Axram/CubeProject/README.md

# CubeProject
Bachelor project at KTH [1] during spring 2015, about balancing a cube using a reaction wheel

1: Royal Institute of Technology, Stockholm Sweden
