Axram/CubeProject/80%/80seminar.pptx

## 80% Seminar

Balancing cube

## Research question

- How does sensor placement effect the quality of the sensor data

## Current status

- Main construction finished
- Motor control
- IMU (until yesterday…)
- Encoder

## To Do’s

- Encoder!
- Control theory adjustments
- Wrap it up
