Axram/CubeProject/50%/PPT50.pptx

## Cube project

50% Seminar

## Research question

- ”If balance is maintained how does the maximum applied force correlate to the rise time and overshoot separately, can any conclusions be drawn from the results?”
- Could need an interation as it’s a bit focused on the control theory

## Current status

- Software Simulink model
- Hardware Main construction Motor IMU

## Future problems

- Software IMU filtering Implementing control theory
- Hardware Lathing the flywheel Mounting subsystems
