Axram/CubeProject/Thesis/kth-cover.pdf

DEGREE PROJECT, IN MECHATRONICS , FIRST LEVEL STOCKHOLM, SWEDEN 2015

# Reaction wheel balanced robot

## DESIGN AND SENSOR ANALYSIS OF INVERTED PENDULUM ROBOT

## ALEXANDER RAMM & MIKAEL SJÖSTEDT

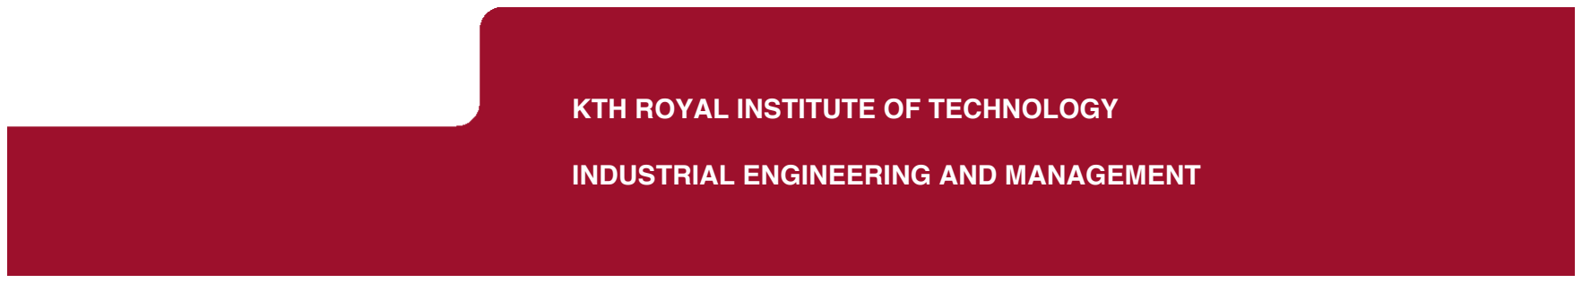
[picture p21: figure]
KTH ROYAL INSTITUTE OF TECHNOLOGY; INDUSTRIAL ENGINEERING AND MANAGEMENT

TRITA MMK 2015:18 MDAB071

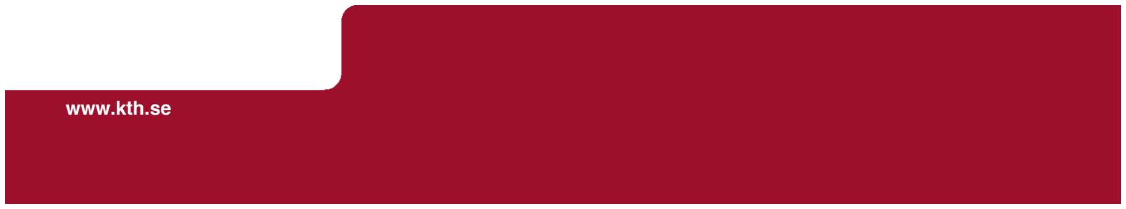
[picture p22: figure]
www.kth.se
