Axram/CubeProject/Thesis/Kalmanturnzoom-eps-converted-to.pdf

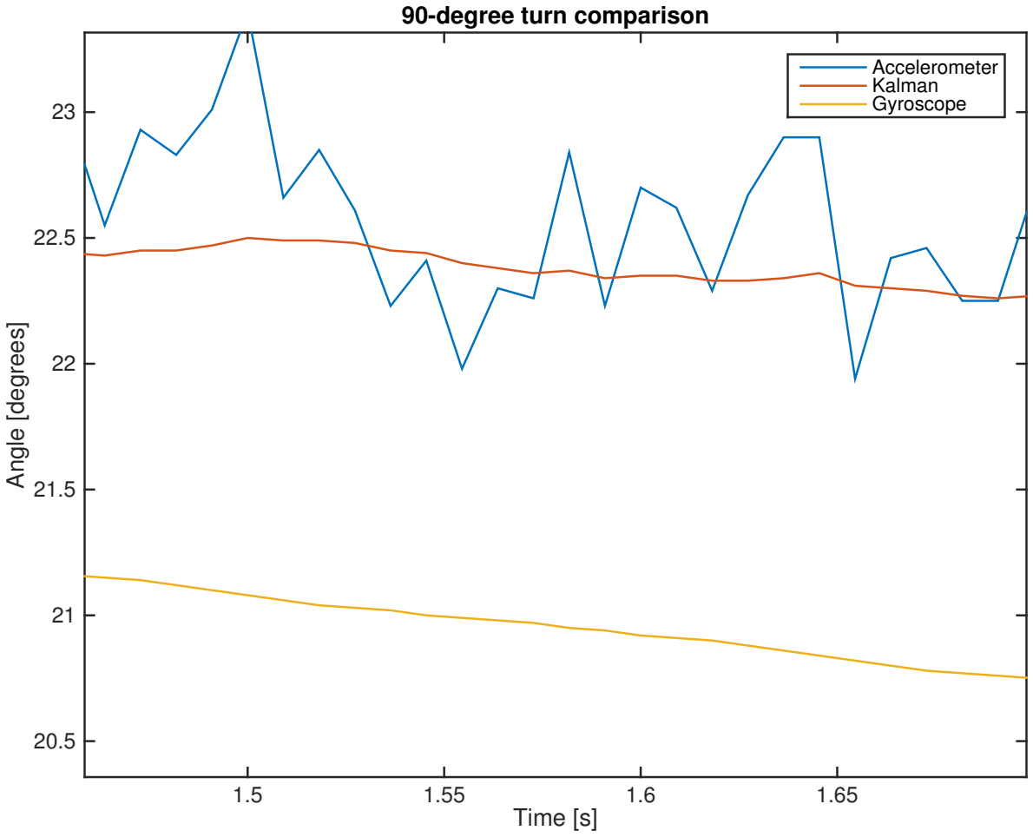
[picture p27: figure]
Time [s]; Angle [degrees]; 90-degree turn comparison; Accelerometer Kalman Gyroscope
