Axram/CubeProject/Mixed/reff kub.pdf

# Controlling the Reaction Wheel Pendulum

### Geoffrey Chauveau, Damien Chazal, Daisuke Nakayama Erik Olsen, Staffan Palm

### May 25, 2005

# Abstract

The goal of this project is to control a complicated mechanical plant. The plant is an inverted pendulum freely swinging around its axis. A DC-motor is attached at its outer end, running a heavy wheel which is freely spinning in the air. The only way to apply torque to the pendulum is to accelerate this wheel.
The motor and the wheel are too weak to swing the pendulum straight to its upright position, that is why energy must be accumulated over several swings to get it upright.
A model of the plant is derived from laws of physics and by doing tests and measurements. The model is verified by simulating step responses and comparing those to step responses of the real plant.
A hybrid automaton switches between two states depending on the position of the pendulum, the swinging state which swings the pendulum to the upright position and the balancing state which keeps the pendulum upright.
The swinging state uses a bang-bang energy controller to ensure the pendulum reaches the upright position with the right amount of speed.
The plant is time-continuous and the controller needs to be implemented in a time-discrete form. Two different approaches were used for the design of the balancing controller, depending on where the discretization was realized. Linear Quadratic (LQ) design of controllers has been used for both of these approaches.
The controller designed for a continuous plant works fine as long as the sampling frequency is higher than about 15 times the highest natural frequency of the plant. For lower sampling frequencies the discrete designed controllers gave better results. They worked well up to a sampling frequency of about 10 times the highest natural frequency, which fits well with classical rules of thumb.

# Contents

Introduction | 1
1 The Plant | 2
2 Control System | 10
3 Implementation and Development Environment | 24
Conclusion | 27
Bibliography | 29
Appendix | 30

CONTENTS | 3
A Tests | 30
B Filtering of Data | 35

# Introduction

This project is part of the project course in automatic control of the S3 department of the Royal Institute of Technology (KTH) in Stockholm. The goal of this school project is to control a complicated mechanical plant.
The plant is an inverted pendulum freely spinning around its axis moving thanks to a reaction wheel at its outer end.
Our aim is to swing the pendulum to the upright position and keep it stable. Sensors give information about the angles of the pendulum and the wheel, and the controller is implemented on a Texas Instruments digital signal processor. The final result will be a completely embedded system, which only needs power supply to run.
One industrial application of reaction wheels is to adjust the angles of satellites in space. This phenomenon is also observed in motorcycling: pilots use the acceleration of their rear wheels to tilt the angle of the motorcycle when they jump.

# Chapter 1

# The Plant

This chapter describes the pendulum and derives a mathematical model for it.

## 1.1 Description

The plant is an inverted pendulum freely spinning around its axis. A DC-motor is attached at its outer end. This motor runs a heavy wheel which is freely spinning in the air. The only way to apply a torque to the pendulum is to accelerate this wheel.
The motor and the wheel are too weak to swing the pendulum to its upright position in one swing. They need to add energy to the system with many swings to get it upright.
The system is based on a TI Digital Signal Processor that calculates the ouput, and an I/O daughter card that makes measurements using the two encoders and controls the DC motor using a PWM motor driver. The control system is built in C language, compiled and downloaded to a DSP memory.
Figure 1.1 shows the plant and some of the parameters.
Following is a complete list of the parameters (see Table 1.1).

## 1.2 Input and Output Signals

The output from the DSP, u, is a Pulse Width Modulated (PWM) signal. It means that the proportion of time when the signal is high is manipulated. This signal is sent to a motor driver chip (A3952) which transforms it to an analog signal. If this signal is a specific voltage or a specific current has been a subject of confusion. The chip is primarily designed to be a current control chip, though, after studying the circuitry and doing measurements of the output (see A.5 and A.6), it has clearly been shown that the controllable quantity is the voltage. The relation between the voltage and the PWM signal is unfortunately nonlinear. A nonlinear transfer function has been derived to calculate an PWM signal

1.2 Input and Output Signals | 3
θ | The angle of the pendulum with respect to ground, counted from upright position
˜θ | The angle of the pendulum with respect to ground, counted from downward position
ϕ | The angle of the wheel with respect to ground
ϕr | The angle of the wheel with respect to the pendulum
ω | The angular velocity of the wheel with respect to ground
ωr | The angular velocity of the wheel with respect to the pendulum
e | The back emf voltage from the motor
f | The torque between the wheel and the pendulum due to wet friction, ∼ 0 Ns/rad
g | The gravity constant, 9.81 m/s²
i | The current through the motor
Jp | The moment of inertia of the pendulum, 0.0045 kg.m²
Jw | The moment of inertia of the wheel and rotor, 2.13 · 10⁻⁵ kg.m²
kE | The back emf constant of the motor, 27.4 · 10⁻³ V.s/rad
kT | The torque constant of the motor, 27.4 · 10⁻³ N.m/A
l | The radius of the center of mass on the pendulum, including wheel, (mgl = 0.344 N.m)
L | The inductance of the motor, 6.27 mH
m | The mass of the pendulum, including wheel, (mgl = 0.344 N.m)
RT | The resistance of through the motor 12.1Ω
t | Time
Tg | The torque on the pendulum due to gravity
Tm | The torque applied by the reaction wheel to the pendulum
u | The output from the DSP, -10 to 10 (corresponds to the duty cycle of the PWM signal)
v | The voltage applied to the motor

Table 1.1: Variables and parameters of the project

1.2 Input and Output Signals | 4

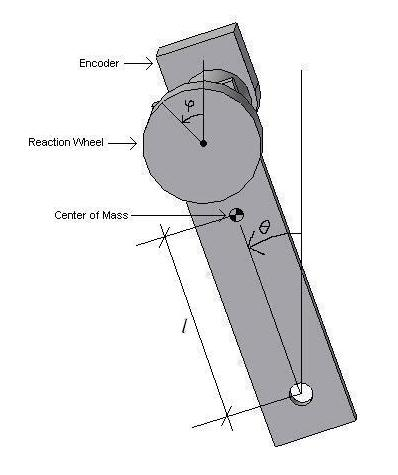
[picture p28: figure]

Figure 1.1: The different parameters of the plant.

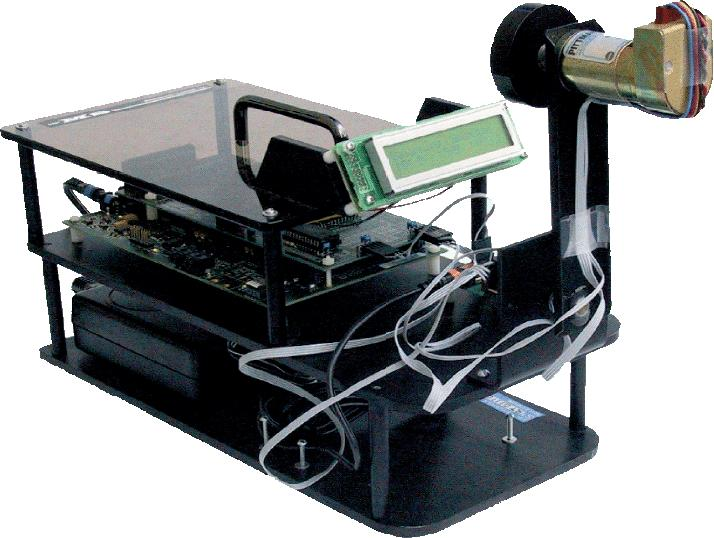
[picture p29: figure]

Figure 1.2: A picture of the whole plant.

from a demanded voltage (see A.8). The output from the controller should then be a voltage.
There are two output signals from the plant. The angle of the pendulum (θ) and the angle of the wheel (ϕ). The signals we are interested in for our controller are the angle of the pendulum (θ), the angular velocity of the pendulum (˙θ) and the angular velocity of the wheel (ω = ˙ϕ).

1.3 An Analytical Model | 5

The angular velocities are derived by differentiating the angles. The Euler backwards method is used for this. The angular velocities need to be filtered to reduce noise. The filter design is presented in Appendix B.
The angles of the wheel ϕr and the pendulum θ can be measured from two embedded encoders: the encoder on the motor can measure the angle of the wheel ϕr, and the optical shaft encoder of the pendulum measures its angle θ.
- DC Servo Motor

– Reference Voltage: 24 V

– Encoder Resolution: 1000 CPR

- Optical Shaft Encoder

– Encoder Resolution: 1000 CPR

## 1.3 An Analytical Model

The motor is a DC-motor whose equations are:

v = RT i + L

di
dt
+ e | (1.1)
e = kE(ω − ˙θ) | (1.2)
−Tm = kT i | (1.3)

The time constant for this inductance-resistor system equals to

τL =

L
R
= 0.518 ms | (1.4)

which is very much faster than the other dynamics in the plant. The fastest pole of the remaining system lies, according to 1.5.1, in -8.7473, which corresponds to a time constant of 114 ms. Hence this inductance is neglected.
The motion of the wheel and the pendulum is given by the torque equation:
Jwϕ¨ = Jwω˙ = −Tm − f(ω − ˙θ) | for the wheel | (1.5)

Jp

¨θ = Tm + Tg + f(ω − ˙θ) | for the pendulum with | (1.6)
Tg = mglsin θ | (1.7)

and the friction between the pendulum and ground is neglected according to A.3.
With the state variables isolated the equations become

1.4 Change of the State-Space Variables | 6

ω˙ = −

f
Jw

+

kEkT
JwRT
ω +
f
Jw

+

kEkT
JwRT
˙θ +

kT
JwRT
v | (1.8)

¨θ =

f
Jp

+

kEkT
JpRT
ω +

lmg
Jp

sin θ −

f
Jp

+

kEkT
JpRT
˙θ −

kT
JpRT

v (1.9)

The system can be linearized and described in state-space form with state xa = (ω, θ, ˙θ)
T and input voltage v.
x˙ a = Aaxa + Bav | (1.10)

where

Ba =

kT
JwRT
0
−

kT
JpRT
- (1.11)

and Aa depends on the linearization point. Linearizations around the two equilibrium points give:

θ around 0
(sin θ ∼ θ)

: Aa =

−

f
Jw

−

kEkT
JwRT

0

f
Jw

+

kEkT
JwRT
0 | 0 | 1

f
Jp

+

kEkT JpRT | lmg
| Jp

−

f
Jp
| | −

kEkT
JpRT
- (1.12)

θ around π
(sin θ ∼ −(θ − π))
θ substituted to ˜θ according to ˜θ = θ − π

: Aa =

−

f
Jw

−

kEkT
JwRT

0

f
Jw

+

kEkT
JwRT
0 | 0 | 1

f
Jp

+

kEkT JpRT | −lmg
| Jp

−

f
Jp
| | −

kEkT
JpRT

(1.13)
Different tests are performed to find out the values of the parameters, see A

## 1.4 Change of the State-Space Variables

The linearized model has been derived with absolute angles. However, to simplify the design of the controller with respect to the measured signals from the sensors, the use of the relative speed of the wheel is more relevant. Thus a change of the state variable ω must be done: ωr = ω − ˙θ.
If the state equation is denoted in this way:

ω˙
˙θ
¨θ
- = Aa

ω
θ
˙θ
- + Ba v

1.5 Analysis of the System | 7

then the modified state space equation with ωr is:

ω˙r
˙θ
¨θ
- = P Aa

ωr
θ
˙θ
- + P Ba v with P =

1 0 −1
0 1 | 0
0 0 | 1

New variables are defined according to x = (ωr, θ, ˙θ)
T
, A = P Aa and B =
P Ba.
The system is now described by
x˙ = Ax + Bv | (1.14)

## 1.5 Analysis of the System

### 1.5.1 Investigation of Poles and Zeroes

Our system has three poles and one zero. Figure 1.3 shows the location of the poles and zeroes for the linearization around the unstable equilibrium point. The pole in the right half plane shows that the system is unstable. The poles are located in (8.7164, -8.7473, -2.9093) and the zero is in the origin.
The two poles that are symmetrical around the origin are due to the inverted pendulum and the third pole (-2.9093) is due to the reaction wheel.
The zero can be explained by the fact that the wheel needs to be accelerated to get a torque on the pendulum, which requires changes in the voltage.

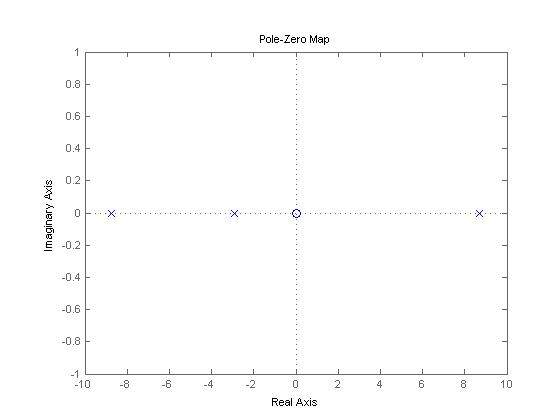
[picture p30: figure]

Figure 1.3: Poles and Zeros of the linearized model in the upright position.

1.6 Validating the Analytical Model | 8

### 1.5.2 Controllability and Observability

To be able to fully control the system it needs to be controllable. Therefore, the controlability matrix QC is calculated.

QC =

B AB A²B
=

106.8041 −314.0222 961.4548
0 | −0.5013 | 1.4739
−0.5013 | 1.4739 | −42.5101

Since det QC 6= 0, the process is fully controllable. All the states can then be controlled with the input signal v.
θ is measured directly with an encoder. The two other states, ˙θ and ωr are derived by differentiation (and filtering) of the sensor signals. Obviously our plant is observable as well.

## 1.6 Validating the Analytical Model

The analytical model derived in 1.3 will be verified by comparing its step response to a step response from the plant. Figure 1.4 shows the output signals θ and ωr for both the model and the process for a 10 volt step. Figure 1.5 shows the same data for a 5 volt step.

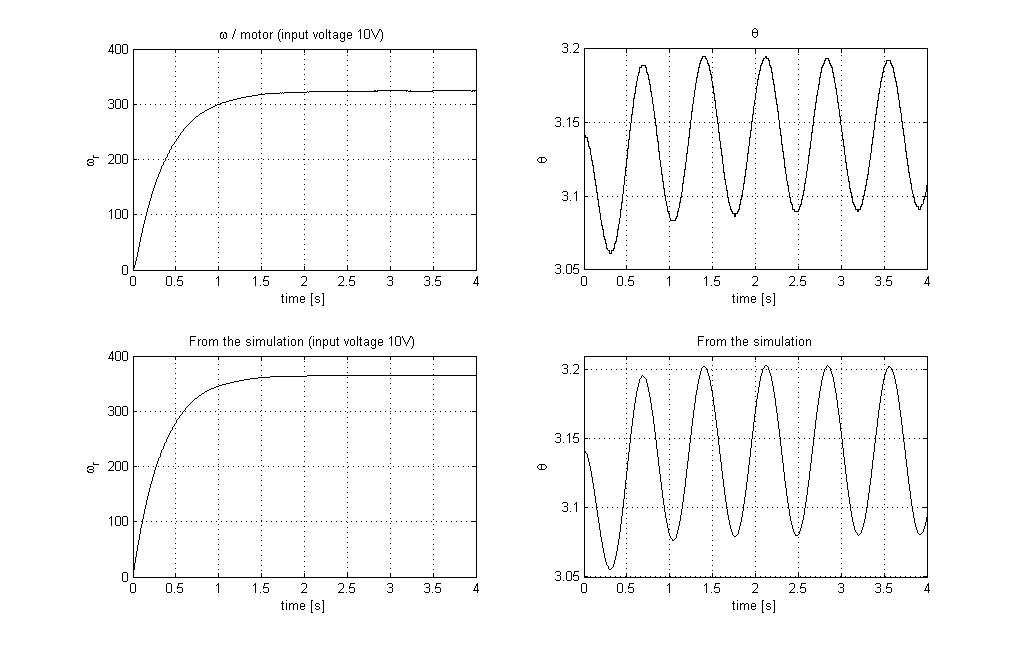
[picture p31: figure]

Figure 1.4: Output signals from model and process for a step of 10 volts.

The behaviours of the systems are very similar. The steady state angular velocity of the wheel ωr is always about 40 rad/s lower in the process than in

1.6 Validating the Analytical Model | 9

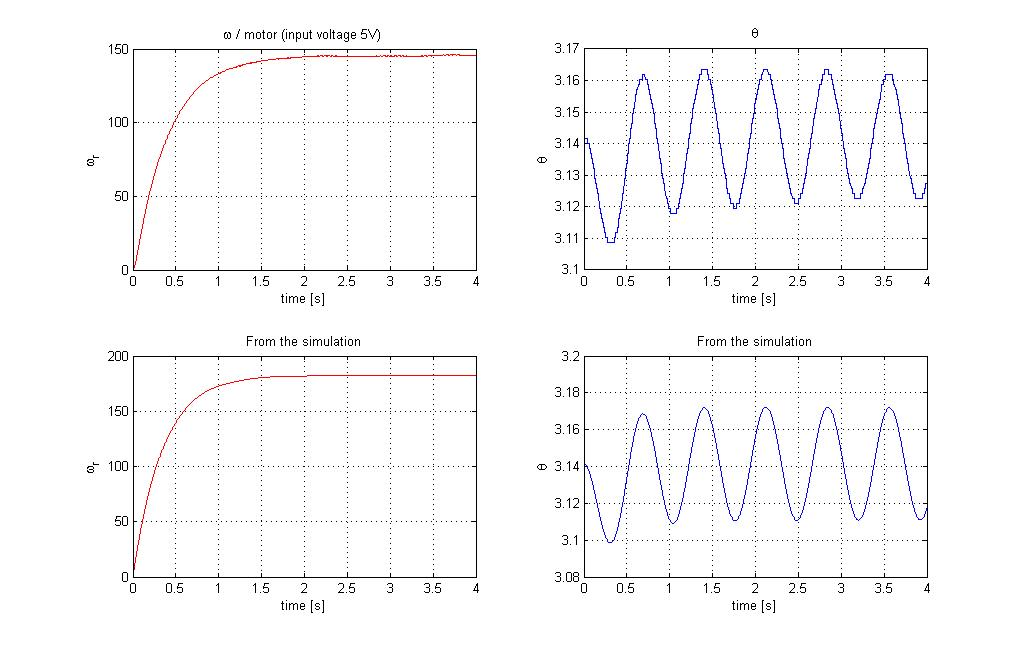
[picture p32: figure]

Figure 1.5: Output signals from model and process for a step of 5 volts.

the model, independent of the level of the input voltage, probably because of the neglected dry friction.

# Chapter 2

# Control System

The control system switches between different states. The hybrid automaton and the different controllers will be described in this chapter.

## 2.1 The Hybrid Automaton

The controller is implemented as an hybrid automaton that switches between two states during normal operation; the swinging state to swing the pendulum up and the balancing state to keep the pendulum in the upright position.
As Figure 2.1 shows, the active state depends on the position of the pendulum. The swinging state is active from the initial downward position until the pendulum enters the catch area around the upper position, where the balance controller is activated instead. The possible size of the catch area depends on the strength of the balance controller and the precision of the swing up function. Tests showed that a catch area starting 8 degrees from the top position worked fine.
Extra features can also be seen as states, for example the brake to return the pendulum to the downward position or to prevent the pendulum from damaging the cables.

## 2.2 The Swinging State

This chapter describes two ways of swinging up the pendulum.

### 2.2.1 Simple Swing Up

The aim of this controller is to make the pendulum go up as fast as possible. A solution is to give maximum torque to the pendulum to increase its speed in the direction it is going. The following controller was built:
u = −9 when ˙θ ≥ 0

2.2 The Swinging State | 11

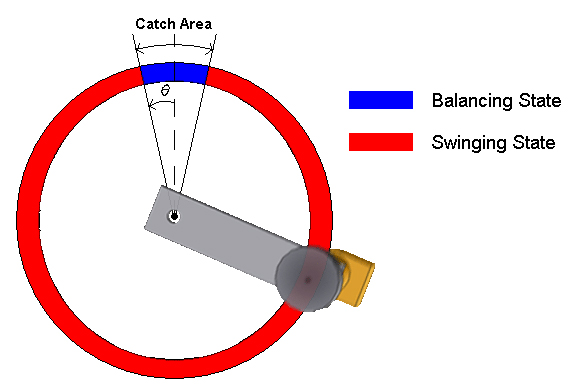
[picture p33: figure]

Figure 2.1: The two states depending on pendulum angle.

u = 9 when ˙θ < 0

It works pretty good but the angular velocity of the pendulum is often too high when it enters the catch area.

### 2.2.2 Energy Controlled Swing Up

To be able to make the pendulum arrive at its upright position with the right amount of speed, the total energy of the pendulum is monitored. For every sample, the energy of the pendulum is calculated as E =
1/2 Jp

˙θ
2 + mgl cos θ.
To validate the energy calculations, the total energy of a freely swinging pendulum was observed. Figure 2.2 shows the result. As expected, it was almost constant, decreasing slowly due to friction.
The target value for the total energy is the potential energy of the pendulum at the top position
| E0 = mgl

The controller is a simple bang-bang controller, accelerating when the energy is below the target value and braking when the energy is too high.
The final swing controller is:
| E < E0 | E ≥ E0
˙θ ≥ 0 | u=-9 | u=9
˙θ < 0 | u=9 | u=-9

The high braking values are useful when the pendulum is put to higher energy levels because of external disturbances.

2.3 The Balancing State | 12

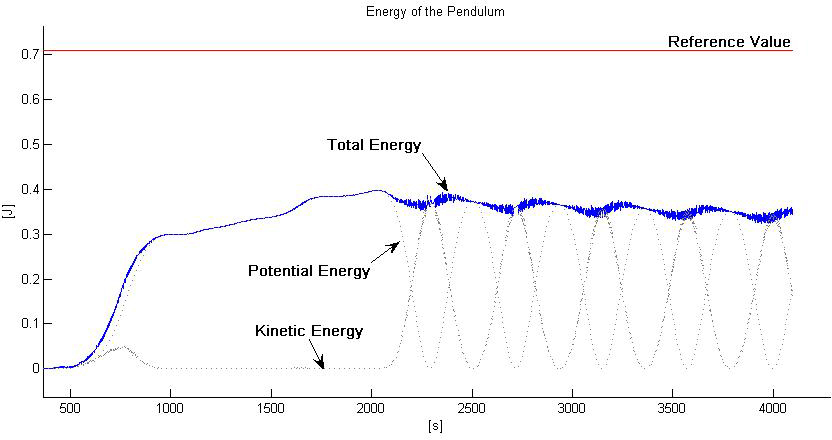
[picture p34: figure]

Figure 2.2: Energies of the pendulum when lifted and then released to swing freely.

## 2.3 The Balancing State

After being moved by the swinging process to its upright position, the pendulum is supposed to be in the linearized region around θ ∼ 0. Thus in the following section, the plant refers to the linear model that was derived previously for the upright position.

### 2.3.1 Preliminary Analysis of the Control System

Analysis of the Closed-Loop System

In our case, the plant is time-continuous and the implemented controller must be time-discrete since it is based on the sampled measurements of the system outputs. The control system of the plant can be represented by the block diagram on Figure 2.3.
The input signal is the voltage v and the output of the plant is y = (φr, θ)

T
The measurement of y consists of a uniform sampling at the sampling frequency

1
h

. In the feedback loop the controller computes a discrete command signal v[k] from the discrete outputs up to y[k]. Finally, a continuous input signal v(t) is generated after a zero-order hold circuit.

2.3 The Balancing State | 13

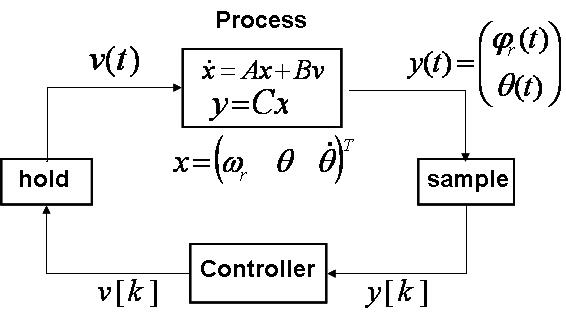
[picture p35: figure]

Figure 2.3: General block diagram of the controlled plant

Two Approaches of Controller Design

Two different methods are then available for the design of the discrete controller (see figure 2.4): a continuous-time design and a discrete-time design. The first one consists in building a continuous controller from the continuous model of the plant, and then discretizing it. The second one requires a preliminary discretization of the plant in order to build a completely discrete controller. These two approaches will be studied and compared in the next parts.

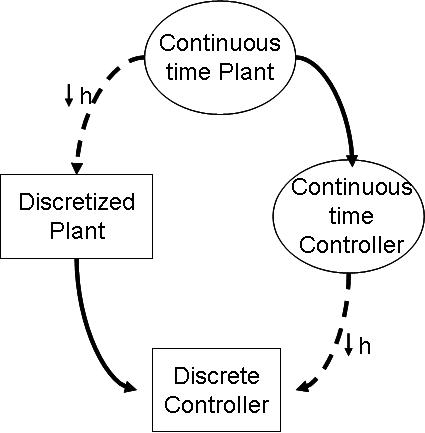
[picture p36: figure]

Figure 2.4: Design in continuous time and in discrete time.

2.3 The Balancing State | 14

### 2.3.2 Design in Continuous Time

In this part a controller based on the continuous plant is studied. This controller calculates the command signal v from the two outputs of the system φr and θ. However, an efficient controller should also depend on ωr and ˙θ. Therefore, state feedback controllers have been studied in this project.

The State Feedback Controller

In order to estimate the state variables x = (ωr, θ, ˙θ)
T
| , the angles φr and θ have
to be differenciated in the feedback loop. This operation is represented by the transfer function F(s) called a state observer, even though it is not really an observer. The feedback controller is called C(s) and is a linear combination of the state variables:
v = kωωr + kθθ + k ˙θ

˙θ

Figure 2.5 shows a block diagram of the continuous-time control system. The part that will be implemented on the real system corresponds to the dashedline rectangle. The discretization is realized by approximating the derivatives in F(s) with an Euler backward approximation: s =

z−1
| zh . The discrete controller is
represented in the block diagram in Figure 2.6.

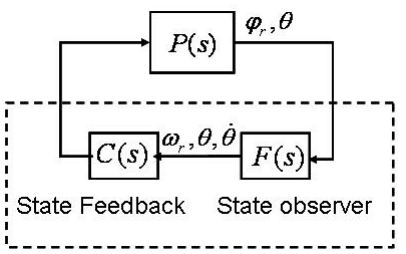
[picture p37: figure]

Figure 2.5: Block diagram of the continuous-time state feedback control system.

PD Controller

Since the variable of interest is θ, it is natural to investigate a controller in this form: v = kθθ + k ˙θ

˙θ, which is similar to a PD controller of the angle θ. In order to determine the coefficients (kθ, k ˙θ

), a pole placement analysis is performed. First, let us consider the transfer function Θ(s)
V (s)

, from the input voltage
to the pendulum angle:

Θ(s)
V (s)

=

−0.5013s
s

3 + 2.94s

2 − 76.15s − 221.8

2.3 The Balancing State | 15

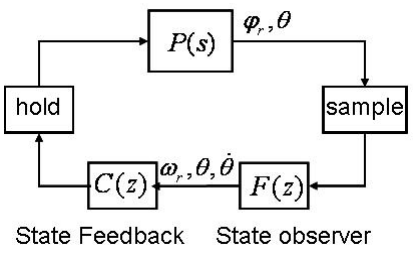
[picture p38: figure]

Figure 2.6: Block diagram of the real state feedback control system.

Generally speaking, since it is a single-input system, the linearized system around the upright position can lead to three separated transfer functions from the input voltage v to each state variable ωr, θ and ˙θ.
The plant can now be considered as a single-input single-output (SISO) system. The derivative part of the controller (k ˙θ

) introduces a zero on the real axis. If k ˙θ

is fixed, it is possible to plot the root locus of the closed-loop system, that is to say the closed-loop pole trajectories as a function of kθ. Figure 2.7 shows the root locus when k ˙θ = 6.6. The controller’s zero is represented by a triangle whereas the poles and zeroes of the plant are respectively crosses and circles. The three squares are the three closed-loop poles showing the location of the three different pole trajectories. The root locus shows that wherever the PD zero is placed, the closed-loop system will remain unstable due to the closed-loop pole on the positive real axis.

Complete State Feedback Controller

A more complete feedback controller must be used, using a feedback on the speed of the wheel ωr. Such a controller can be written as follows: v = kωωr +kθθ +k ˙θ

˙θ
In order to keep on analyzing the SISO system represented by the transfer function Θ(s)
V (s)

, the feedback on ωr is included in the state space representation:

x˙ = (A − BL)x + Bv , with L = (kω 0 0)

It is then possible to plot the root locus when kω = 0.1 and k ˙θ = 6.6 (see Figure 2.8). The closed loop system is now stable because all the closed-loop poles can be moved to the left part of the real axis. It is important to notice that the plant now has two unstable poles, which is due to the feedback loop on ωr. The following state feedback controller will be evaluated regarding stability and speed:
v = 0.1ωr + 400θ + 60 ˙θ

2.3 The Balancing State | 16

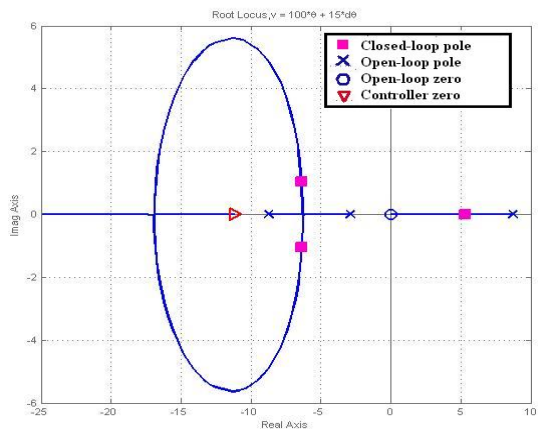
[picture p39: figure]

Figure 2.7: Root locus of the closed-loop system using a PD controller, k ˙θ = 6.6.

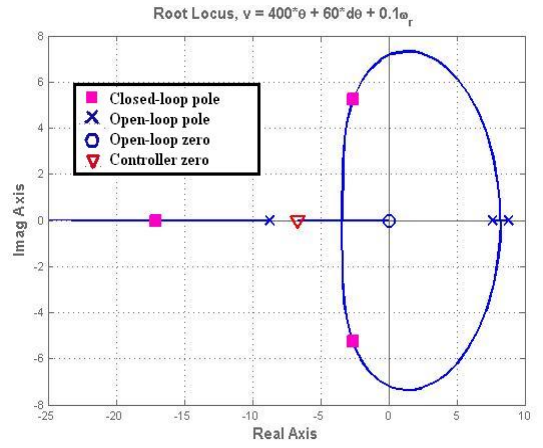
[picture p40: figure]

Figure 2.8: Root locus of the closed-loop system using a feedback controller, k ˙θ = 6.6 and kω = 0.1.

First of all, the Nyquist diagram of the open-loop is illustrated in Figure 2.9. According to the Nyquist criterion, the closed loop system is stable since there are two turns around -1, which is the exact number of positive real-part poles. Furthermore, the gain and the phase margins are respectively Gm = 3.93dB and

2.3 The Balancing State | 17

φm = 41.2

◦

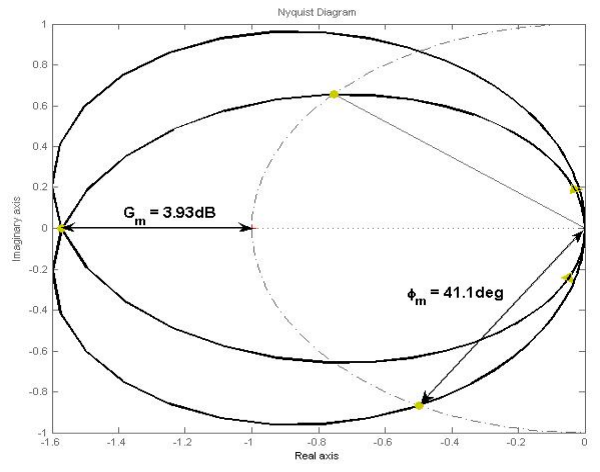
[picture p41: figure]

Figure 2.9: Nyquist diagram of the state feedback controller: v = 0.1ωr + 400θ + 60 ˙θ.

In the following acquisitions, the sampling period h is 1 ms. In Figure 2.10, the response to a step disturbance of 15V is illustrated. This experiment is done when the pendulum is stabilized around θ = 0. A disturbance signal of 15V is then added to the control signal, making the pendulum move away from its equilibrium point. The simulated and measured responses have the same behaviour exept for the final overshoot which is much higher for the real system. This is probably due to unmodelled nonlinearities. The conclusion is that in order to increase stability, it is necessary to avoid overshoots, since they become higher in reality.

LQ Controller

A method to design the coefficients (kω, kθ, k ˙θ

) for optimal performance is to use a Linear Quadratic (LQ) controller. Such a control law v is derived by minimizing a cost function depending on the weights Q, R and N:
J(v) = Z ∞

0

(x

TQx + v

TRv + 2x

TNv)dt

where x and v are linked to the state space equation : ˙x(t) = Ax(t) + Bv(t). Q and R are chosen in this way:

Q =

1 0 0
0 1 0
0 0 0
- R = 100 N = 0

2.3 The Balancing State | 18

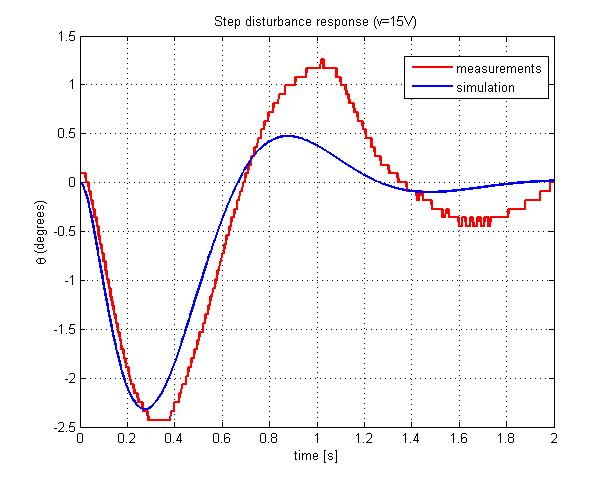
[picture p42: figure]

Figure 2.10: Step disturbance response (15V) for v = 0.1ωr + 400θ + 60 ˙θ

The choice of Q lies on the fact that more emphasis should be given to θ and ω. R is just a scaling factor and is set to 100 in order to avoid having a too high command voltage v that could saturate. Finally, N is equal to 0 because the cost due to the correlation between x and v has been neglected. For linear systems, there is a unique solution v = −Kx to this minimization which is expressed as the solution to the Riccati equation:

K = R

−1B
T S with SA + A

T S + Q − SQR⁻¹B
T S = 0

The numerical solution is then:

v = 0.1311ω + 688.1082θ + 78.9278 ˙θ

The Nyquist diagram is shown in Figure 2.11. The gain margin Gm = 6dB is much larger in this case and the phase margin φm = 60◦
is a characteristic value
for LQ controllers. The simulated and measured responses to a step disturbance of 15V illustrate this improved stability of the system (see Figure 2.12). The sampling period is still h = 1ms.
The LQ-controller that has been designed from the continuous plant leads to stable results as long as the sampling period is very small (≈ up to 50 ms as shown in Figure 2.13). This is due to the fact that the coefficients (kω, kθ, k ˙θ

)
do not depend on the sampling period, making the control system unadapted to every h. A way to tackle this problem is to take into account the transfer function of the zero-order-hold circuit ( ¹⁻e⁻sh
sh ) (see Figure 2.3) for the design of the continuous-time controller. Then C(s) should be based on P(s)
| 1−e⁻sh
| sh

2.3 The Balancing State | 19

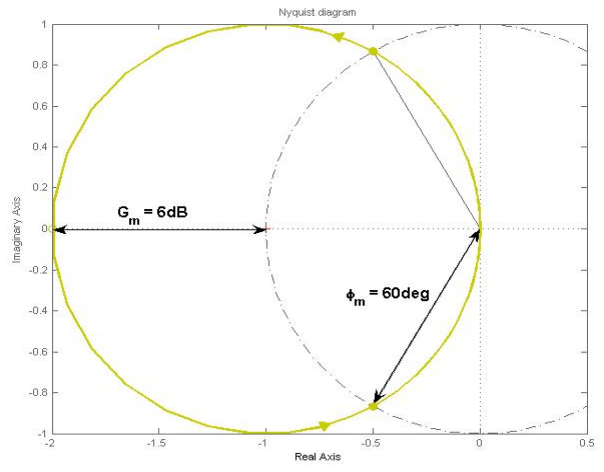
[picture p43: figure]

Figure 2.11: Nyquist diagram for the LQ-controller.

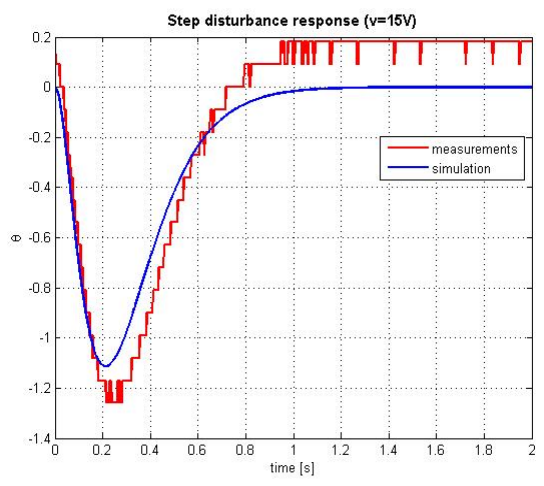
[picture p44: figure]

Figure 2.12: Step disturbance response (15V) for the LQ-controller.

instead of P(s). Unfortunately, this is not possible in our multivariable case because a single transfer function for the whole system P(s) can not be extracted. Consequently, the discrete approach of controller design will be investigated in order to handle different sampling periods.

2.3 The Balancing State | 20

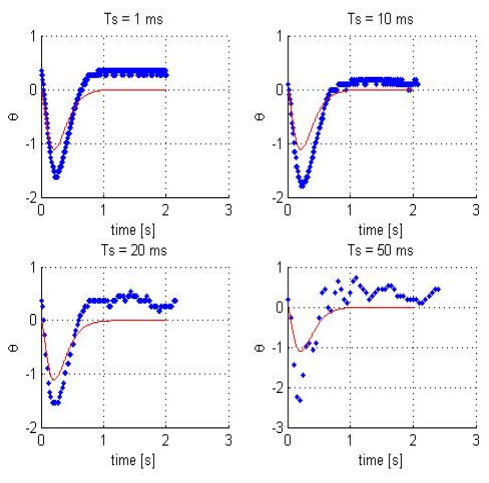
[picture p45: figure]

Figure 2.13: Step disturbance responses (15V) for the LQ-controller for different sampling periods.

### 2.3.3 Design in Discrete Time

Instead of estimating a discrete controller from a continuous one, another approach to control the pendulum is to build a discrete controller directly from the discrete model of the pendulum.

Discretized Plant

Around the equilibrium point, the system is almost linear, with the state-space equation ˙x = Ax+Bv. The plant can be sampled with a zero-order hold as input (since the computed input sent by Code Composer Studio is constant during the sampling period) and the resulting discrete system is:

x[k + 1] = Ad(h)x[k] + Bd(h)v[k]
with Ad(h) = e

Ah

, Bd(h) = R h
0

e

AsBds and h the sampling period

2.3 The Balancing State | 21
h[ms] | kωr | kθ | k ˙θ
1 | -0,12977 | -682,35 | -78,267
10 | -0,11873 | -633,95 | -72,712
50 | -0,083278 | -476,62 | -54,655
70 | -0,071475 | -423,13 | -48,515
80 | -0,066614 | -400,83 | -45,957
90 | -0,062329 | -381 | -43,681
100 | -0,058544 | -363,34 | -41,654
120 | -0,052235 | -333,47 | -38,228
150 | -0,045205 | -299,38 | -34,315

Table 2.1: Coefficients of the LQ controller for different sampling periods.

Discrete LQ Controller

After discretizing the plant, a discrete LQ controller can be designed. This controller is such that the cost function

Jd(v) = X∞

n=1

x[n]

TQdx[n] + v[n]

TRdv[n] + 2x[n]

TNdv[n]

is minimized. Since we want the same properties as the continuous LQ-controller, the matrix Qd, Rd and Nd are obtained by discretizing the matrix Q, R and N of the previous controller:
Qd Nd
NT
d Rd
=

Z h

0

Ad(τ ) 0
Bd(τ ) I
Q | N
NT | R

Ad(τ ) Bd(τ )
0 | I
dτ

With Matlab, different controllers v = −

kωrωr + kθθ + k ˙θ

˙θ

are easily obtained
for different sampling times (see Table 2.1).
After implementing this controller for different sampling periods, we observed that it works quite good up to 80 ms and begins to be unable to control the pendulum after a sampling period of 120 ms. Then, for higher sampling periods, the limit of the sampling is reached: a rule of thumb says indeed that h should be chosen such that 0.2 < ω0h < 0.6, with ω0 the natural frequency of the system (here ω0 = 8.75 rad/s). Therefore, we should not use sampling periods higher than 69 ms, which can explain the problems we have with high sampling periods. Then, some tests were done to investigate the stability of these controllers: a step of 5V is added to the calculated input of the system. We clearly observed that the system is less stable and oscillates more for high sampling periods (see Figure 2.14). The amplitude of the oscillations seems to be about proportional to the sampling time for such low sampling frequencies.

2.3 The Balancing State | 22

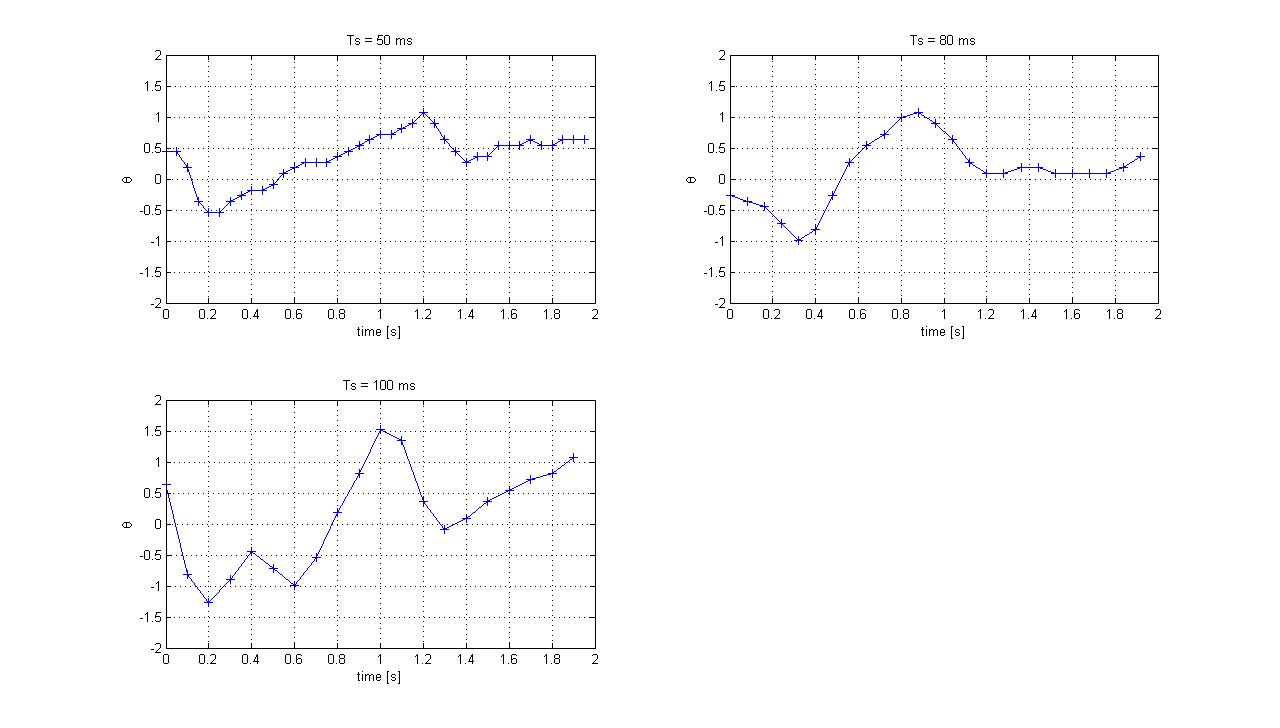
[picture p46: figure]

Figure 2.14: Stability of different discrete LQ controllers with sampling periods of 50ms, 80ms and 100ms.

Deadbeat Controller

Another idea was to build a completely discrete controller that has no equivalent in the continuous time-domain. The Deadbeat controller is a discrete controller that drives the state to the origin in at most n steps, with n the number of states variables (here n = 3). The controller is a state feedback v[k] = −Lx[k]. The state space equation then becomes:

x[k + 1] = (Ad − BdL)x[k] = Ac(L)x[k]

If the characteristic polynomial of Ac(L) is P(X), then we have

P (Ac(L)) = 0M3(R) (Cayley-Hamilton theorem)

The DeadBeat controller is such that all closed-loop poles are put at the origin (ie P(X) = X³

). Therefore, (Ac(L))³ = 0 and

x[n] = (Ac(L))n
x[0] = 0 if n ≥ 3

With Maple and Matlab, different matrices L = (lωr , lθ, l ˙θ

)

T were derived
depending on the sampling period h (see Table 2.2).
A simulation is done for h = 80ms and the controller seems to work perfectly: θ goes to zero in three steps (see Figure 2.15). However the coefficients for low

2.3 The Balancing State | 23
h[ms] | lωr | lθ | l ˙θ
1 | −1, 2371 · 10⁵ | −3, 9951 · 10⁶ | −2, 636 · 10⁷
10 | -125,3 | -40564 | -27060
50 | -1,0733 | -1838,3 | -301,96
70 | -0,4137 | -1028,5 | -141,17
80 | -0,28741 | -829,4 | -108,06
90 | -0,21064 | -692,39 | -86,94
100 | -0,16126 | -594,13 | -72,674
120 | -0,10489 | -465,84 | -55,195
150 | -0,066718 | -360,94 | -41,877

Table 2.2: Coefficients of the Deadbeat controller for different sampling periods.

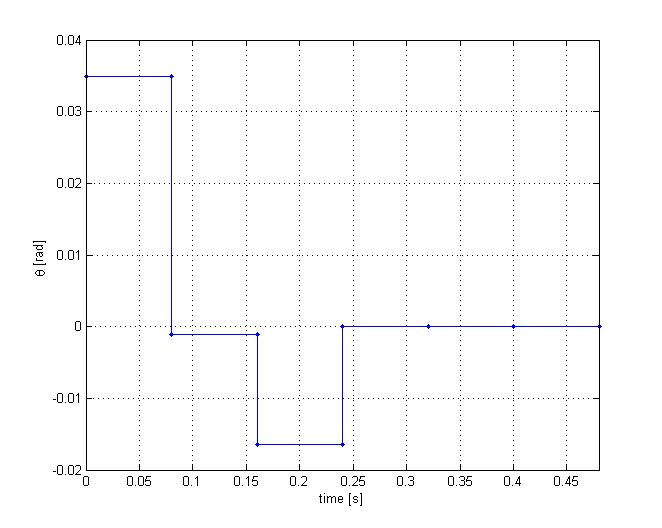
[picture p47: figure]

Figure 2.15: Simulation of the Deadbeat controller with h=80ms.

sampling periods are not realistic: the input voltage must reach several hundreds of volts to stabilize the system rapidly (in a few milliseconds). In practice, a sampling period of 80ms is the minimum for the input signal not to saturate. The problem is that the pendulum is not stable for a long time: after a few seconds, the pendulum falls down. This comes from the fact that this controller is very fast and therefore not very stable. Moreover, the sampling period is certainly too high to have an efficient controller (h > 69 ms).

# Chapter 3

# Implementation and Development Environment

## 3.1 Implementation

The implementation of the controller has been realized in Code Composer Studio. This software is used to compile a C-language program and then load it on a DSP card. We were given a collection of basic functions used for the interface with the daughter card but except these functions, everything has been implemented right from the beginning.
All the control algorithms are performed in a periodic function. This periodic function runs every millisecond and has the following structure:
- Tasks in the Periodic Function
1. Set the previous values of Theta and Phi

– ThetaPrevious = Theta
– PhiPrevious = Phi
2. Get data theta and phi from encoders

– ReadFromEncoders(Theta, Phi)

3. Calculate angular velocities

– DTheta = (Theta - ThetaPrevious) / h – DThetaFiltered = filter(DTheta)
– DPhi = (Phi - PhiPrevious) / h
– DPhiFiltered = filter(DPhi)
4. Calculate the output

– Output = controller(DphiFiltered, Theta, DThetaFiltered)

5. Send the output signal to the motor
6. Write information on the LCD

3.2 User Interface | 25

The sampling period is increased artificially by making the periodic function enter an idle loop for a certain time. The reason is that it is then possible to use different sampling periods only by pressing a switch. Of course the periodic function can be specified to run every sampling period in order to study the real effects of the sampling rate on computation time. However, since the CPU-load was always below 5% , it was useless to consider such limitations.

## 3.2 User Interface

An interaction with the system was made possible thanks to a set of switches and LEDs whose actions were parameterized in the software. Moreover, several buffers and log files have been used for data acquisitions since they were not performed in real time.

### 3.2.1 LCD

The display is the main part of the user interface and has also been used for debugging. The state of the hybrid automaton, the controller name, the angle of the pendulum, the output voltage and the sampling period are shown on the LCD (see Figure 3.1)

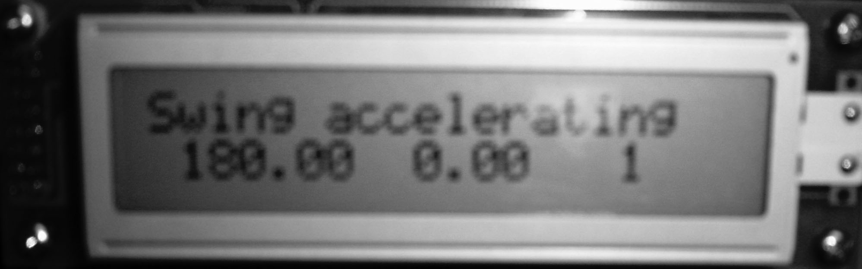
[picture p48: figure]

Figure 3.1: User interface: controller, angle θ, input voltage v, sampling period [ms].

3.2 User Interface | 26

### 3.2.2 Switches

Three switches are used to choose a controller and initialize encoders. As shown below, four types of experiments can be done.

SW1 SW2 SW3 | Controller
OFF OFF OFF ON OFF OFF ON ON OFF OFF ON OFF OFF ON ON ON ON ON | No Control Continuous LQ Controller (Sampling time: 1[ms]) Continuous LQ Controller (Sampling time: 80[ms]) Discrete LQ Controller (Sampling time: 80[ms]) Deadbeat Controller (Sampling time: 80[ms]) Initialize two encoders

# Conclusions

During this project, two different approaches were used to design controllers: estimate a discrete controller from a continuous one or create a discrete controller directly from a discretized model of the plant. The second approch gave better results, since LQ-controllers created this way were especially designed for particular sampling times. The Deadbeat controller seemed to be a good idea, but it was not possible to implement it properly.
The controllers that were obtained worked well and were quite efficient, which shows that our modelling of the system was quite accurate. The energy controller swings the pendulum up rapidly and makes it arrive in the catch area with low speed; both continuous and discrete LQ-controllers stabilize the pendulum quickly. Moreover, the balancing controllers were really robust to disturbances (a step of 20 volts could be added to the continuous LQ-controller at high sampling frequencies without problem). For lower sampling frequencies, when the discre LQ-controllers were used, the effects of the disturbance on control signals seemed to be about proportional to the sampling time.
However, what was not expected in this project was all the problems encountered with hardware and software. The biggest issue was handling Code Composer Studio. Most of the problems occured because of this software and it took several weeks to do all that we wanted with it. That is why this was the most difficult part of the project. The other problems came from the sensor of the wheel that did not work properly, the LCD controller that was difficult to implement and other side tasks. Therefore, most of the time was not spent on automatic control but on solving hardware and software problems.
But the fact that we began from a point where almost nothing was implemented in the software gave us control on everything we did: the use of periodic functions, the acquisition of data from sensors, the implementation of controllers... This allowed us to avoid many unexpected results and deal with problems more easily when they occured.

Of course, this project was limited in time and some points could have been improved. For example, the modelling could have been done by using the System Identification Toolbox of Matlab. This could have given us a more accurate model, especially for all disturbances and frictions that were neglected. However,

3.2 User Interface | 28

we were able to build controllers from our model that were satisfying. More important, an observer can be used to derive the state variables we cannot measure directly (˙θ and ωr), instead of calculating them by Euler approximation. This gives often better results. Finally, other kinds of controllers than state-feedback ones can be used: some built from a non-linear model (like exact feedback linearization) or other independant of the model (like a fuzzy controller).

This project was the opportunity for us to experience the topic of embedded systems. This requires a knowledge of many different fields such as modelling, signal processing, control theory and computer science. Consequently, it was an asset (quite unexpected) to have team members with different technical backgrounds. This course helped us to become familiar with project management and team work for a long period. Finally, we learnt a lot during these two months and had a pleasure doing this project.

# Bibliography

- Reglerteori - Flervariabla och olinj¨ara metoder - Torkel Glad and Lennart Ljung
- Hybrid and Embedded Control Systems - Lecture notes - Karl Henrik Johansson (KTH)
- Automatique 2003 - Compendium - Collectif automatique (Suplec)
- Nonlinear Control - Lecture notes - Karl Henrik Johansson and Bo Wahlberg (KTH)

# Appendix A

# Tests

## A.1 Measurement of mgl

With the pendulum horizontal, a scales was placed under the wheel to measure the weight of the pendulum. The radius where the scales was located was also measured. Using the measured values, the torque mgl can be calculated.

m = 0.27 kg, | l = 0.13 m, | g = 9.81 m.s⁻²
| mgl = 0.344 N.m
A.2 | Measurement of Jp

The moment of inertia Jp can be calculated by using the pendulum equation (1.9) without frictions or running the motor, linearized around the lower equilibrium point.

| ¨θ + mgl Jp
θ = 0 | (A.1)

Solving this differential equation and isolating Jp gives

| Jp = mgl
(
| 2π T
)
| 2

(A.2)

Where T is the period time for small pendulum oscillations, measured to be 0.72s. We will find that
| Jp = 0.0045 kg.m²

A.3 Measurement of Pendulum Friction | 31
A.3 | Measurement of Pendulum Friction

The friction is calculated from the time constant for the decrease in pendulum amplitude. This is done by measuring the time it takes for the pendulum amplitude to decrease from a known initial value to a predetermined end value.

fp = 5 · 10⁻⁵
kg.m²
s

−1

In comparison with the torque from gravity, T = 1.55 N.m, the torque due to friction will be very small for all reasonable angular velocities. Hence fp will be neglected.

## A.4 Measurement of Jw

The wheel has the shape of a cylinder, whose inertia can be derived as

Jcylinder =

mR²
2

(A.3)

The inertia of the rotor in the DC-motor then needs to be added to get the total inertia.

Jw = Jcylinder + Jrotor | (A.4)

and it resulted in

Jw =

mR²
2
+ Jrotor | (A.5)

The measurements and data are

m = 0.065 kg, | R = 0.025 m, | Jrotor = 9.89 · 10⁻⁷
kg.m²

which results in

| Jw = 2.13 · 10⁻⁵ | kg.m²
A.5 | Motor Driver A3952 Test 1

The voltage and the current was measured at different PWM outputs from the DSP, both when the wheel was running at constant speed and when it was held still. Following are the results:
The voltage is almost constant when the speed of the wheel is slowed down by hand. The current on the other hand increases dramatically. It is clearly shown that the controllable quantity is the voltage.
A linear function
v = kOu | (A.6)

A.6 Motor Driver A3952 Test 2 | 32
Input | PWM duty cycle | Running wheel | Stopped Wheel
-10 | 100% | 22 V | 21 V
-5 | 74% | 9 V, 65 mA | 8.4 V, 720 mA
-2.5 | 62% | 3.4 V, 58 mA | 2.8 V, 230 mA
| 54.7 Ω | 104.9 Ω
Command | Current [mA] | Voltage [V] | Current [mA] | Voltage [V]
10 | 400 | 21.64 | 211 | 21.81
5 | 202 | 11.05 | 107 | 11.19
2 | 81 | 4.36 | 45 | 4.46

Table A.1: Motor Driver Test 2

from output u to voltage v is to be derived. A mean value of all the points vill be used. We vill find that

kO = −2.0V | (A.7)

A more accurate nonlinear function is derived in A.8.

## A.6 Motor Driver A3952 Test 2

A variable resistor is coupled to the driver circuit instead of the motor. To find out if the motor driver controls the voltage or the current, the voltage and current are measured for different resistances, and different control signals.
Two different resistances and three different PWM output signals is used. Results are presented in Table A.6.
The voltage is almost constant when the resistance is changed. The current is almost halved. The controllable quantity is apparently the voltage.

## A.7 Wheel Friction Test

The steady state angular velocity of the wheel is notated for different constant outputs from the DSP. The result is shown in Figure A.1.
According to Equation 1.8, the dynamics of the wheel is described by

ω˙ = −

f
Jw

+

kEkT
JwRT
ω +
f
Jw

+

kEkT
JwRT
˙θ +

kT
JwRT
v | (A.8)

In steady-state, ˙ω and ˙θ will be zero and we will have
f
Jw

+

kEkT
JwRT
ω =

kT
JwRT
v | (A.9)

A.7 Wheel Friction Test | 33

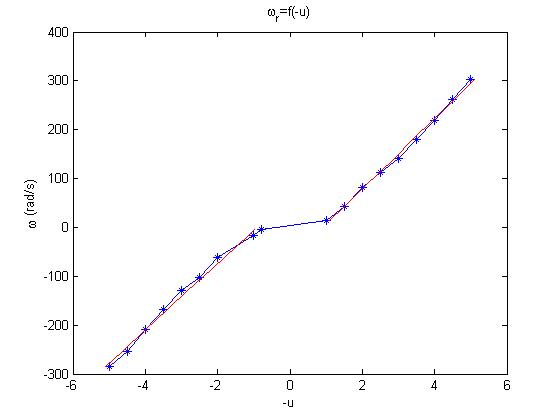
[picture p49: figure]

Figure A.1: The resulting angular velocity of the wheel for different outputs from the DSP (not voltages)

which, with equation (A.6), can be rewritten as

f =

kT
RT
kOu
ω

− kE

(A.10)

First of all we notice that there is a dead zone between -1 and 1, probably because of dry friction. The derivative du
dω for the line in the upper right corner will be used as the u/ω factor. The value is −0.0139, and we get that

f = 9.06 · 10⁻⁷ Nm.s.rad⁻¹ (A.11)

The friction f is always compared to the parameters

kEkT
RT

= 6.2 · 10⁻⁵ Nm.s.rad⁻¹
(A.12)

which is almost hundred times higher. The conclusion is that f is negligible.

A.8 Relation Between Output ”u” and Voltage to the Motor | 34
A.8 | Relation Between Output ”u” and Voltage

## to the Motor

In A.5, a linear relation between the PWM output signal and the voltage to the motor was derived. It has been shown though, that this relation is highly nonlinear. To get rid of this nonlinearity a function u = f(v) needs to be derived. The points in Figure A.2 shows results from measurements of the voltage for different PWM outputs.

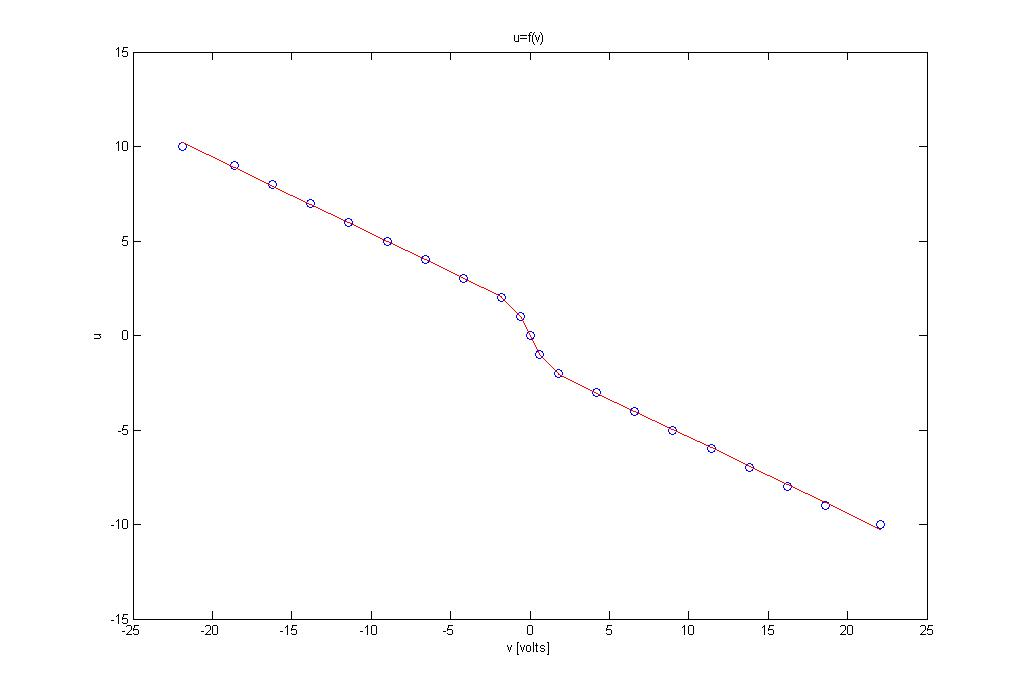
[picture p50: figure]

Figure A.2: The non linear function from voltage to the motor to the PWM output signal u.

A function is derived to fit to these measured points. It is divided into three different domains. The middle domain (around zero) is a third order polynomial fitted with the least square method. The two other parts are linear regressions. The function is defined as

u =

1.3317 − 0.4059v
−1.7361v + 0.1929v

3
−1.3510 − 0.4035v

v ≤ −1.8
−1.8 < v < 1.8
1.8 ≤ v

(A.13)

Figure A.2 shows that this function fits the points well.

# Appendix B

# Filtering of Data

First order low-pass filters will be used to filter the angular velocities. Such a filter can be described in continous time by

Yf (s) = 1
T s + 1
Y (s) | (B.1)

where T is the time constant for the filter.
Using Euler backward estimation for the derivative according to

s =

z − 1
zh | (B.2)

where h is the sampling time. After some simple derivation it will be shown that

zYf (z) = T
h

Yf (z)
1 + T
h

+

zY (z)
1 + T
h

(B.3)

Transformed back to time domain and shifted one step back we get

yf (k) = T
h

yf (k − 1)
1 + T
h

+

y(k)
1 + T
h

(B.4)

The time constants for the filters need to be chosen. Setting them too low will not suppress noise enough, too high will distort and flatten the signal. Experiments show that Tω = 0.020 and T˙θ = 0.004 suppress noise in a good manner. The time constants of the corresponding systems are about 20 times larger, so the ”real signals” should not be affected.

36

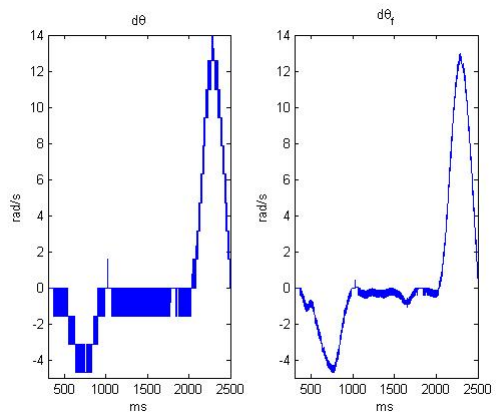
[picture p51: figure]

Figure B.1: The angular velocity of the pendulum before (left) and after (right) filtering.
