Axram/CubeProject/Thesis/pwmpic.pdf

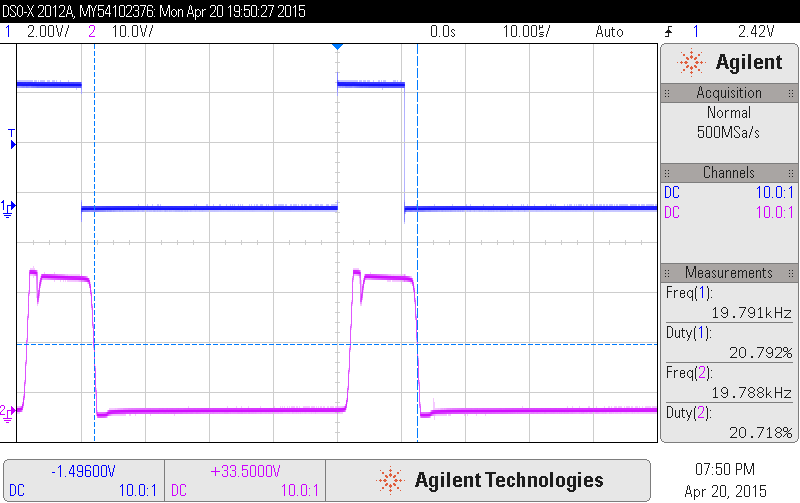
[picture p52: figure]
