Axram/CubeProject/Thesis/RootLocus-eps-converted-to.pdf

-10 | -8 | -6 | -4 | -2 | 0 | 2 | 4 | 6 | 8

-1

-0.8

-0.6

-0.4

-0.2

0

0.2

0.4

0.6

0.8

Root Locus

Real Axis (seconds⁻¹)

## Imaginary Axis (seconds-1

)
