Axram/CubeProject/Thesis/Finaldesign.pdf

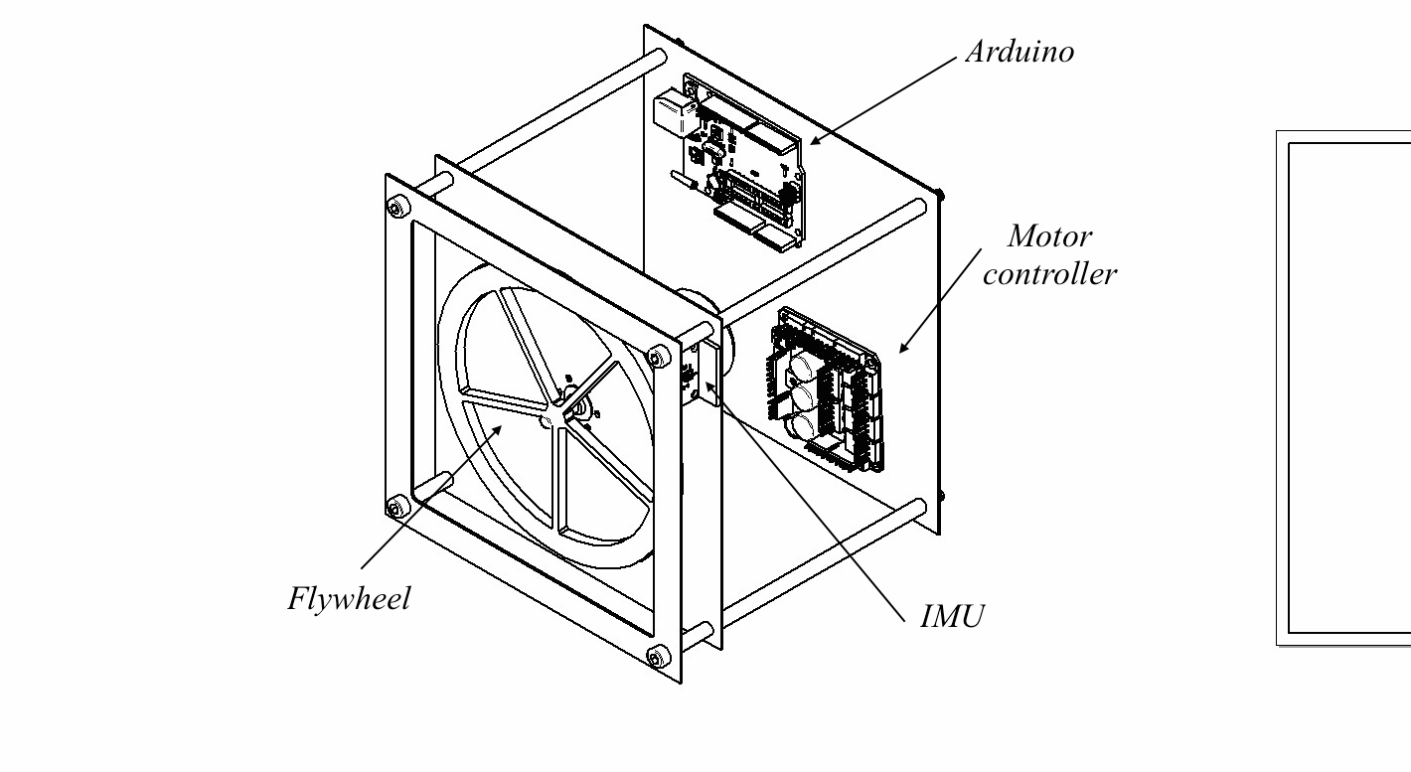
[picture p53: figure]
