Axram/CubeProject/Thesis/PzMap-eps-converted-to.pdf

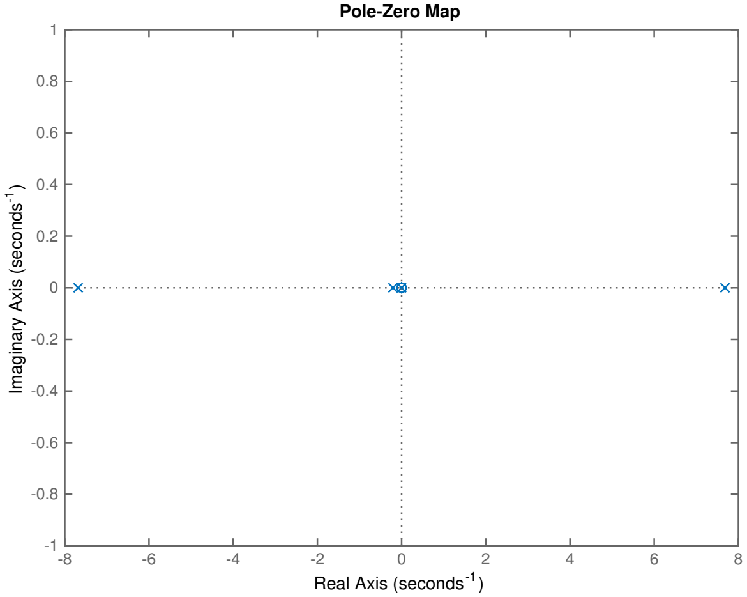
[picture p54: figure]
Pole-Zero Map; Real Axis (seconds⁻¹); Imaginary Axis (seconds-1
