Axram/CubeProject/CAD/concept.bmp

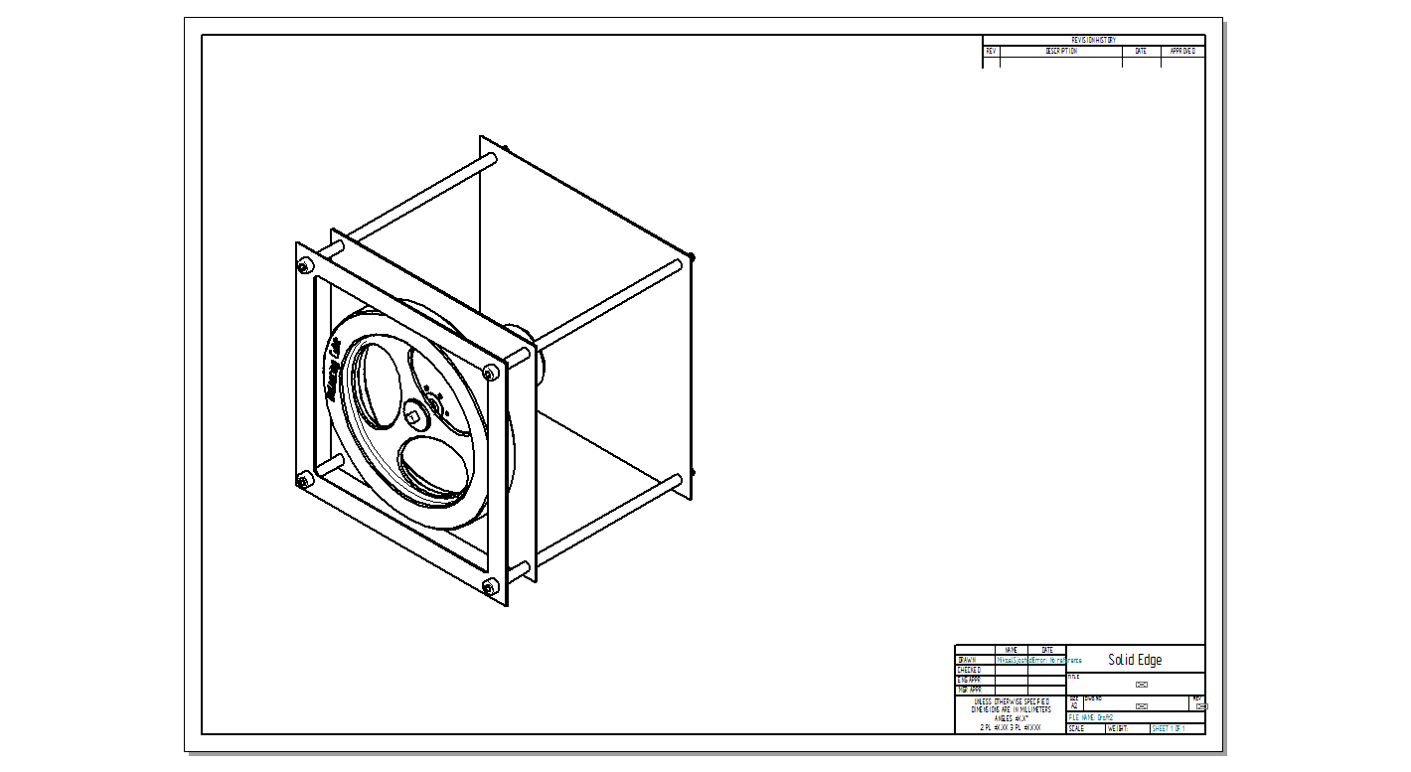
CAD/concept.bmp
