Axram/CubeProject/CAD/Draft1.bmp

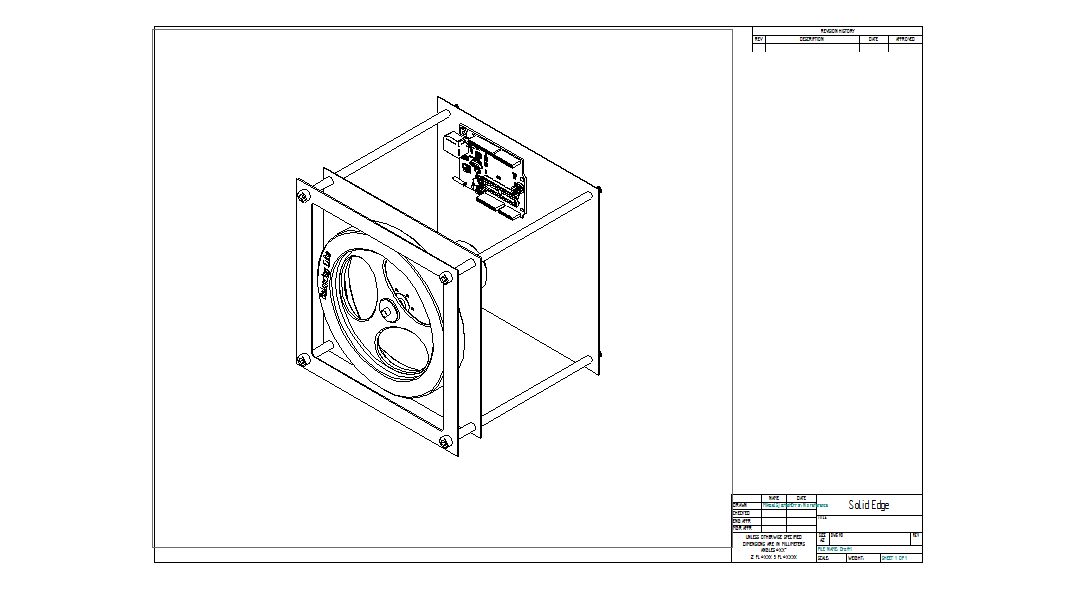
CAD/Draft1.bmp
