Axram/CubeProject/CAD/Draft1.tif

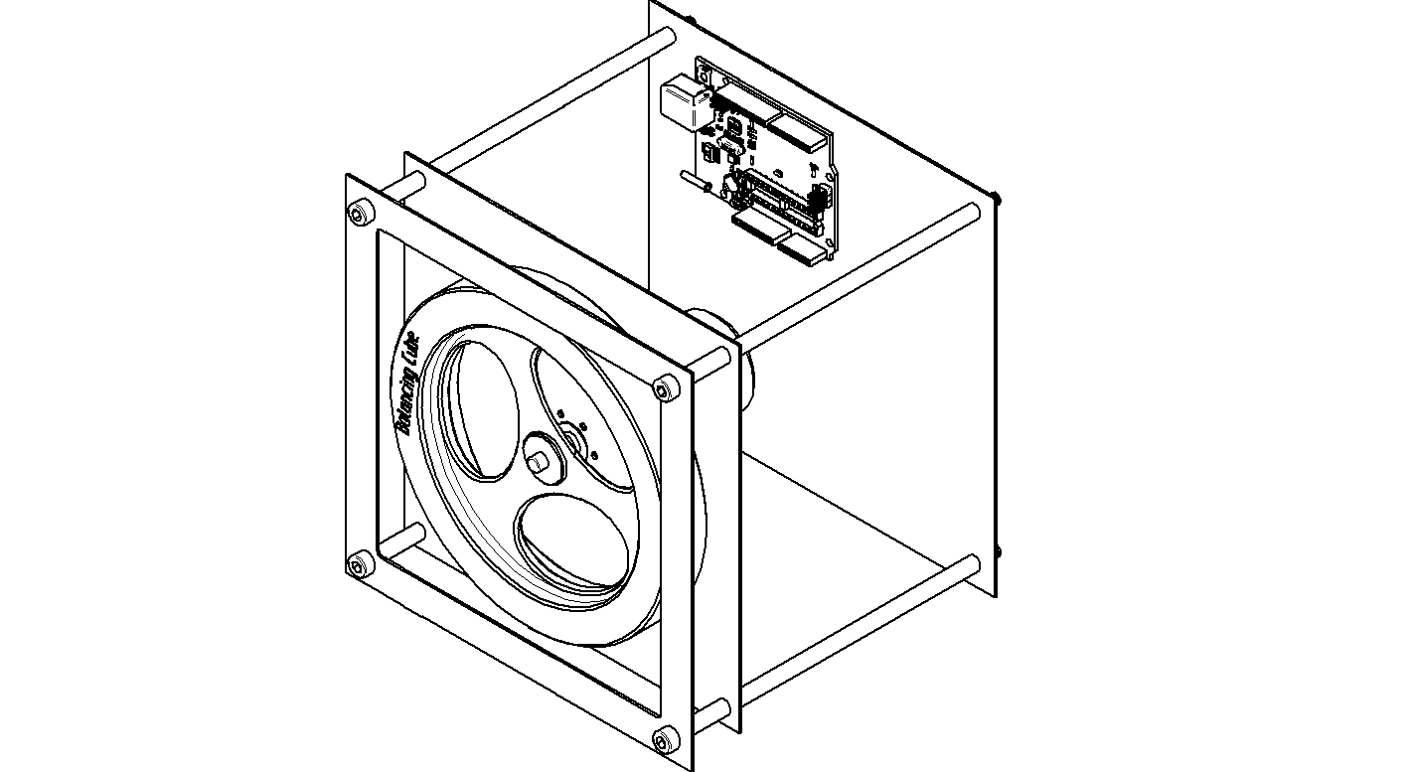
CAD/Draft1.tif
