Axram/CubeProject/CAD/Flywheel/flywheel12.jpg

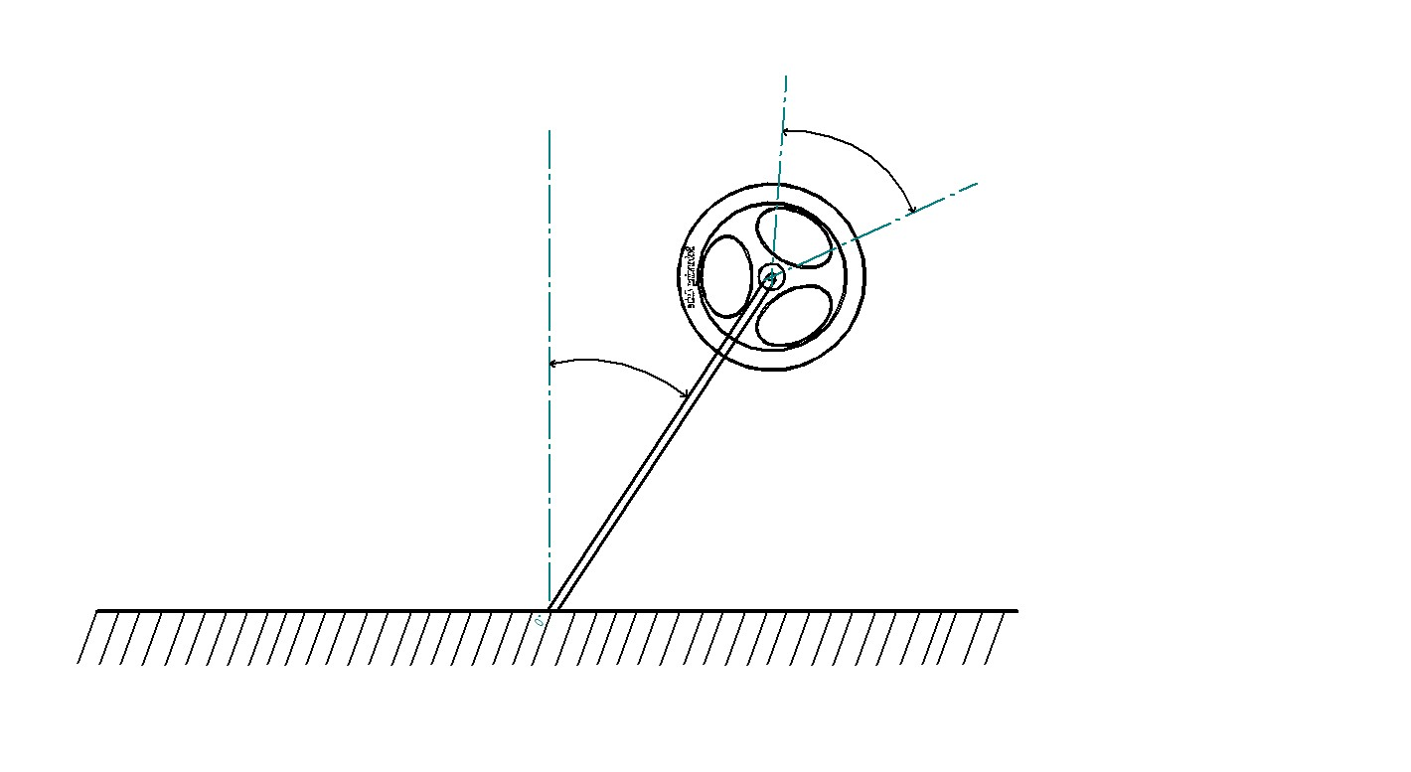
CAD/Flywheel/flywheel12.jpg
