Axram/CubeProject/CAD/Flywheel/motorf1.bmp

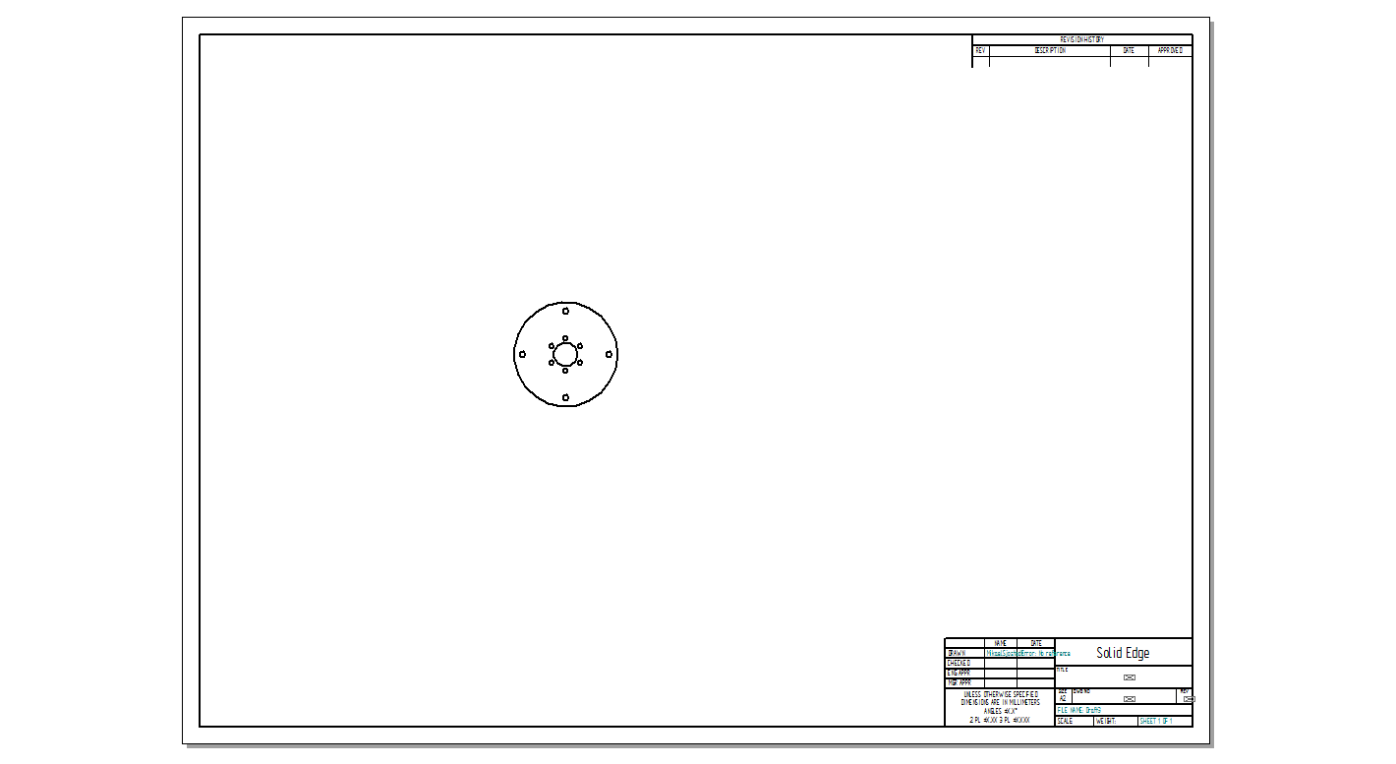
CAD/Flywheel/motorf1.bmp
