Axram/CubeProject/CAD/IMUcad/ci_back.jpg

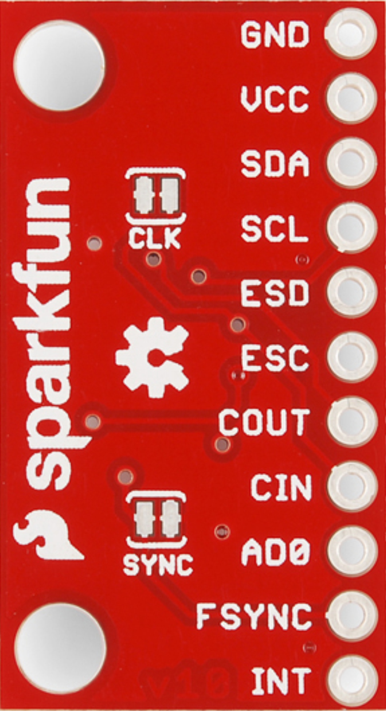
CAD/IMUcad/ci_back.jpg
