Axram/CubeProject/CAD/IMUcad/ci_front.jpg

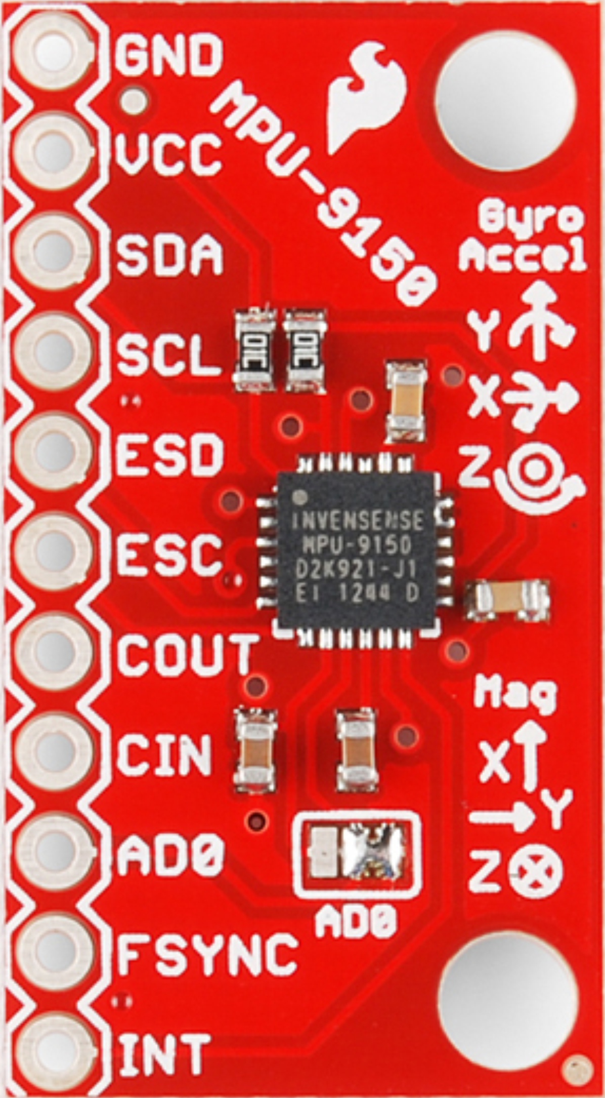
CAD/IMUcad/ci_front.jpg
