Axram/CubeProject/CAD/IMUcad/MPU-9150_(RENDER1).JPG

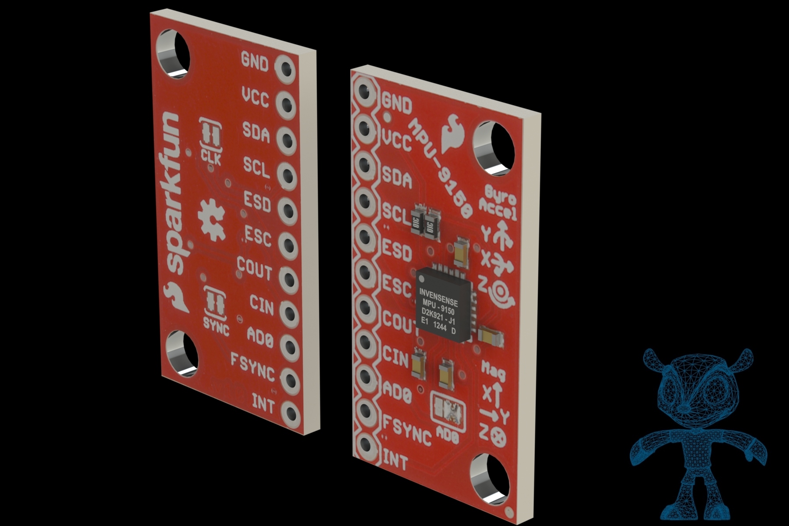
CAD/IMUcad/MPU-9150_(RENDER1).JPG
