Axram/CubeProject/CAD/IMUcad/MPU-9150_(RENDER2).jpg

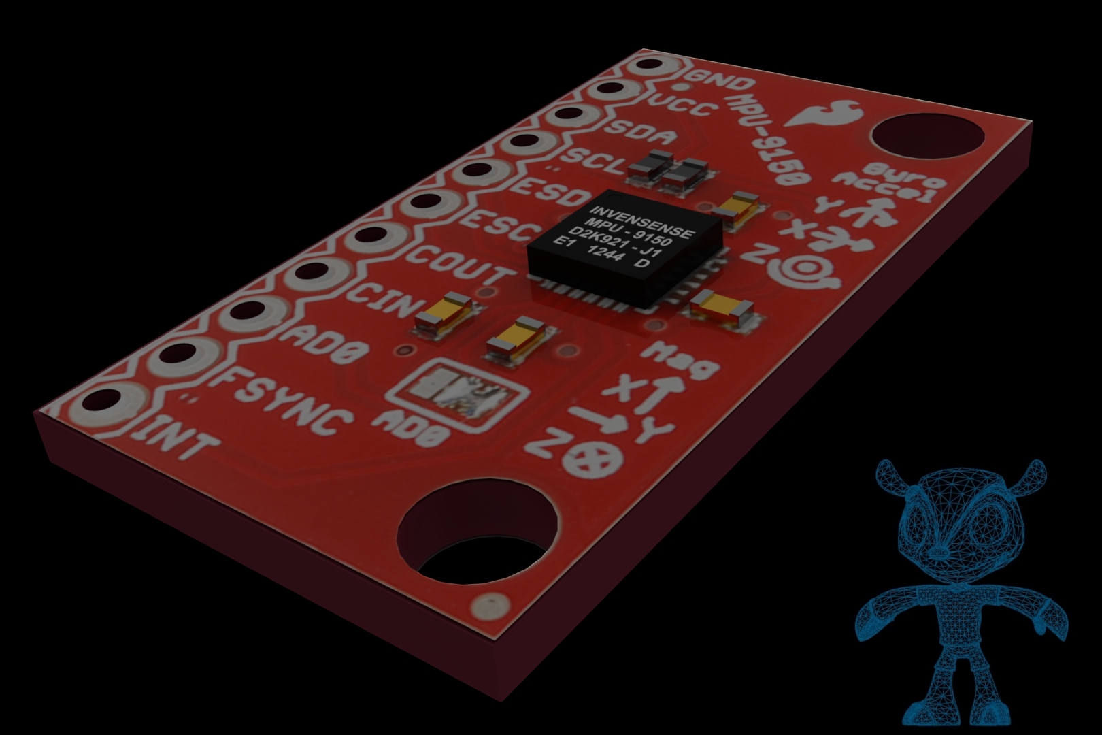
CAD/IMUcad/MPU-9150_(RENDER2).jpg
