Axram/CubeProject/CAD/Motor Controller/Renderings/EZ4AXIS20111230-27896-1cnkgb.jpg

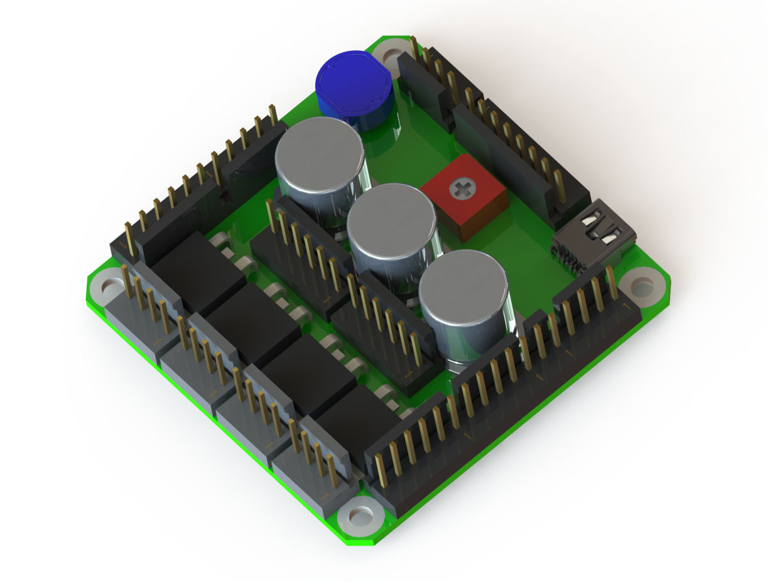
CAD/Motor Controller/Renderings/EZ4AXIS20111230-27896-1cnkgb.jpg
