Axram/CubeProject/Mixed/Presentation1/Bild1.jpg

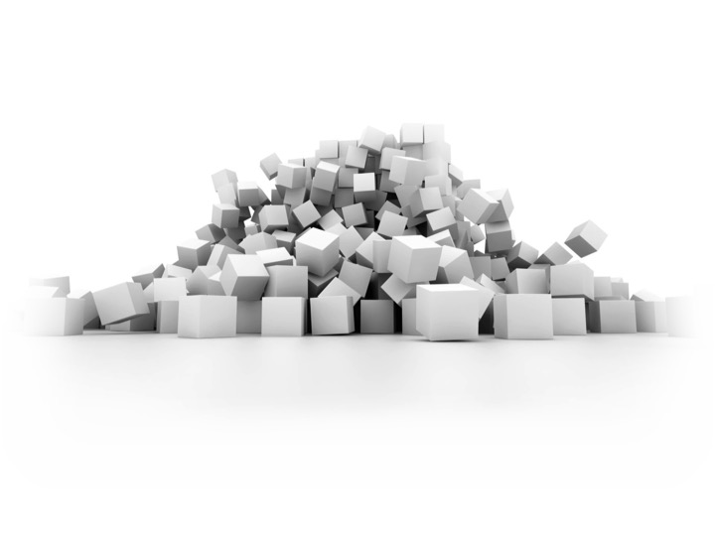
Mixed/Presentation1/Bild1.jpg
