Axram/CubeProject/Mixed/Skärmavbild 2015-04-07 kl. 23.43.22.png

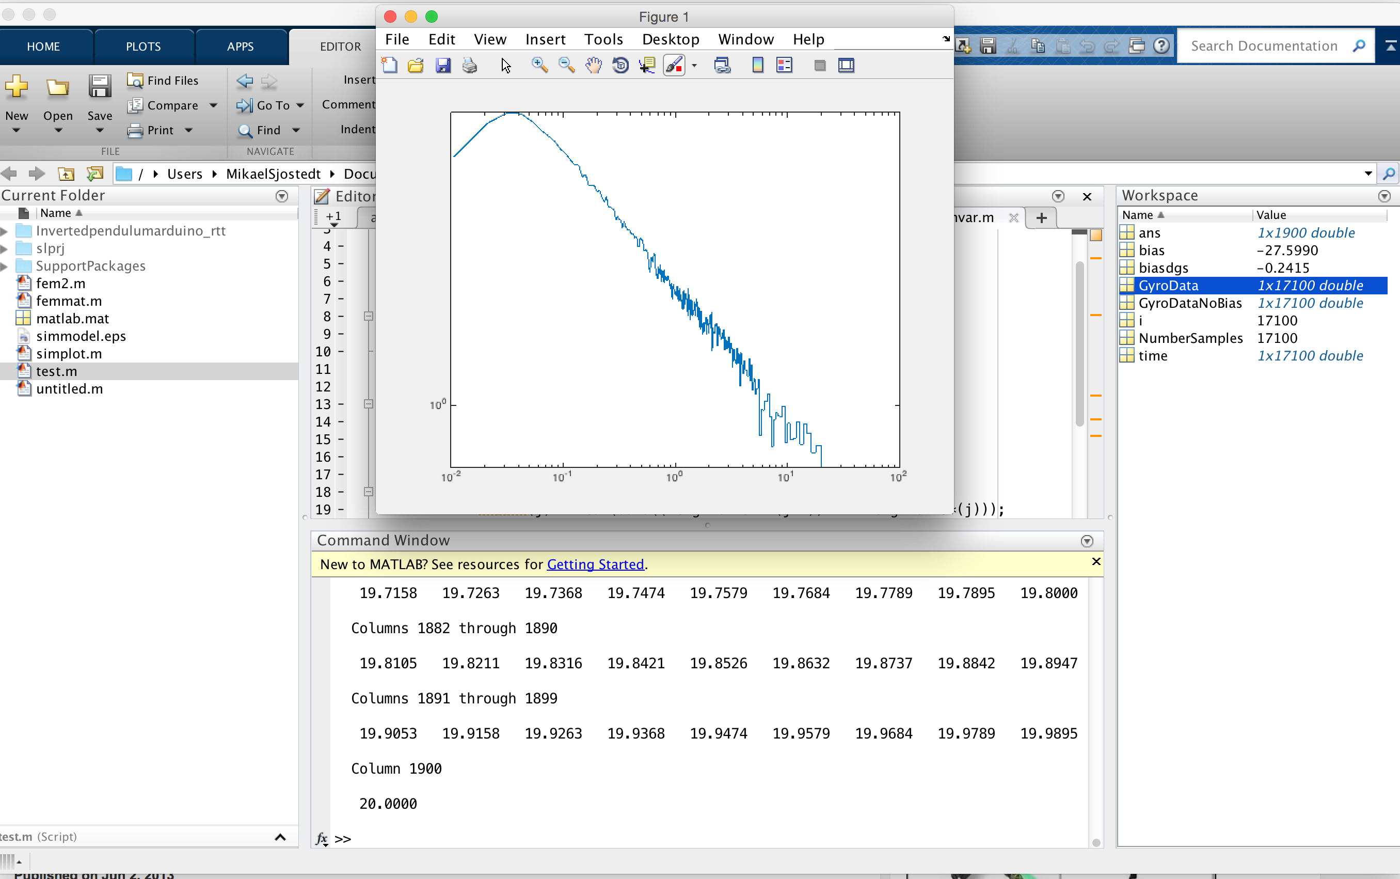
Mixed/Skärmavbild 2015-04-07 kl. 23.43.22.png
