Axram/CubeProject/Mixed/Skärmavbild 2015-04-19 kl. 13.04.17.png

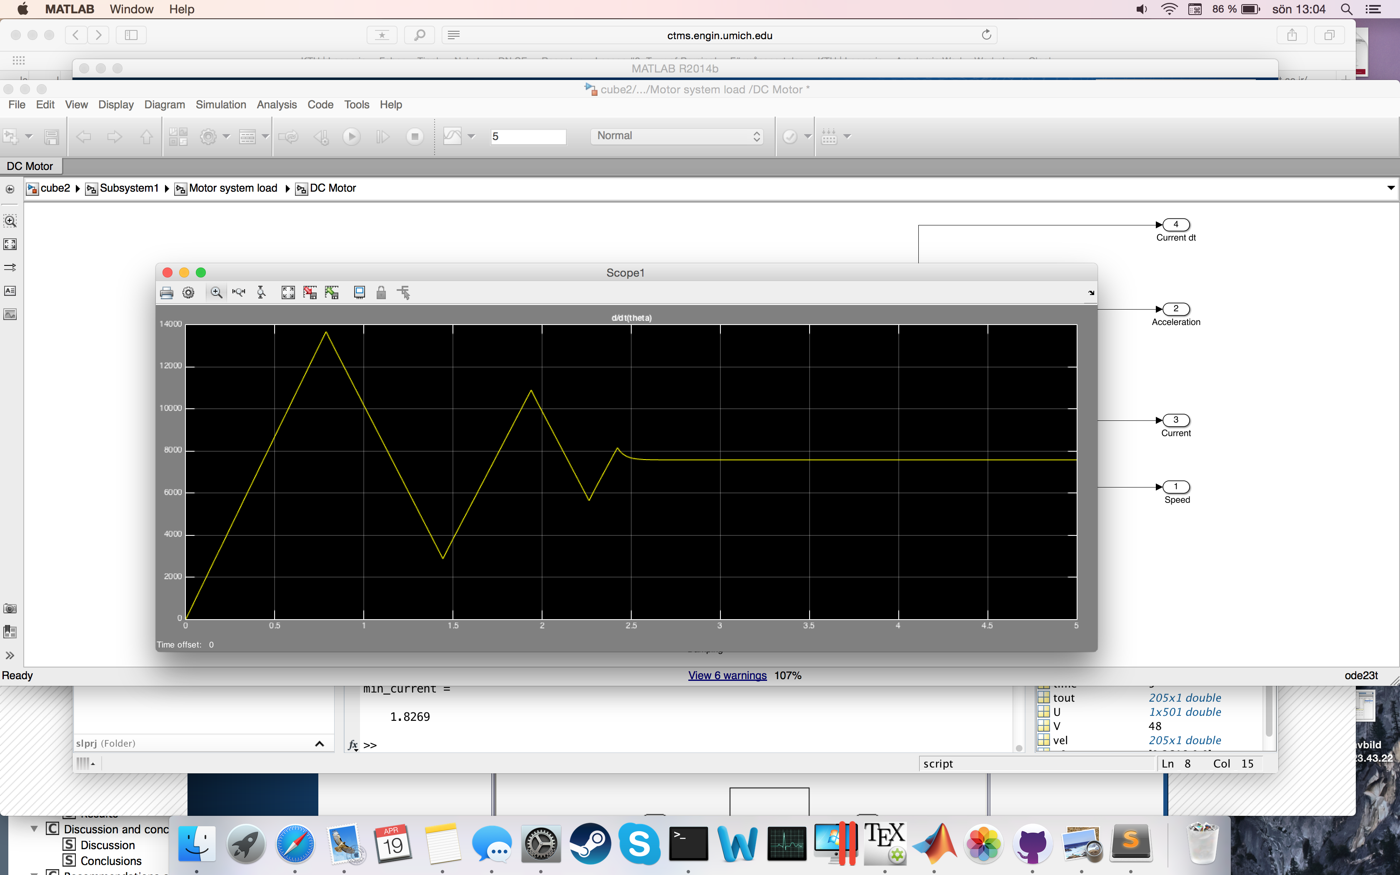
Mixed/Skärmavbild 2015-04-19 kl. 13.04.17.png
