Axram/CubeProject/Mixed/Skärmavbild 2015-04-19 kl. 14.39.36.png

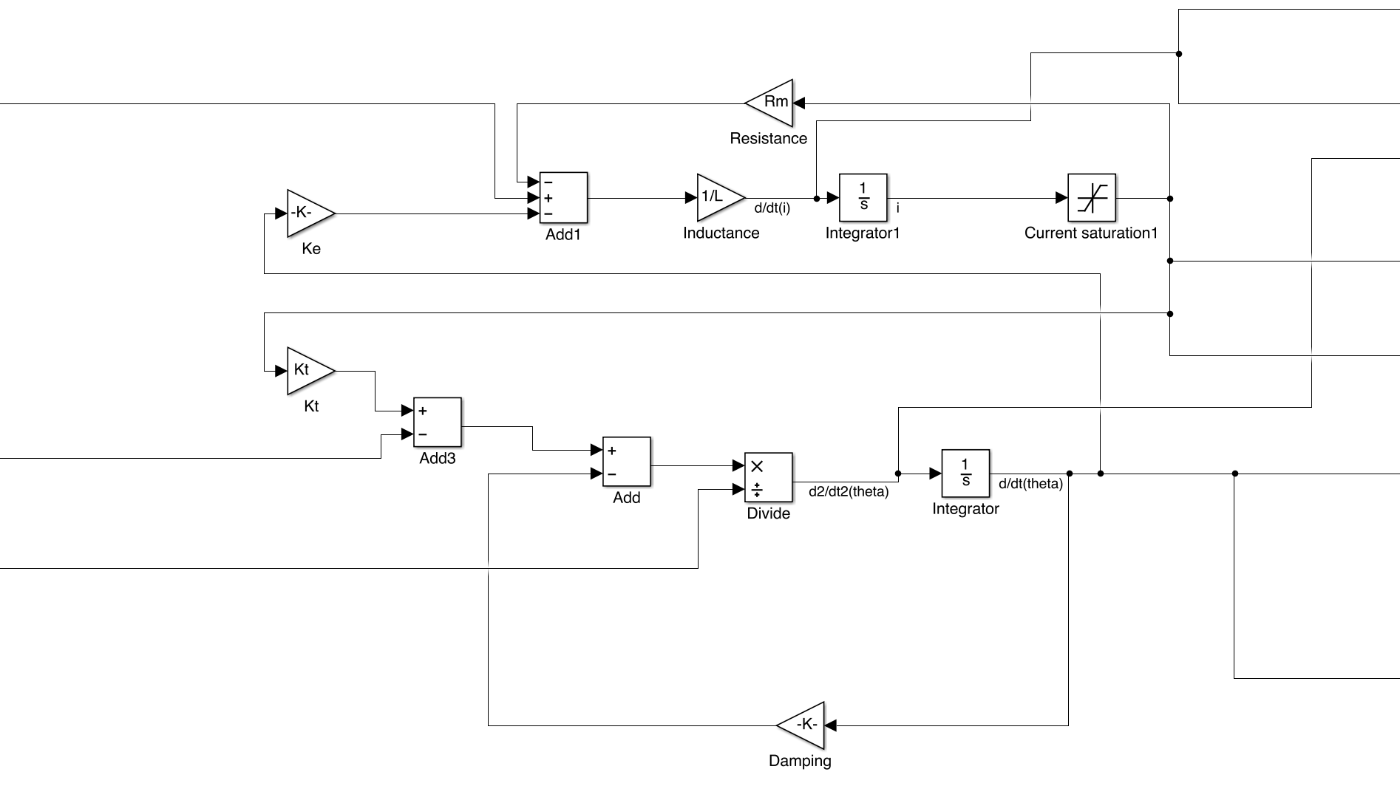
Mixed/Skärmavbild 2015-04-19 kl. 14.39.36.png
