Axram/CubeProject/Mixed/Skärmavbild 2015-04-20 kl. 14.15.09.png

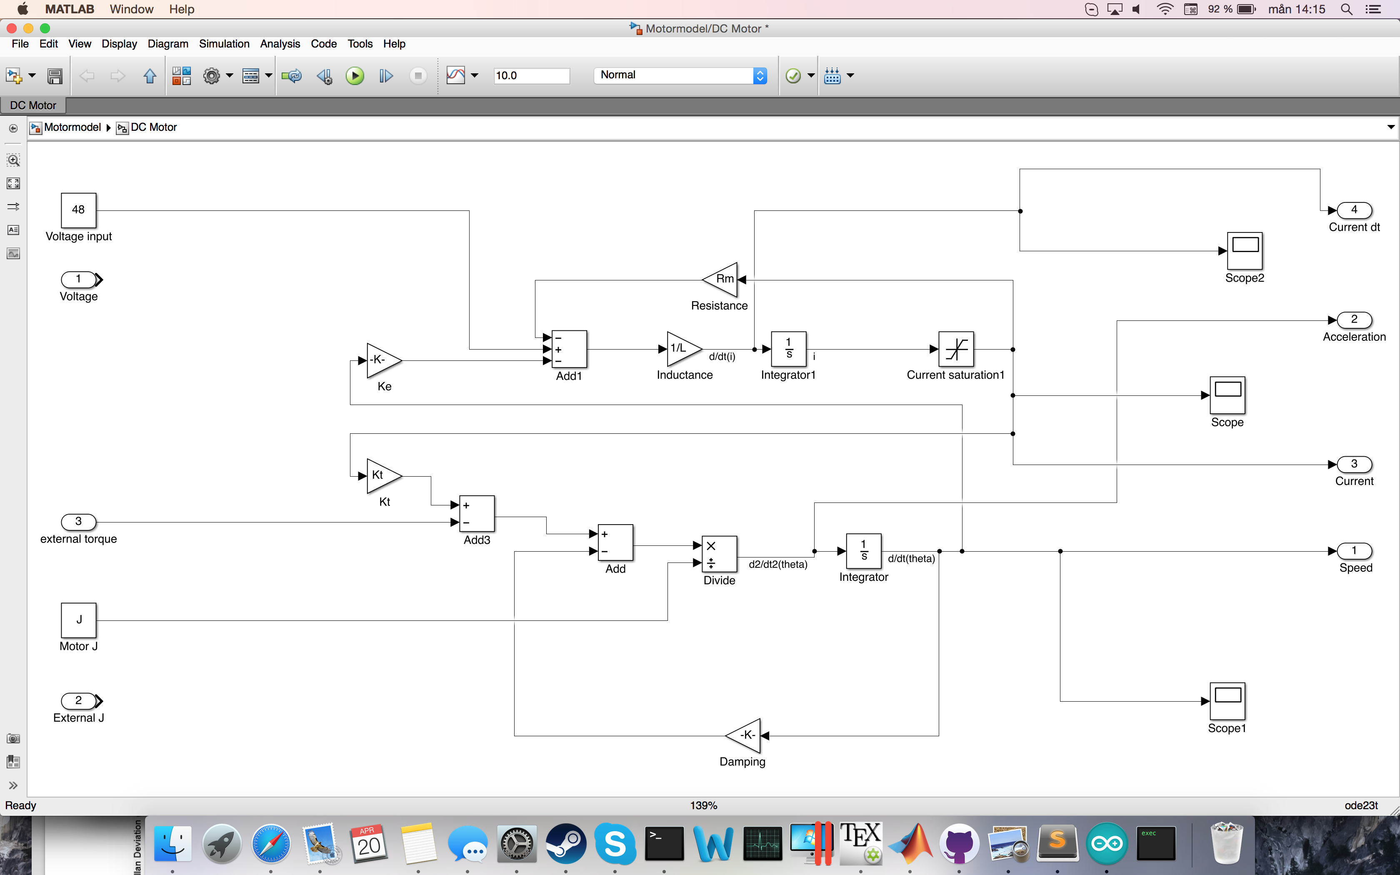
Mixed/Skärmavbild 2015-04-20 kl. 14.15.09.png
