Axram/CubeProject/Mixed/Skärmavbild 2015-04-20 kl. 14.17.16.png

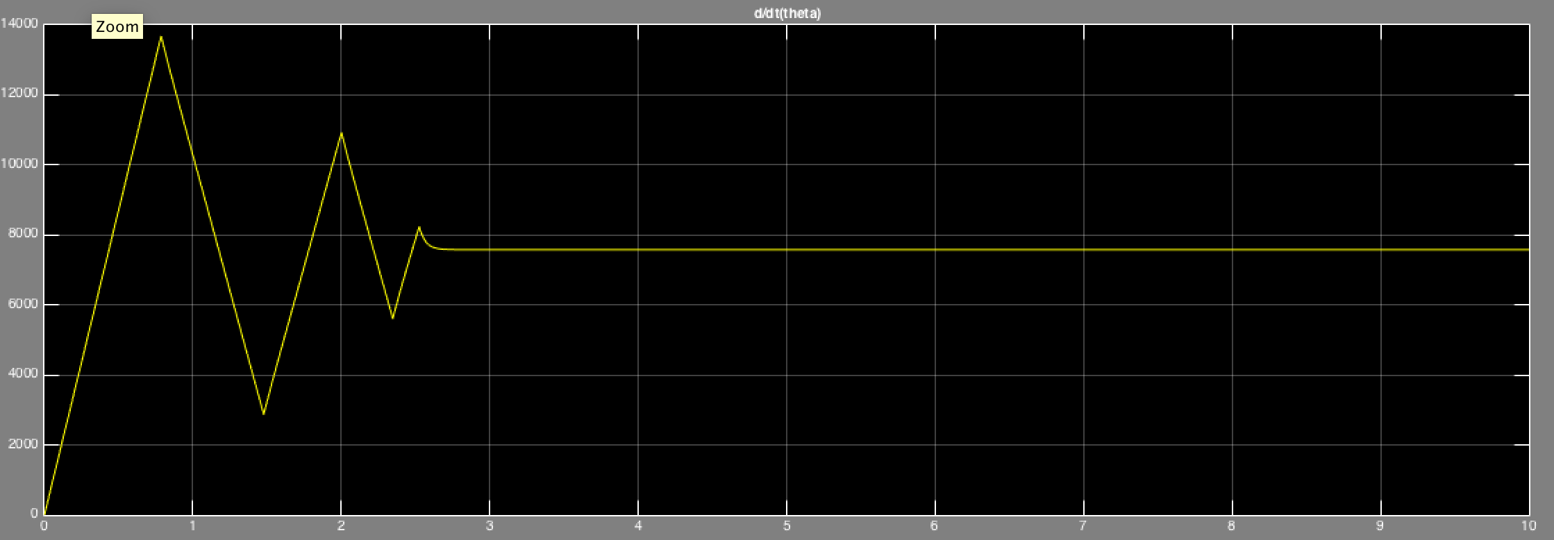
Mixed/Skärmavbild 2015-04-20 kl. 14.17.16.png
