Axram/CubeProject/Mixed/Skärmavbild 2015-04-21 kl. 21.10.58.png

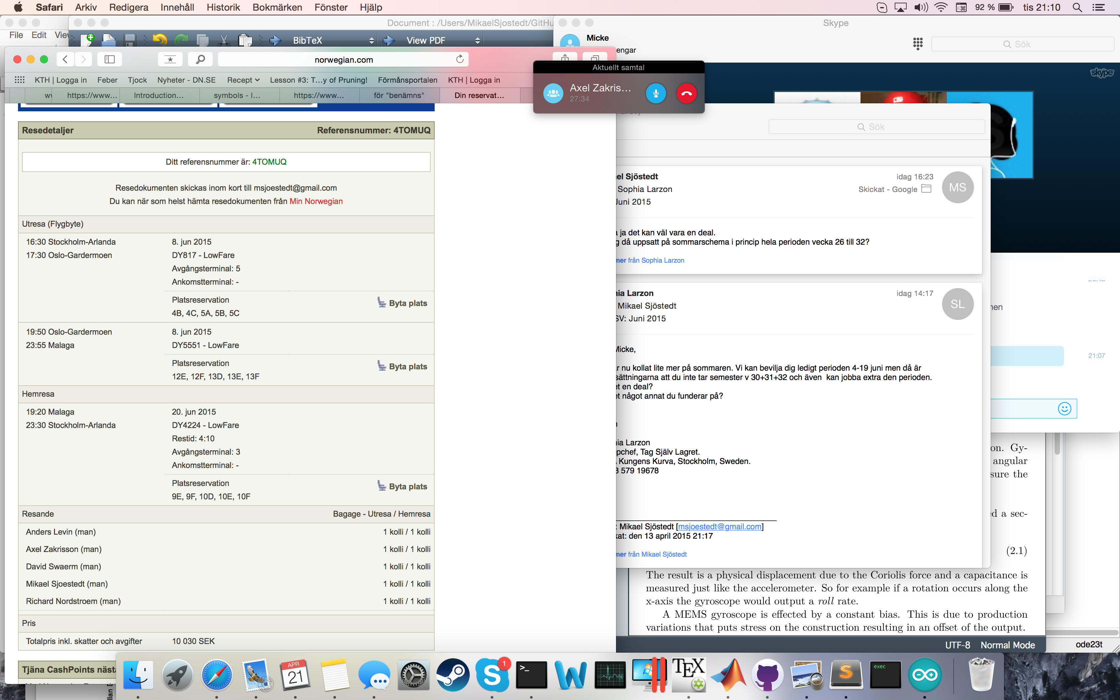
Mixed/Skärmavbild 2015-04-21 kl. 21.10.58.png
