Axram/CubeProject/Mixed/Skärmavbild 2015-04-21 kl. 21.54.47.png

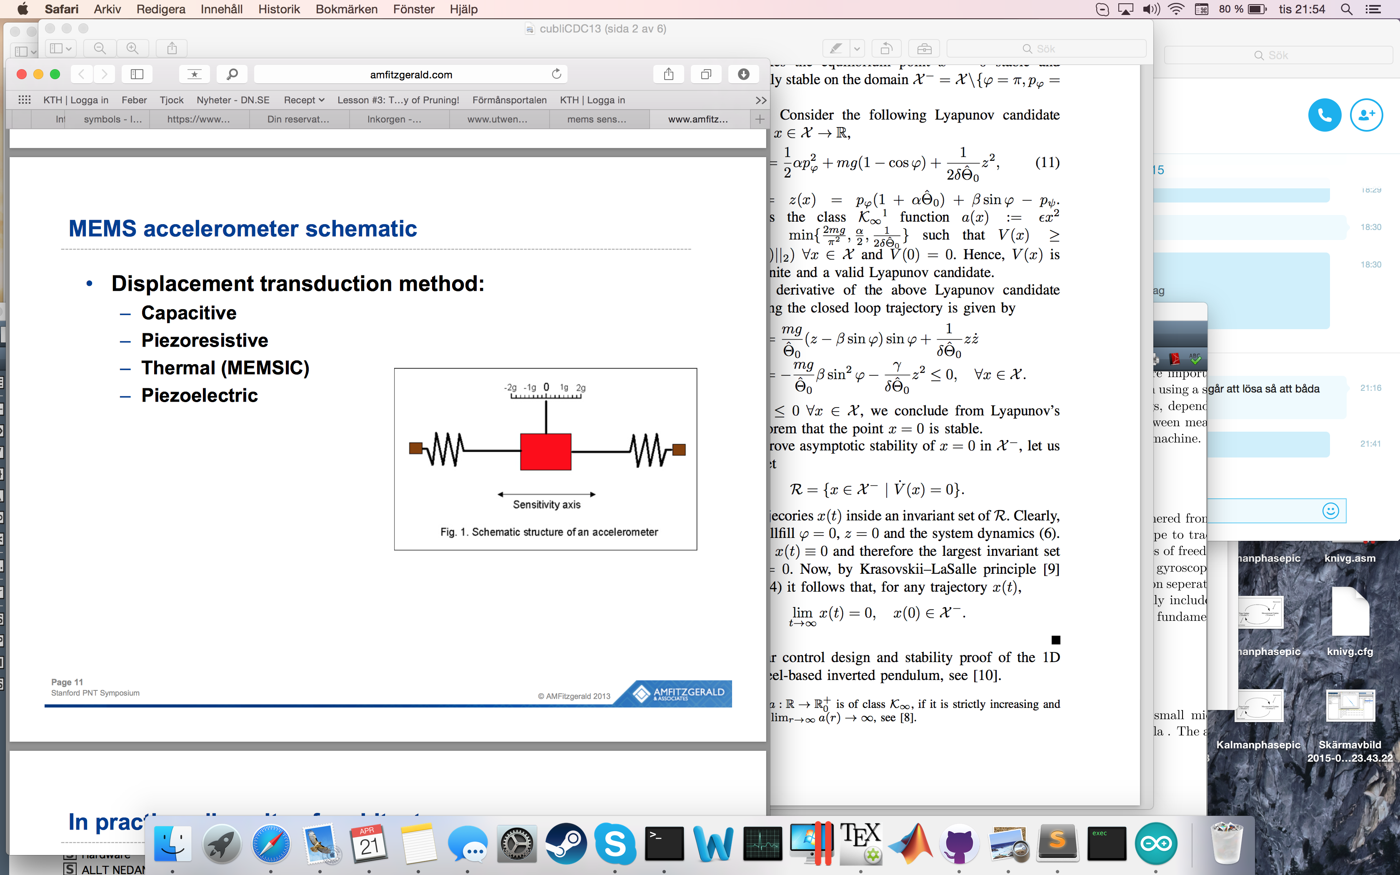
Mixed/Skärmavbild 2015-04-21 kl. 21.54.47.png
