Axram/CubeProject/Mixed/Skärmavbild 2015-05-04 kl. 22.14.59.png

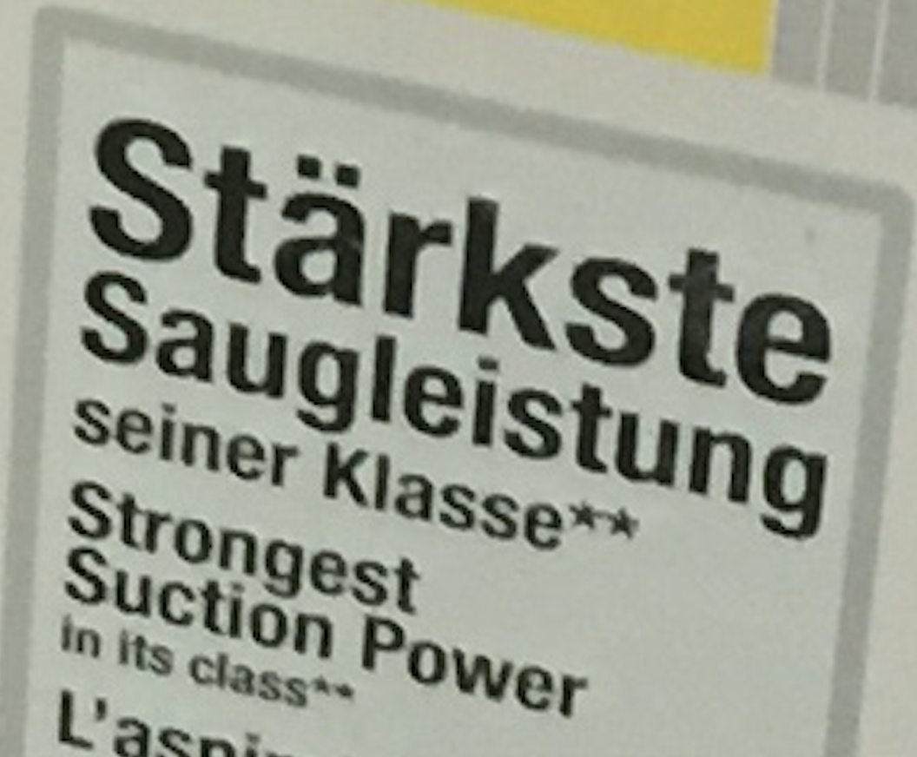
Mixed/Skärmavbild 2015-05-04 kl. 22.14.59.png
