Axram/CubeProject/Mixed/Skärmavbild 2015-05-07 kl. 23.36.47.png

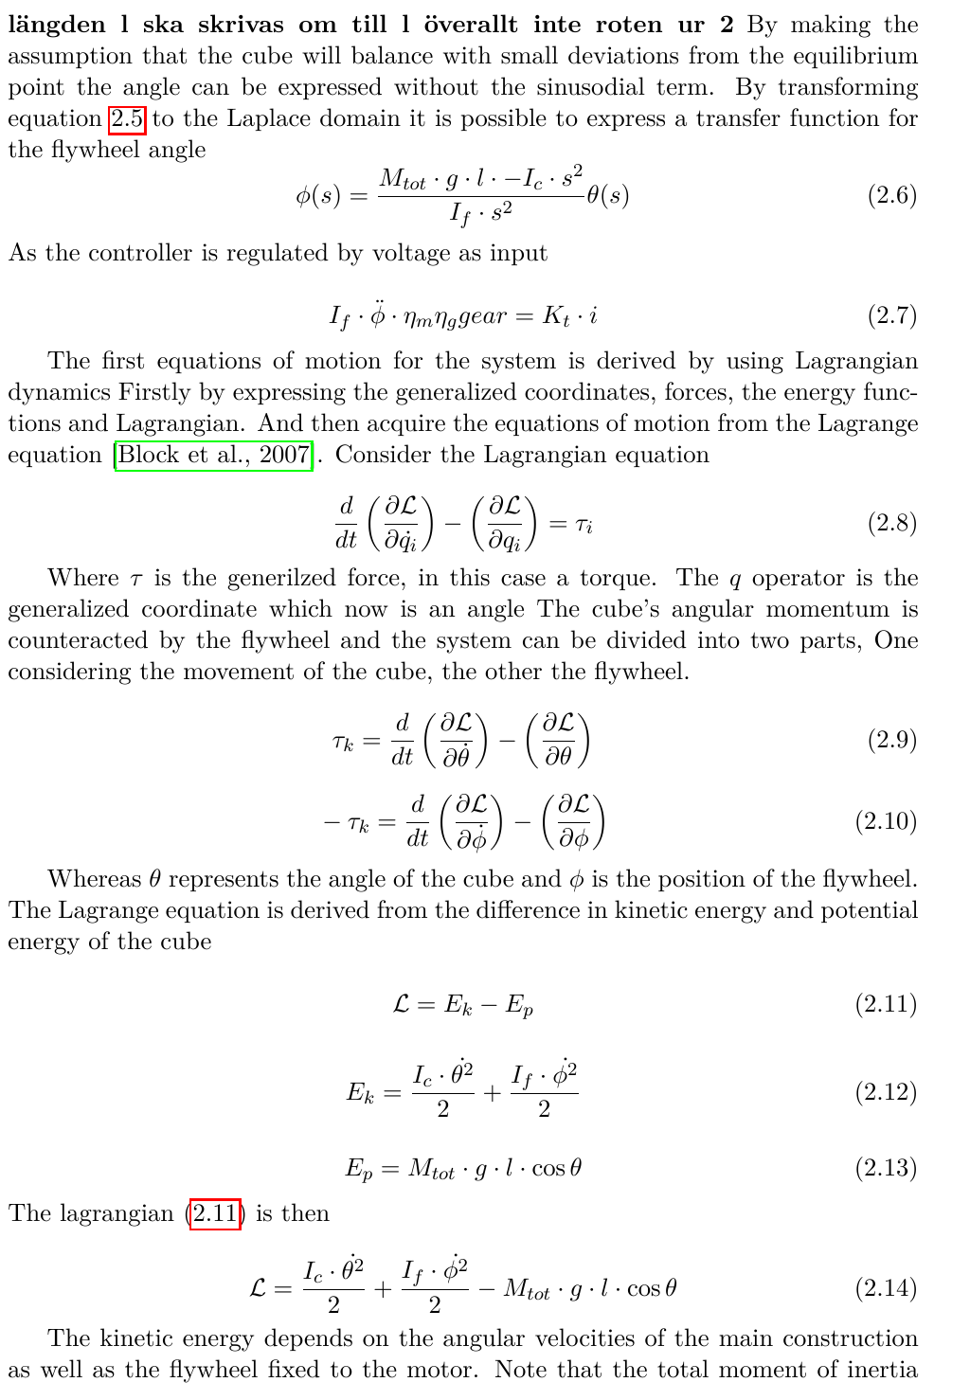
Mixed/Skärmavbild 2015-05-07 kl. 23.36.47.png
