Axram/CubeProject/Mixed/Skärmavbild 2015-05-07 kl. 23.40.01.png

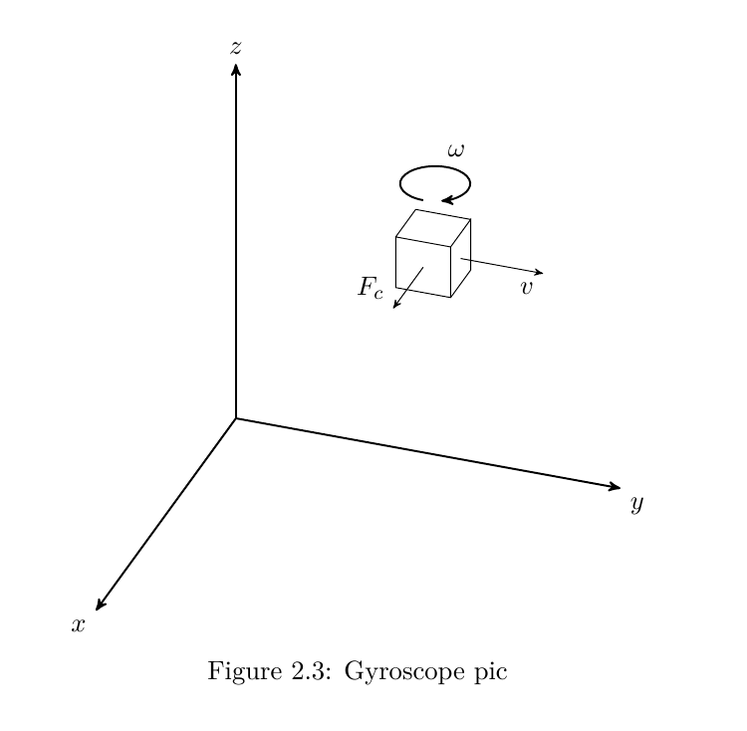
Mixed/Skärmavbild 2015-05-07 kl. 23.40.01.png
