Axram/CubeProject/Mixed/Skärmavbild 2015-05-10 kl. 22.22.25.png

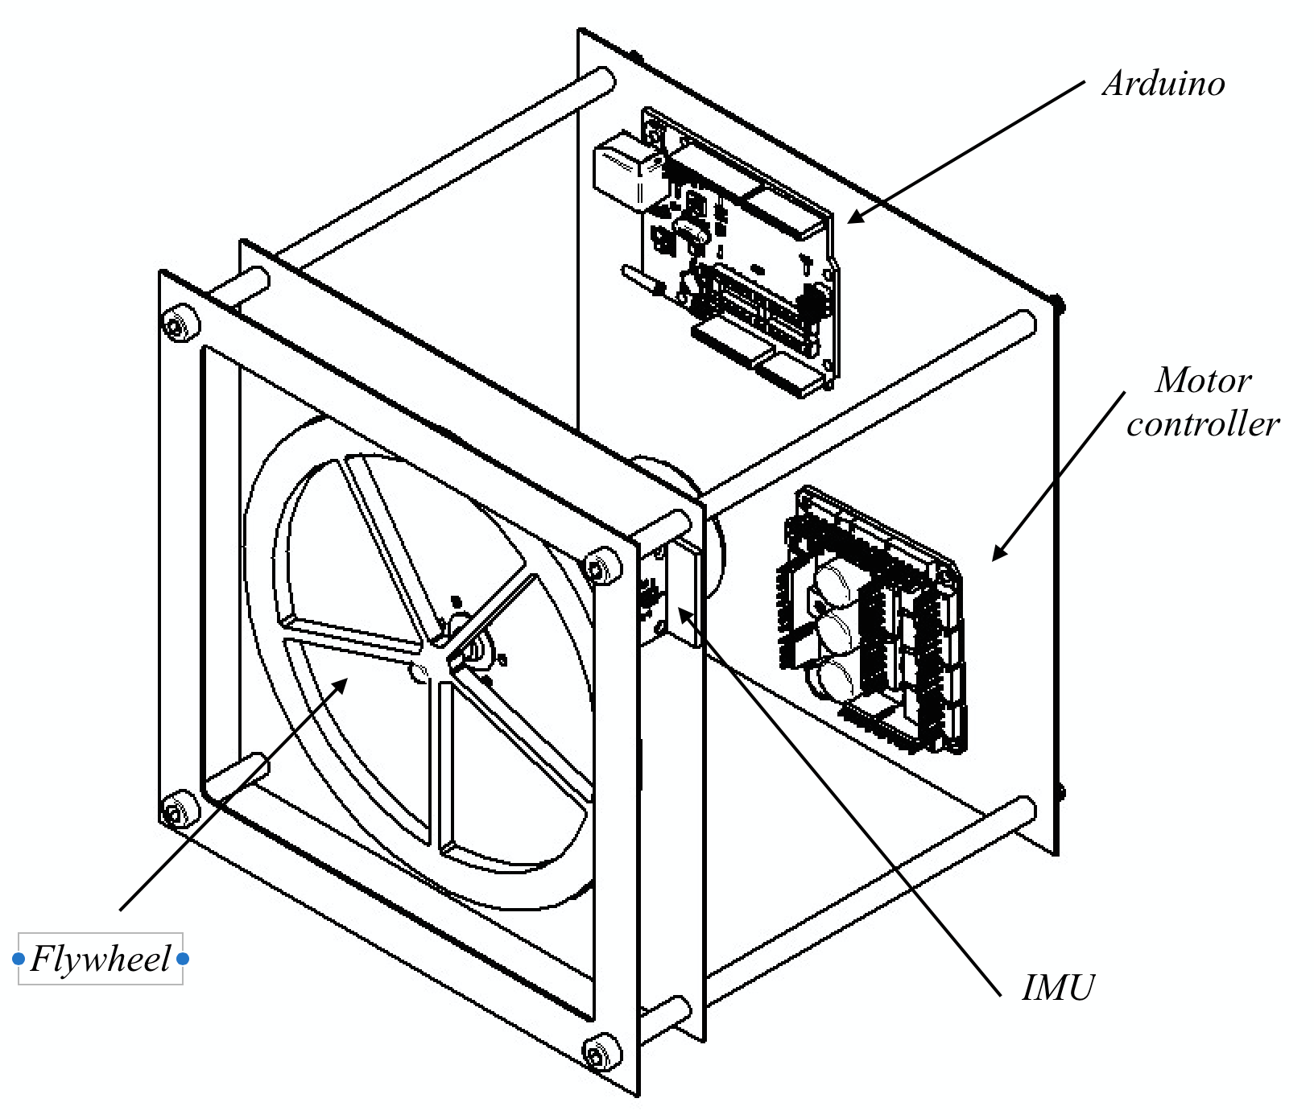
Mixed/Skärmavbild 2015-05-10 kl. 22.22.25.png
