Axram/CubeProject/Mixed/Skärmavbild 2015-05-11 kl. 12.27.55.png

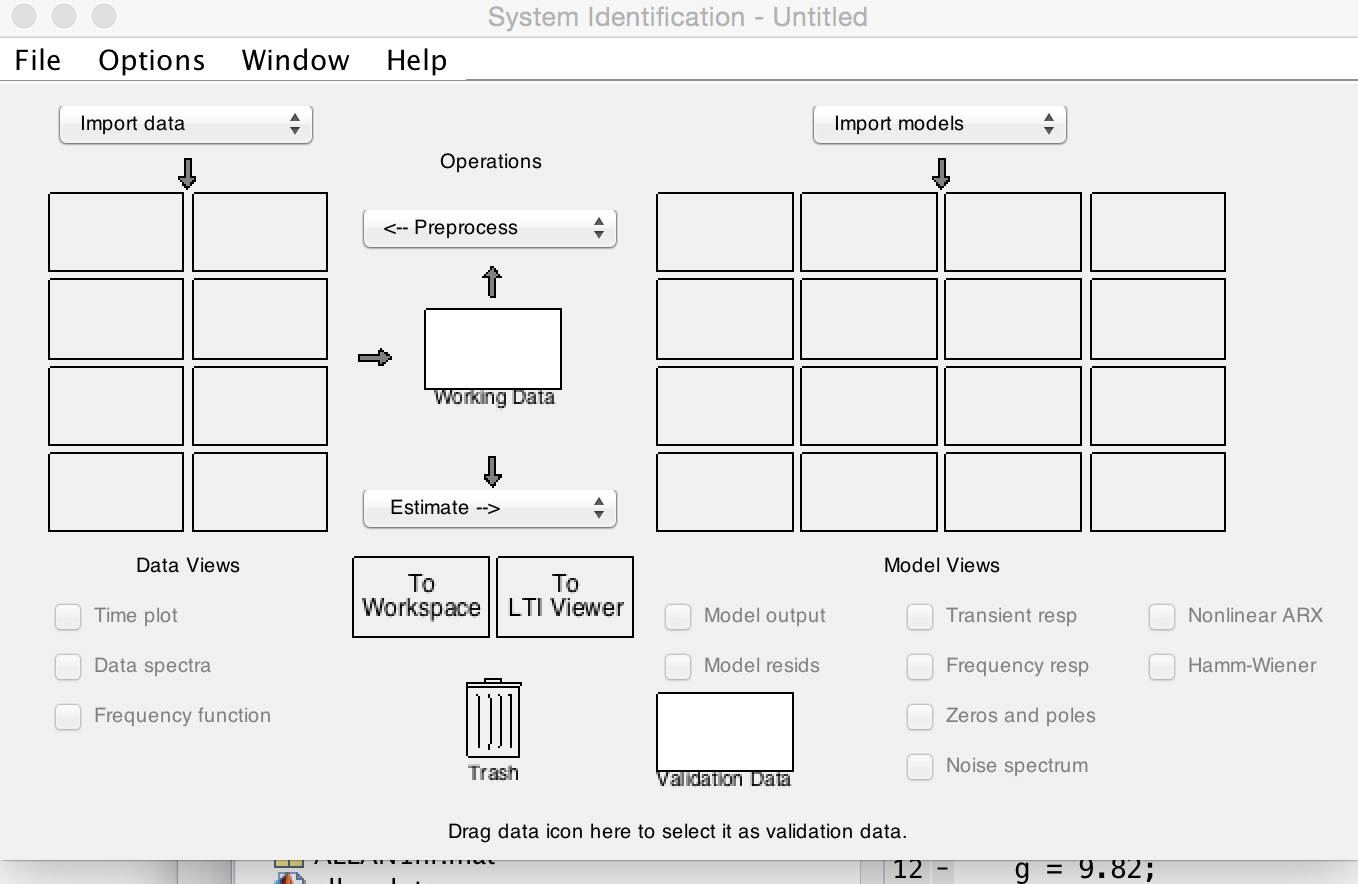
Mixed/Skärmavbild 2015-05-11 kl. 12.27.55.png
