Axram/CubeProject/Mixed/Skärmavbild 2015-05-16 kl. 13.31.41 1.png

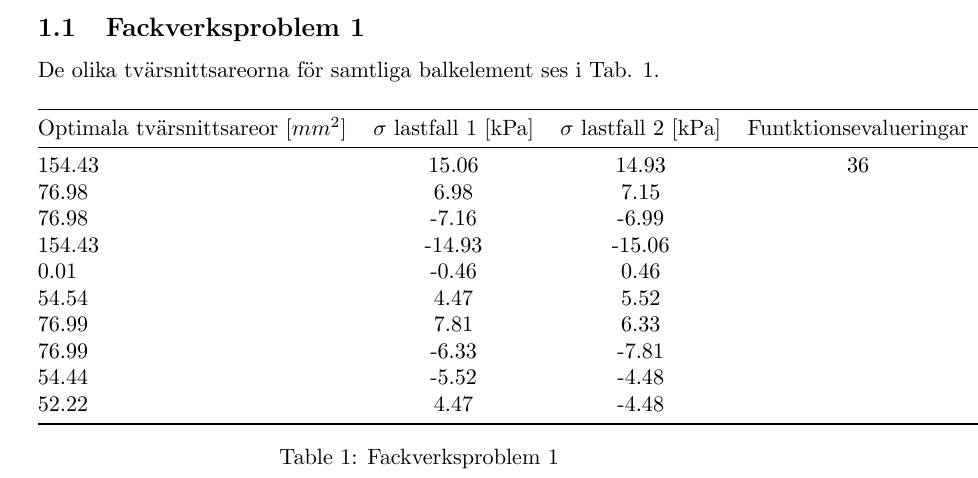
Mixed/Skärmavbild 2015-05-16 kl. 13.31.41 1.png
