Axram/CubeProject/Mixed/Skärmavbild 2015-05-17 kl. 12.27.29.png

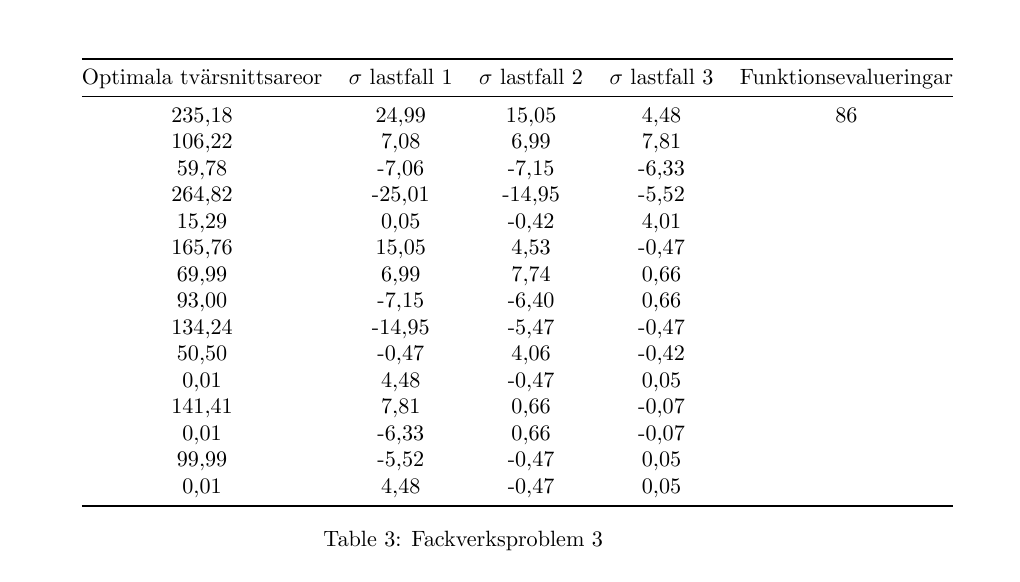
Mixed/Skärmavbild 2015-05-17 kl. 12.27.29.png
