Axram/CubeProject/Mixed/Skärmavbild 2015-05-17 kl. 12.33.55.png

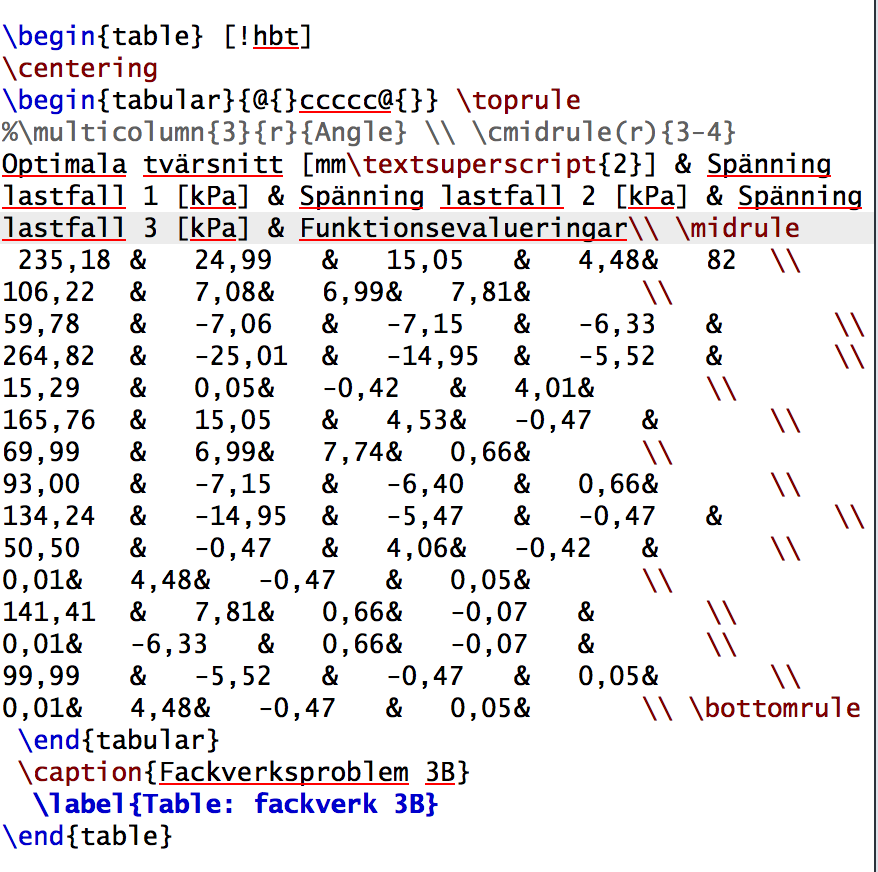
Mixed/Skärmavbild 2015-05-17 kl. 12.33.55.png
