Axram/CubeProject/CAD/IMUcad/STEP_MPU-9150_(Assembly).STEP

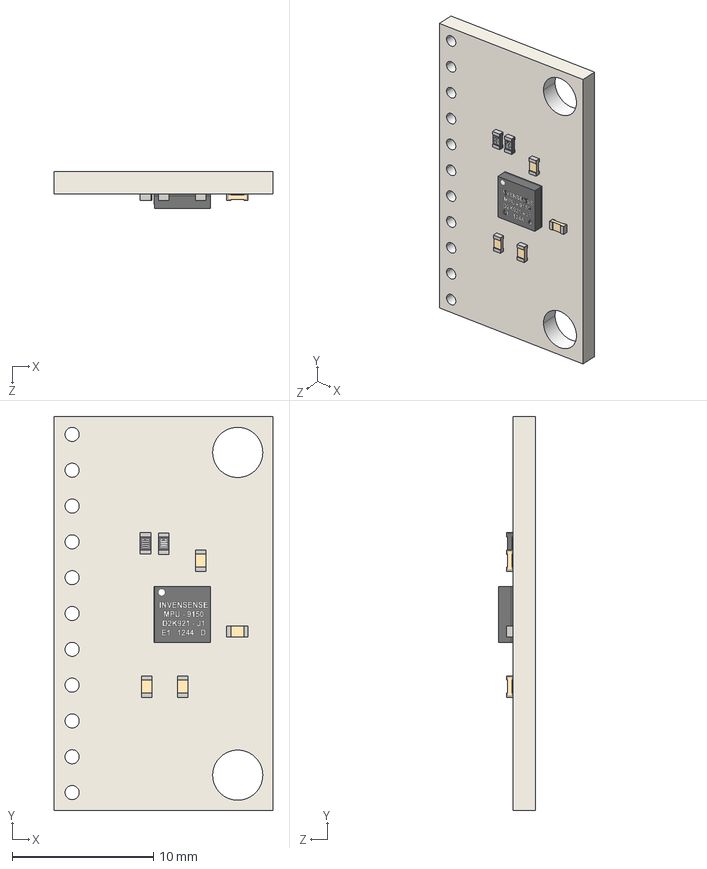
[picture p83: CAD file, 2015-05-10]
CAD/IMUcad/STEP_MPU-9150_(Assembly).STEP
15.5 x 27.9 x 2.61 mm
MPU-9150_(CI_Board)
MPU-9150_(Chip)
MPU-9150_(0603_SMD1)_Valor predeterminado x 2
MPU-9150_(0603_SMD2)_Valor predeterminado x 4
