Axram/CubeProject/CAD/Flywheel new/Flywheelcircle.dxf

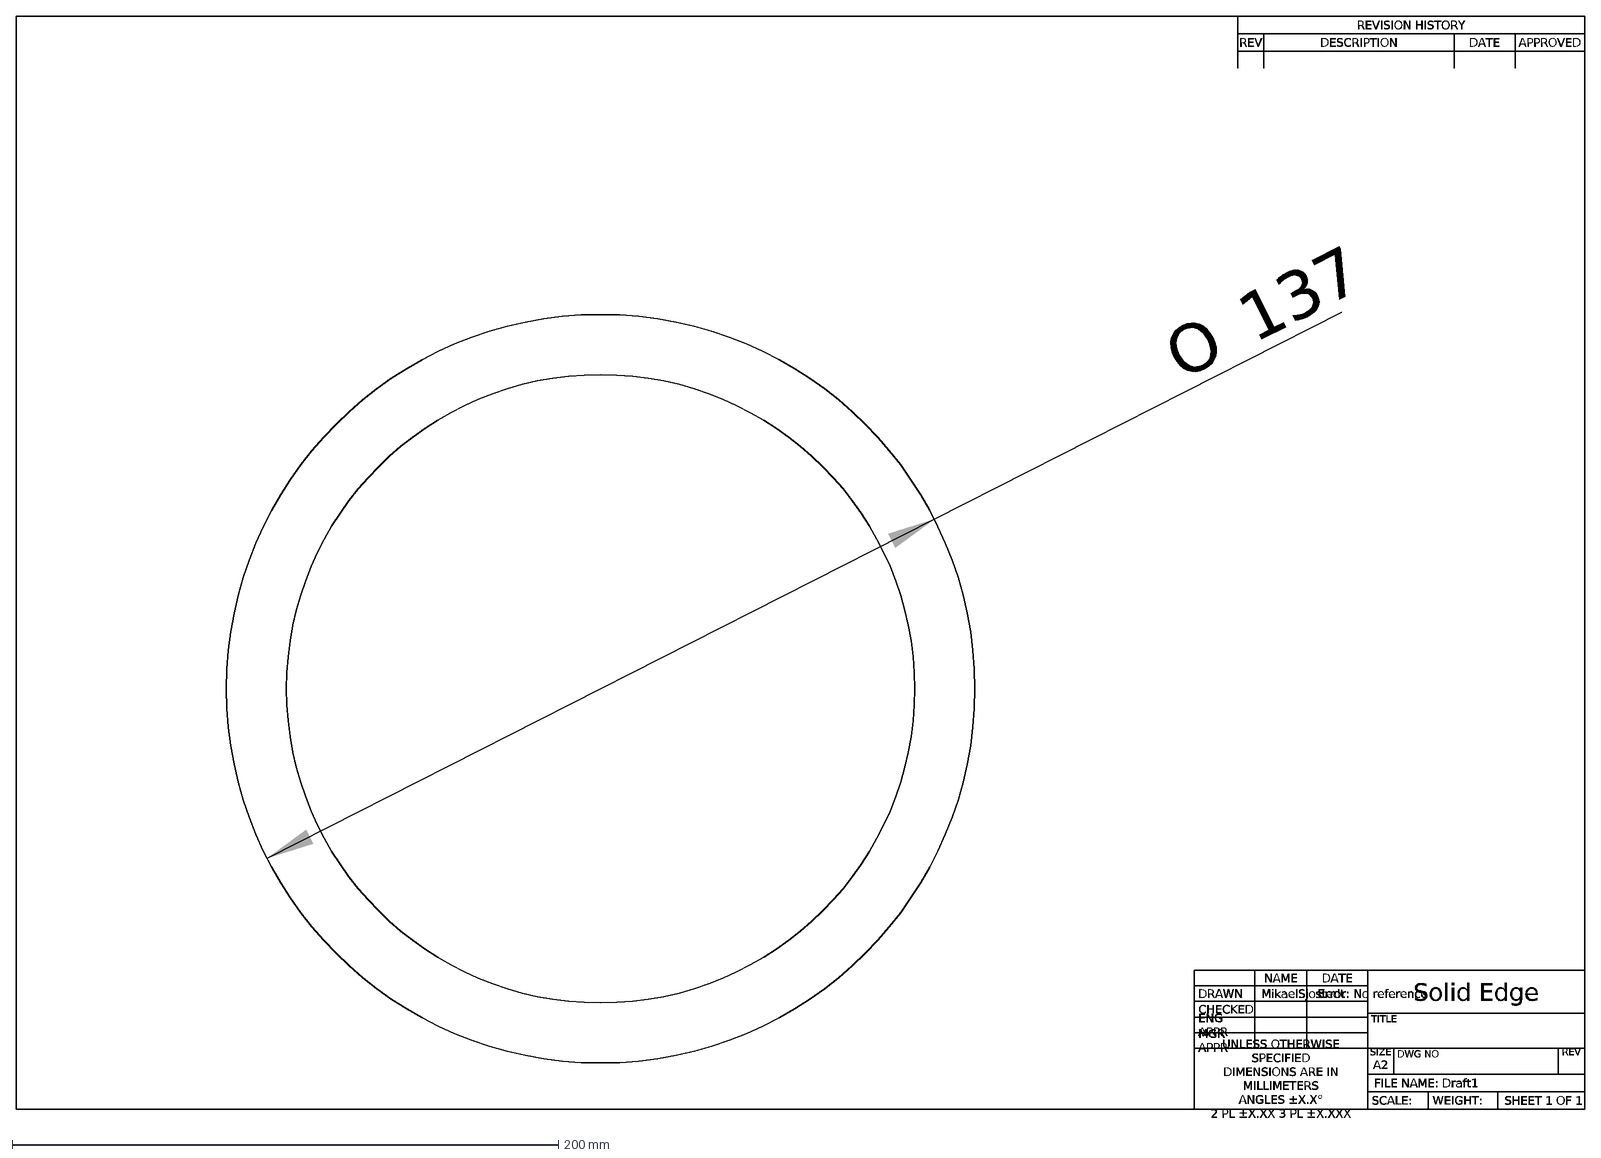
[picture p84: CAD file, 2015-05-16]
CAD/Flywheel new/Flywheelcircle.dxf
O
137
DRAWN
CHECKED
ENG APPR
MGR APPR
UNLESS OTHERWISE SPECIFIED DIMENSIONS ARE IN MILLIMETERS ANGLES ±X.X° 2 PL ±X.XX 3 PL ±X.XXX
NAME
MikaelSjostedt
DATE
Error: No reference
Solid Edge
TITLE
SIZE
A2
DWG NO
REV
FILE NAME: Draft1
SCALE:
WEIGHT:
SHEET 1 OF 1
REVISION HISTORY
DESCRIPTION
APPROVED
