Axram/CubeProject/CAD/IMUcad/MPU-9150_(Chip).SLDPRT

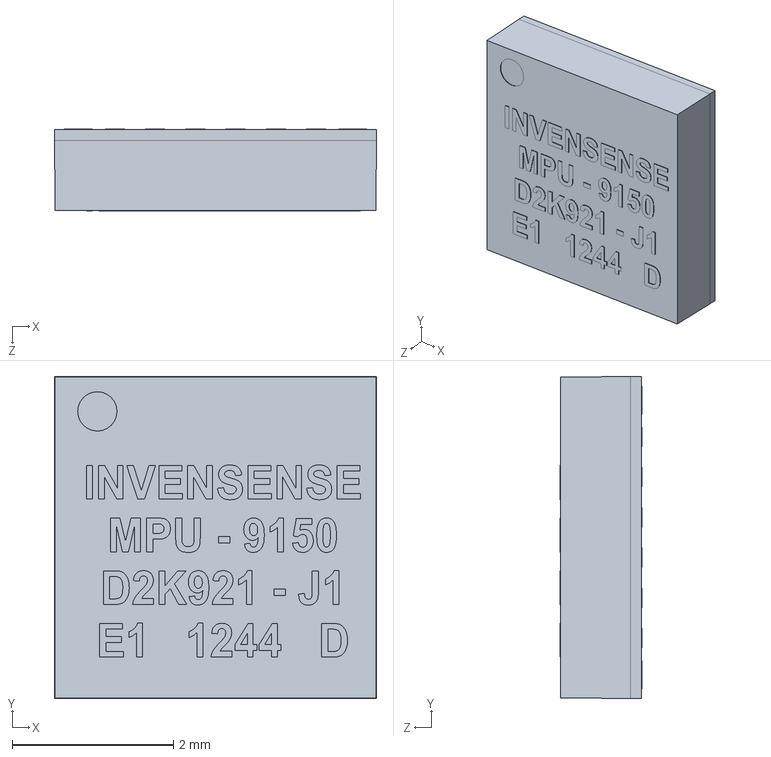
[picture p86: CAD file, 2015-05-10]
CAD/IMUcad/MPU-9150_(Chip).SLDPRT
4.00 x 4.00 x 1.02 mm
