Axram/CubeProject/CAD/Motor Controller/EZ4AXIS.STEP

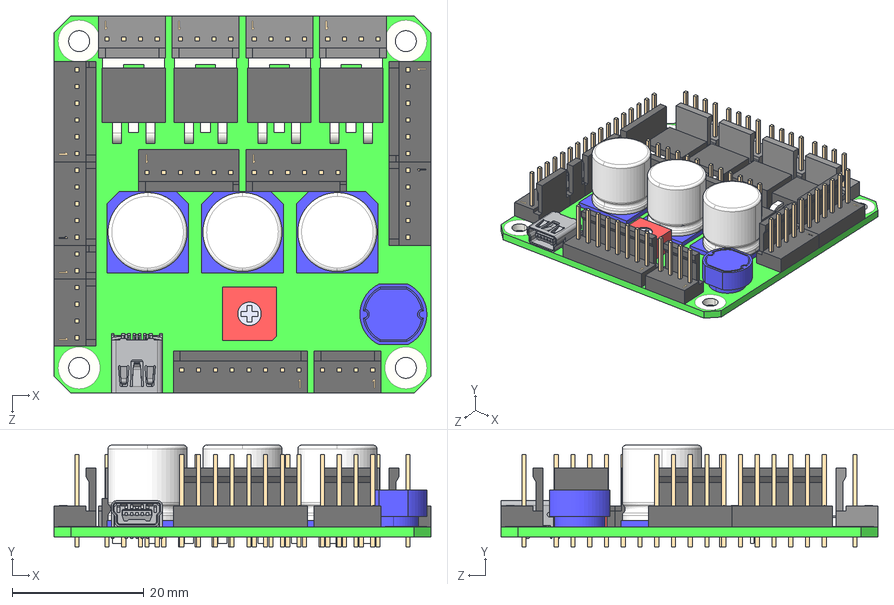
[picture p87: CAD file, 2015-05-10]
CAD/Motor Controller/EZ4AXIS.STEP
57.2 x 15.4 x 57.2 mm
CONNECTOR_8PIN
IC_1_2
POT_1
PCB_2
CONNECTOR_4PIN_1 x 4
CONNECTOR_6PIN_1 x 4
CONNECTOR_5PIN x 2
CONNECTOR_4PIN x 2
USB-Mini-B
COIL_6
IC_1_1
IC_1_5
COIL_3_2 x 3
CONNECTOR_2PIN
IC_1
