Axram/CubeProject/Mixed/IMUplatform.stl

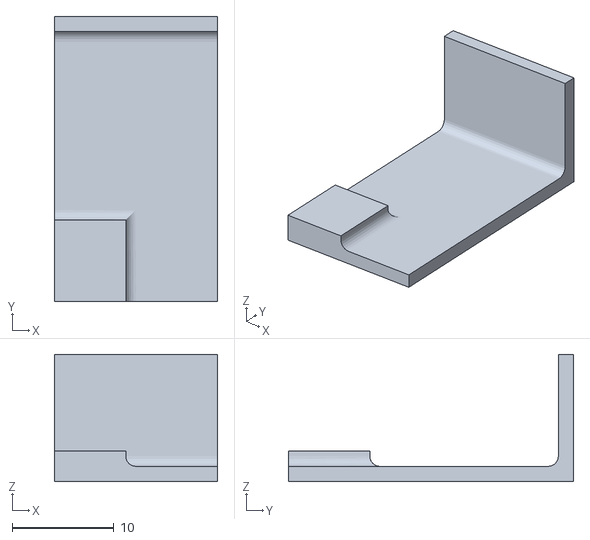
[picture p89: CAD file, 2015-05-20]
Mixed/IMUplatform.stl
16.0 x 28.0 x 12.5
