Axram/CubeProject/CAD/IMUcad/MPU-9150_(CI_Board).SLDPRT

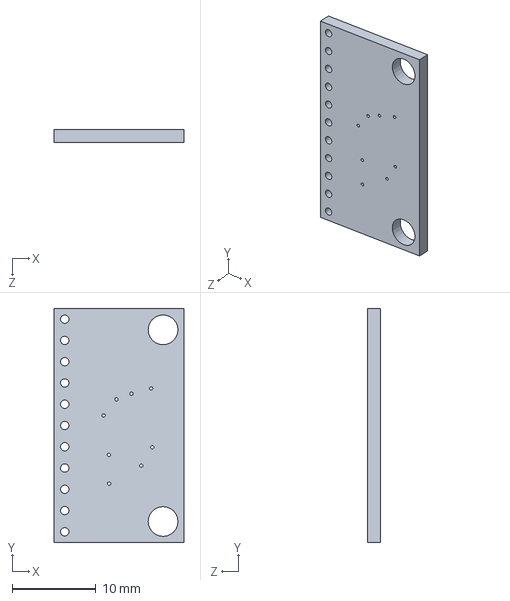
[picture p92: CAD file, 2015-05-10]
CAD/IMUcad/MPU-9150_(CI_Board).SLDPRT
15.5 x 27.9 x 1.60 mm
