Axram/CubeProject/CAD/IMUn.stl

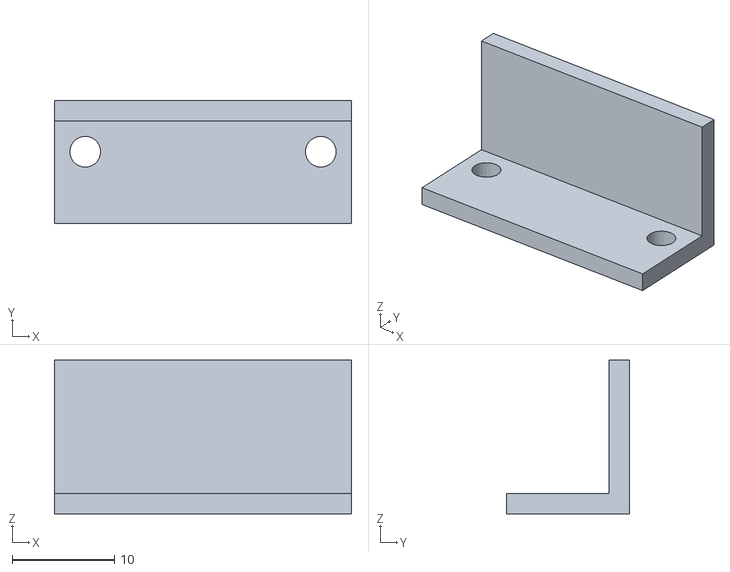
[picture p93: CAD file, 2015-05-05]
CAD/IMUn.stl
29.0 x 12.0 x 15.0
