Axram/CubeProject/CAD/IMUcad/MPU-9150_(0603_SMD1).SLDPRT

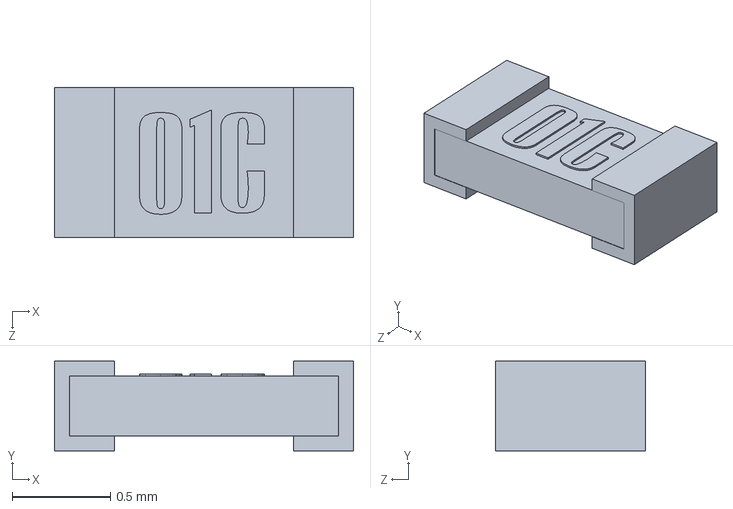
[picture p95: CAD file, 2015-05-10]
CAD/IMUcad/MPU-9150_(0603_SMD1).SLDPRT
1.52 x 0.457 x 0.767 mm
