Axram/CubeProject/(list of files, cad)

Other CAD files:
CAD/IMUcad/MPU-9150_(Assembly).SLDASM
CAD/CubCad/framsida.dwg
CAD/CubCad/mittsk.dwg
CAD/CubCad/bakdel.dwg
CAD/IMUcad/MPU-9150_(0603_SMD2).SLDPRT
CAD/Flywheel/motorf1.dwg
CAD/Motor Controller/EZ4AXIS.stl
