Axram/CubeProject/Thesis/setup_0.bmp

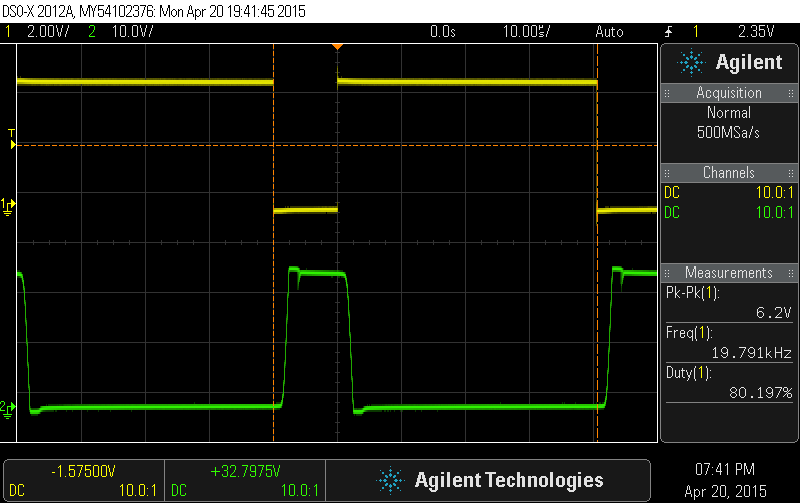
Thesis/setup_0.bmp
