Axram/CubeProject/Thesis/setup_2.bmp

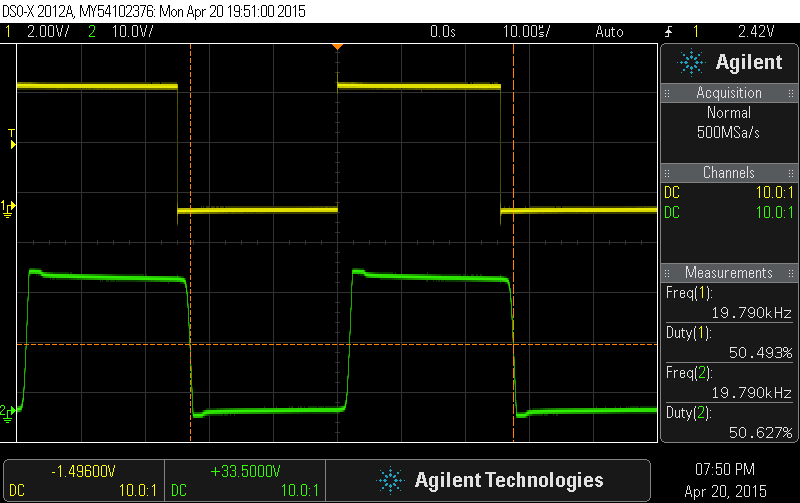
Thesis/setup_2.bmp
