Axram/CubeProject/Thesis/setup_3.bmp

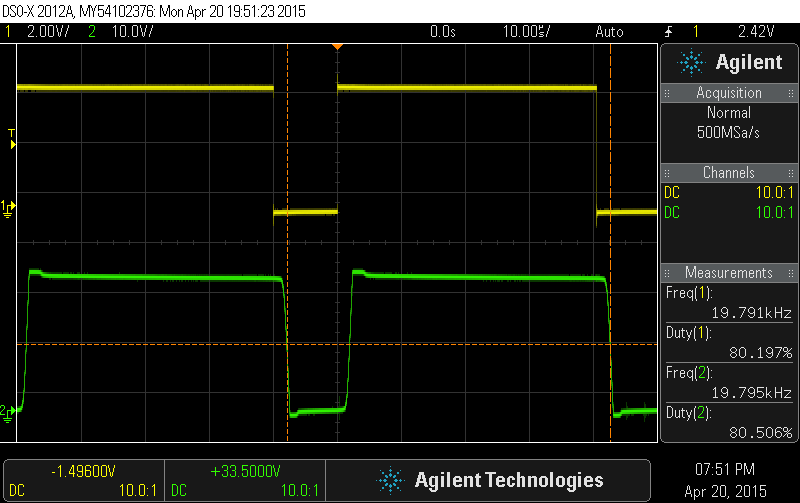
Thesis/setup_3.bmp
