Axram/CubeProject/Mixed/testfront.pdf

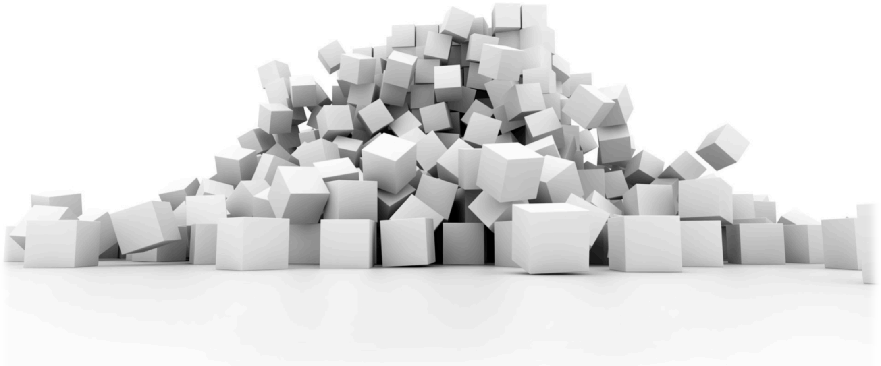
[picture p99: page 1]
