Axram/CubeProject/Thesis/gyroscopeallan-eps-converted-to.pdf

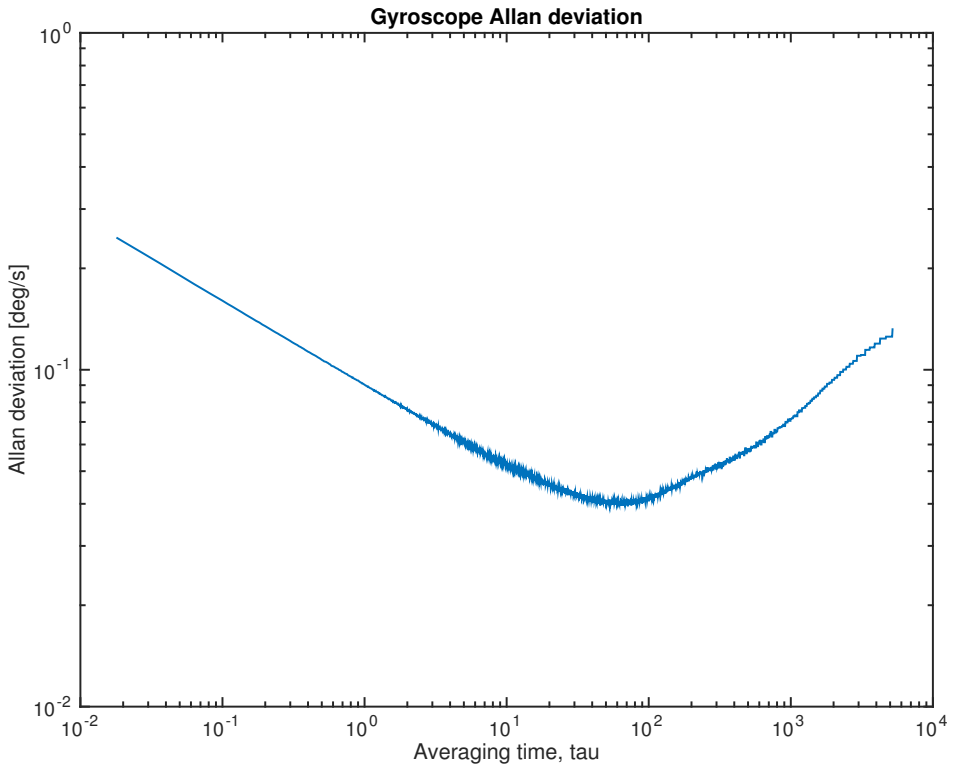
[picture p100: page 1]

Gyroscope Allan deviation

Allan deviation [deg/s]

Averaging time, tau
