Axram/CubeProject/Thesis/Kalmanturn-eps-converted-to.pdf

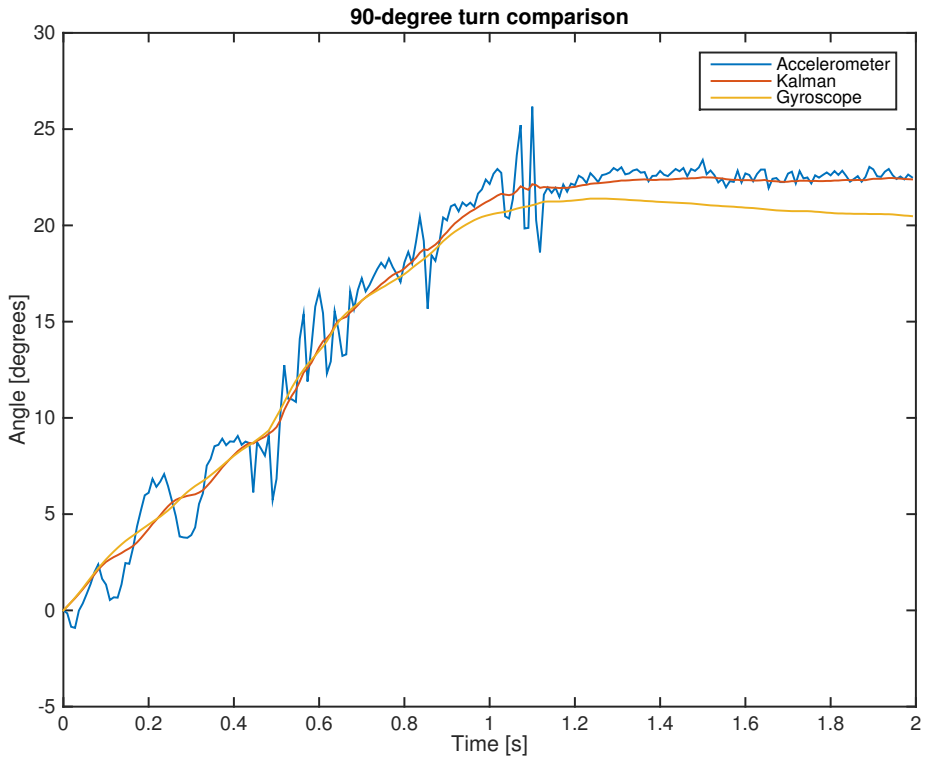
[picture p101: page 1]
Time [s]; Angle [degrees]; Accelerometer Kalman Gyroscope

90-degree turn comparison
