Axram/CubeProject/Thesis/result1-eps-converted-to.pdf

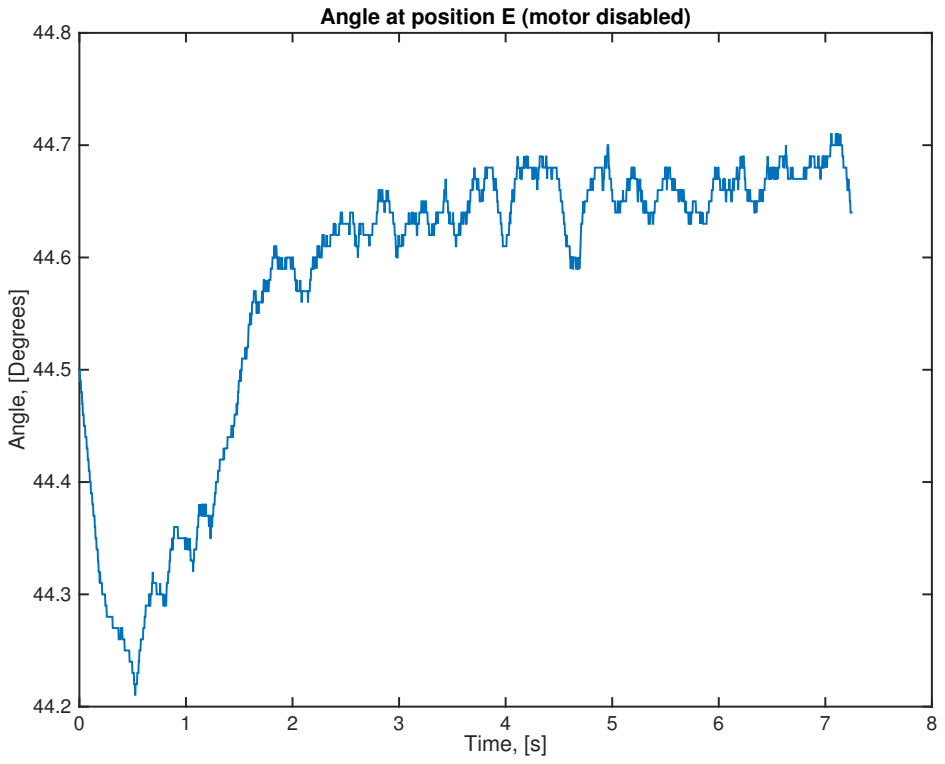
[picture p102: page 1]
Time, [s]; Angle, [Degrees]

Angle at position E (motor disabled)
