Axram/CubeProject/Thesis/Stationarycomparison-eps-converted-to.pdf

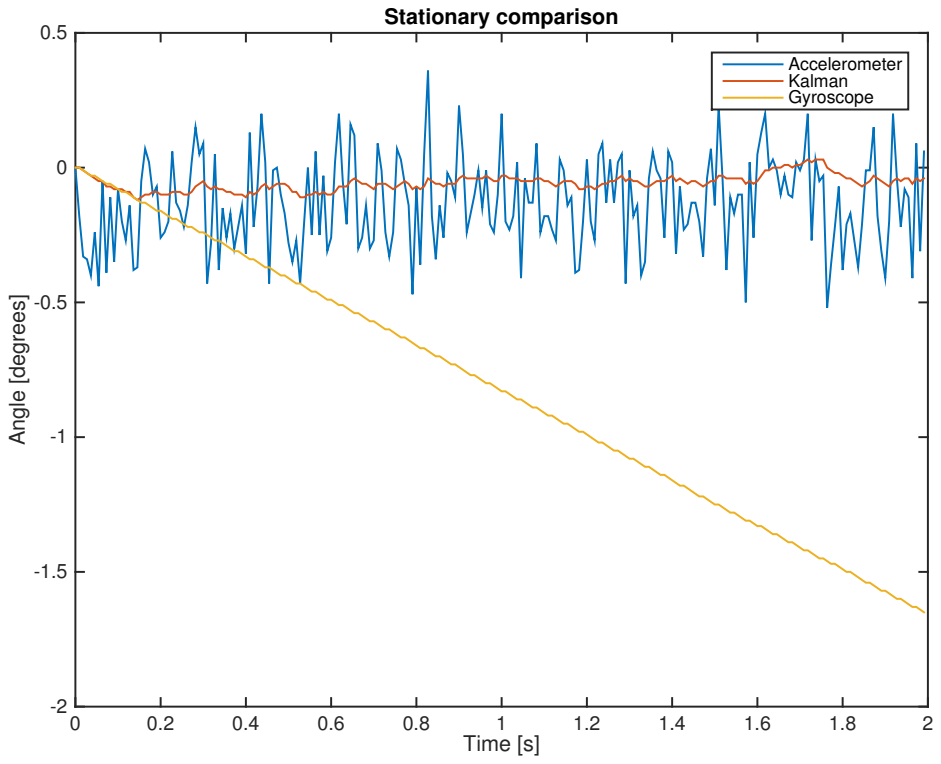
[picture p103: page 1]
Time [s]; Angle [degrees]; Stationary comparison; Accelerometer Kalman Gyroscope
