Axram/CubeProject/Thesis/Motor_noload-eps-converted-to.pdf

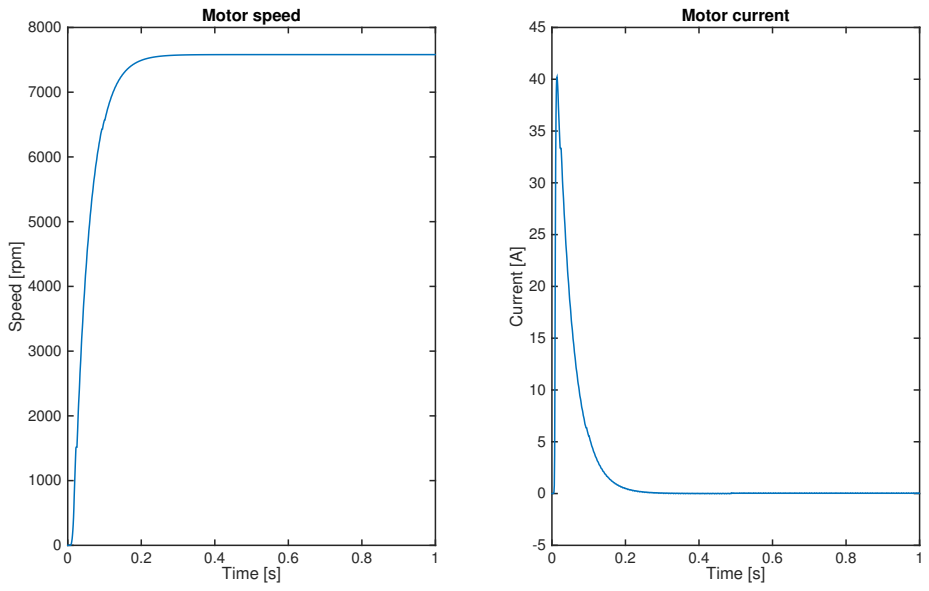
[picture p104: page 1]
Time [s]; Speed [rpm]; Motor speed; Current [A]; Motor current
