Axram/CubeProject/Thesis/Voltageplot-eps-converted-to.pdf

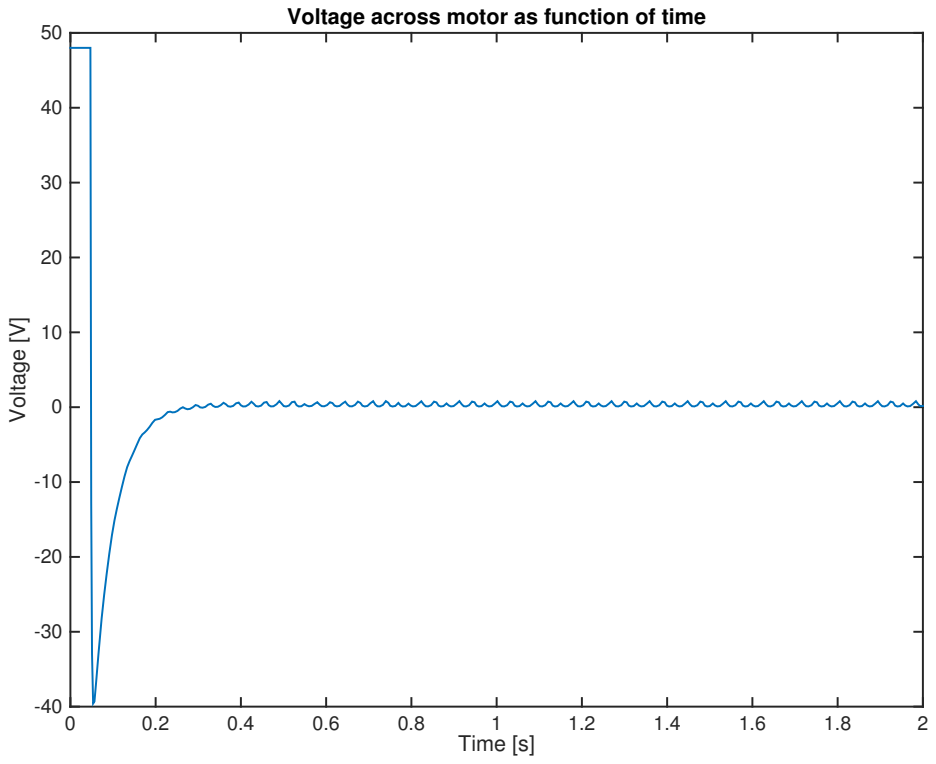
[picture p105: page 1]
Time [s]; Voltage [V]

Voltage across motor as function of time
