Axram/CubeProject/CAD/CubCad/bakdel.pdf

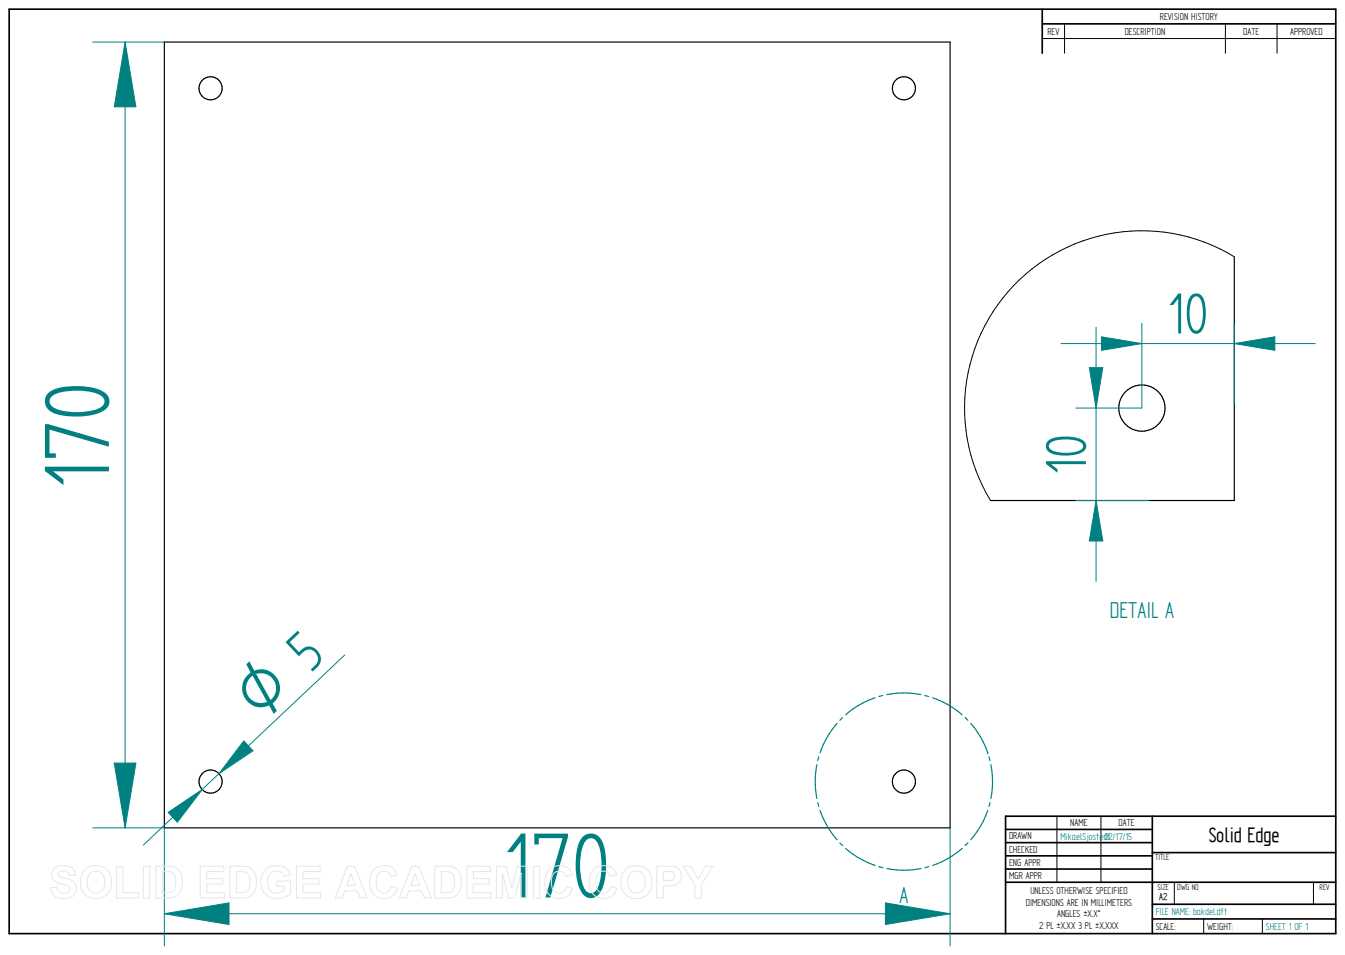
[picture p106: page 1]
TITLE; SCALE:; WEIGHT:; SHEET 1 OF 1; DETAIL A

REVISION HISTORY

REV | DESCRIPTION | DATE | APPROVED

NAME | DATE | Solid Edge

DRAWN | MikaelSjostedt | 02/17/15
CHECKED
ENG APPR
MGR APPR
UNLESS OTHERWISE SPECIFIED DIMENSIONS ARE IN MILLIMETERS ANGLES ±X.X° 2 PL ±X.XX 3 PL ±X.XXX | SIZE A2 | DWG NO | REV

FILE NAME: bakdel.dft
