Axram/CubeProject/CAD/Flywheel/flywheel12.pdf

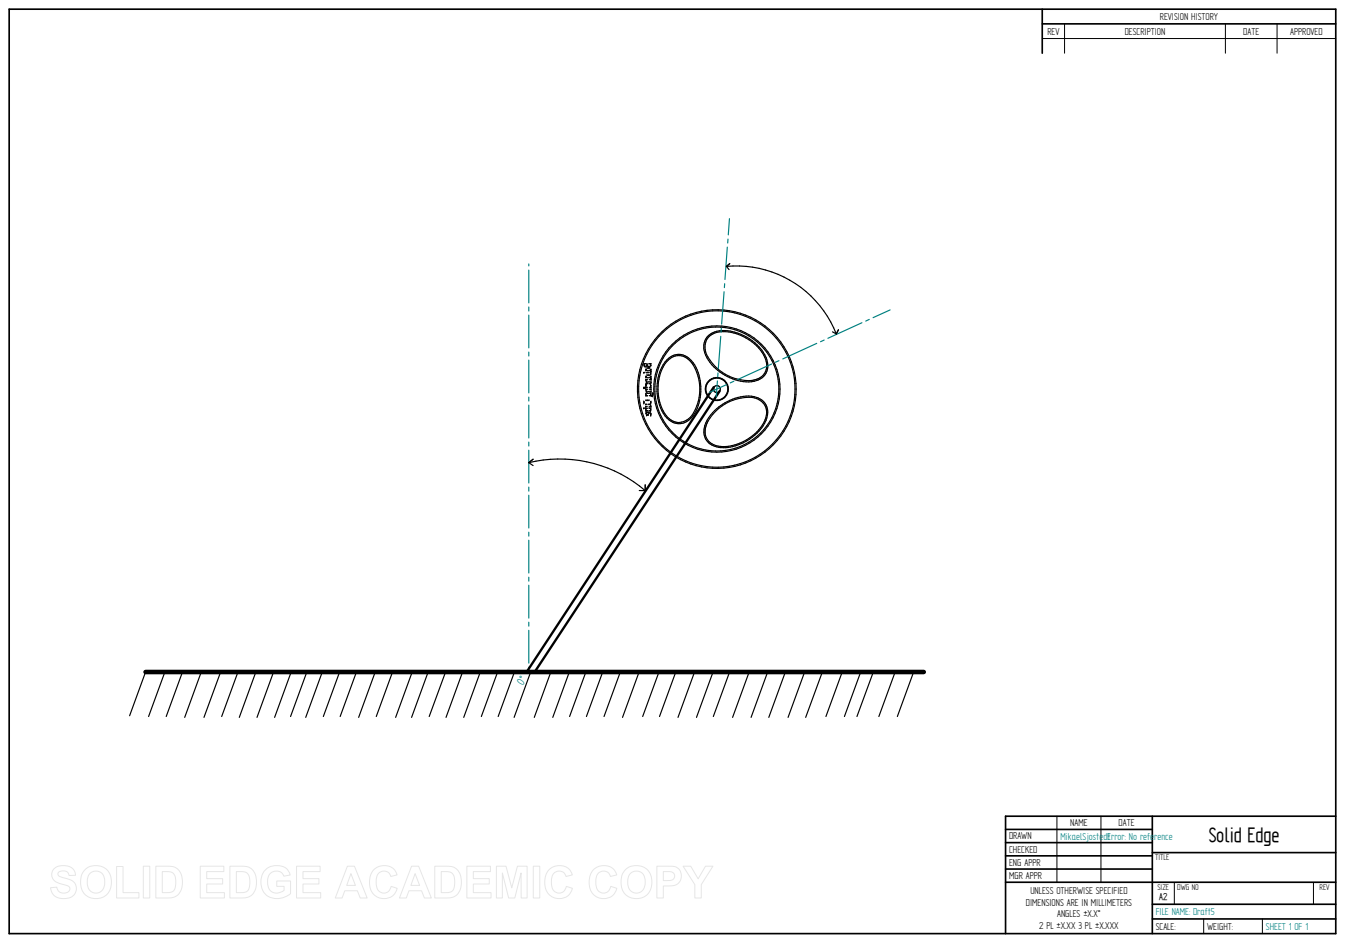
[picture p107: page 1]
TITLE; FILE NAME: Draft5; SCALE:; WEIGHT:; SHEET 1 OF 1

REVISION HISTORY

REV | DESCRIPTION | DATE | APPROVED

NAME | DATE | Solid Edge

DRAWN | MikaelSjostedt | Error: No reference
CHECKED
ENG APPR
MGR APPR
UNLESS OTHERWISE SPECIFIED DIMENSIONS ARE IN MILLIMETERS ANGLES ±X.X° 2 PL ±X.XX 3 PL ±X.XXX | SIZE A2 | DWG NO | REV
