Axram/CubeProject/Thesis/result2-eps-converted-to.pdf

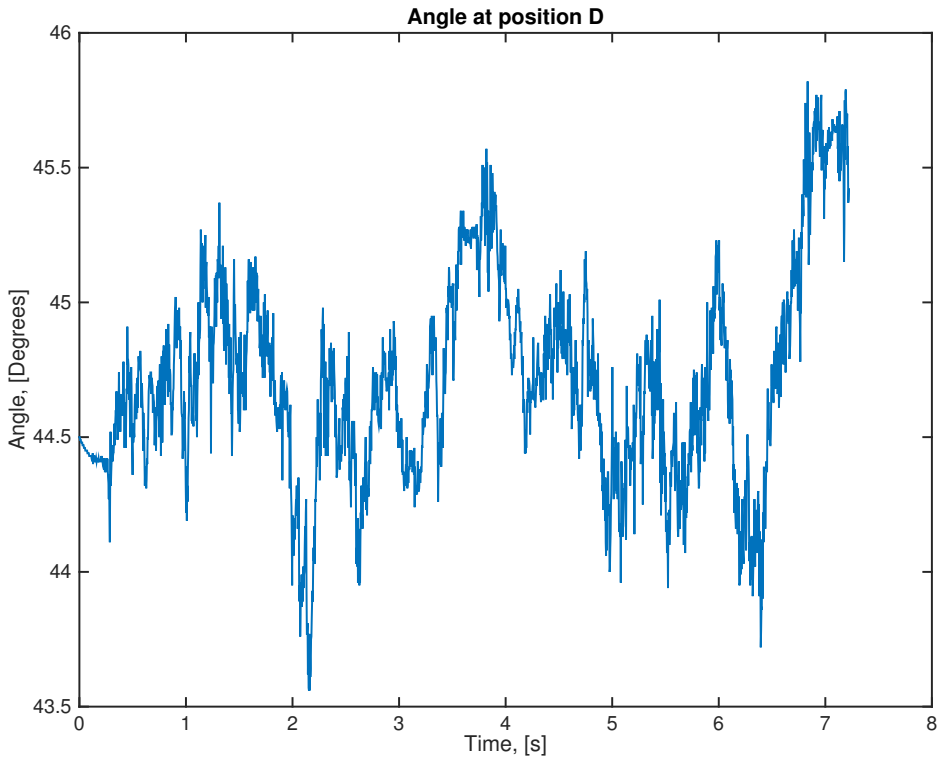
[picture p108: page 1]
Time, [s]; Angle, [Degrees]

Angle at position D
