Axram/CubeProject/Thesis/total_schem.pdf

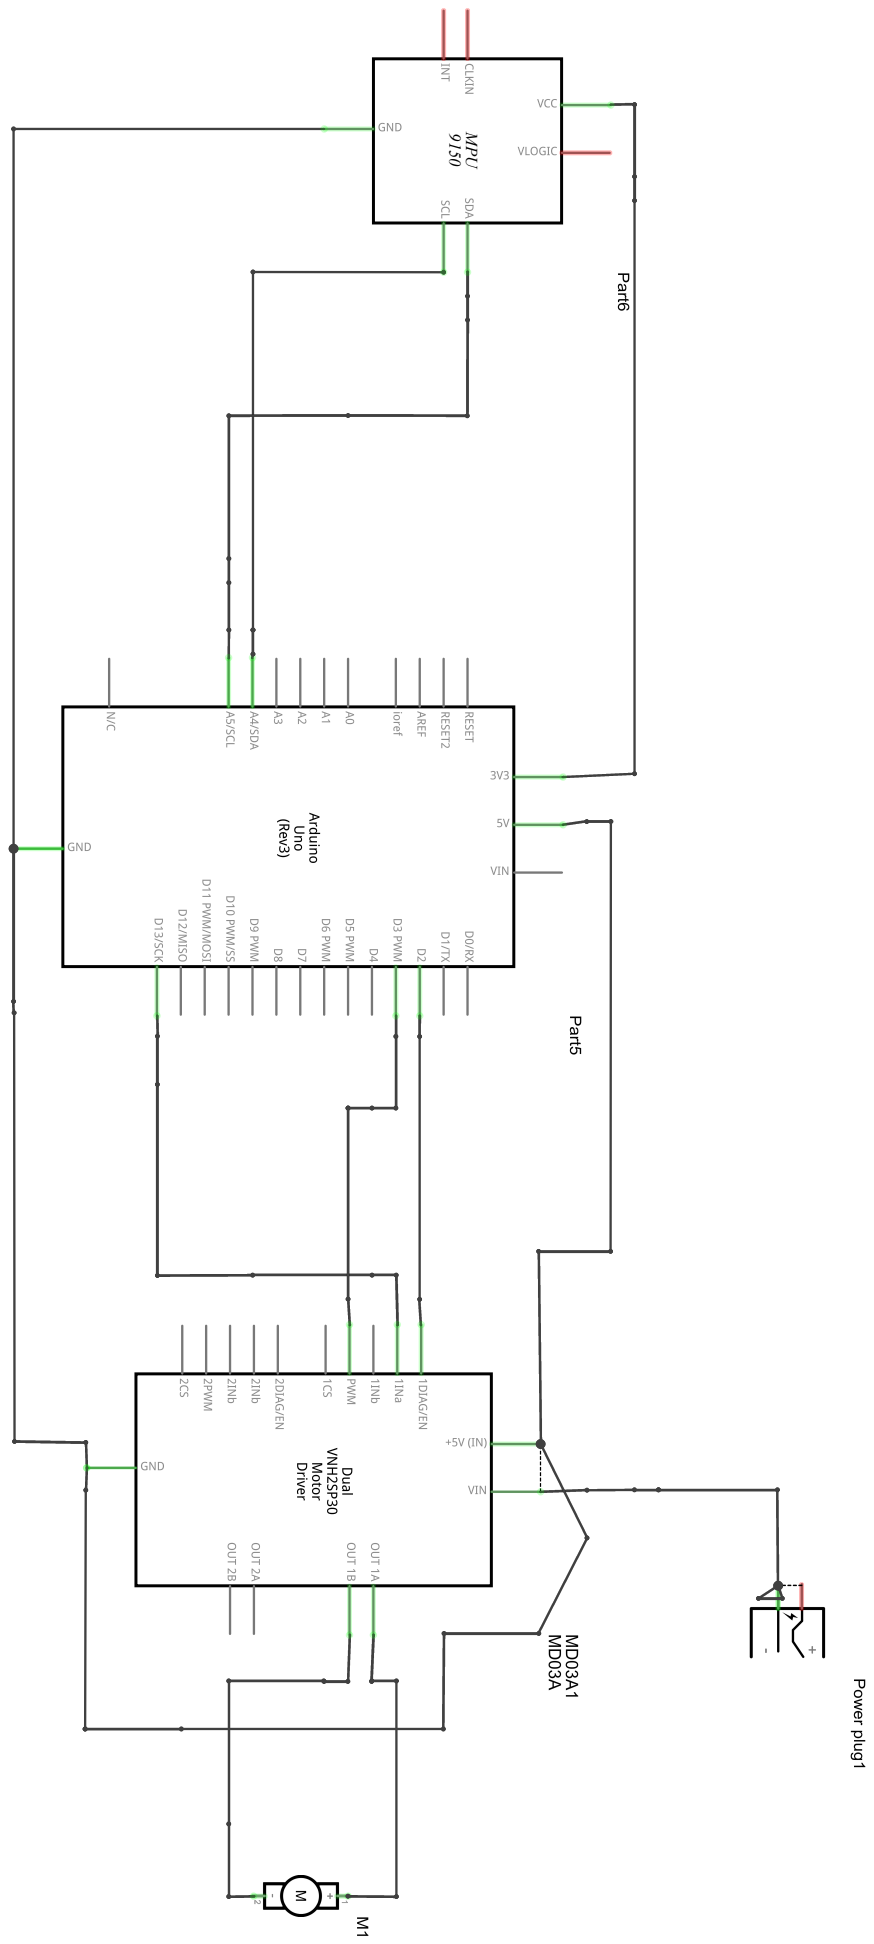
[picture p109: page 1]
