Axram/CubeProject/Thesis/Lagrangeflywheel.pdf

φ

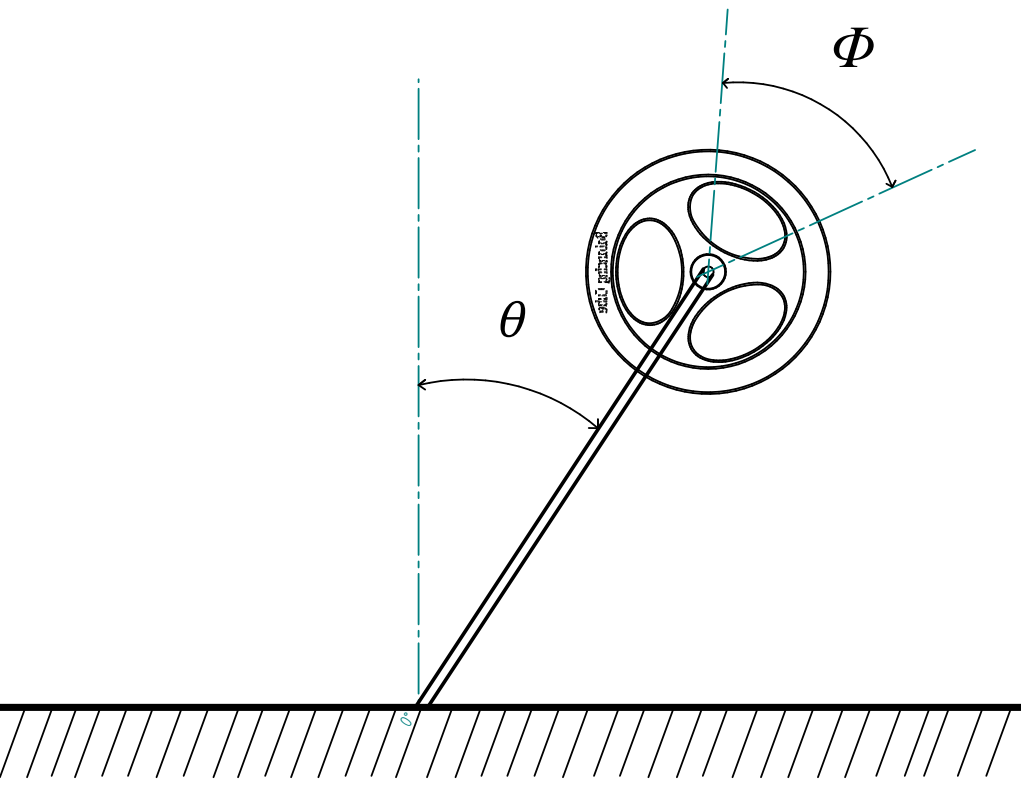
[picture p110: page 1]
