Axram/CubeProject/Thesis/Lagrangeflywheel1.pdf

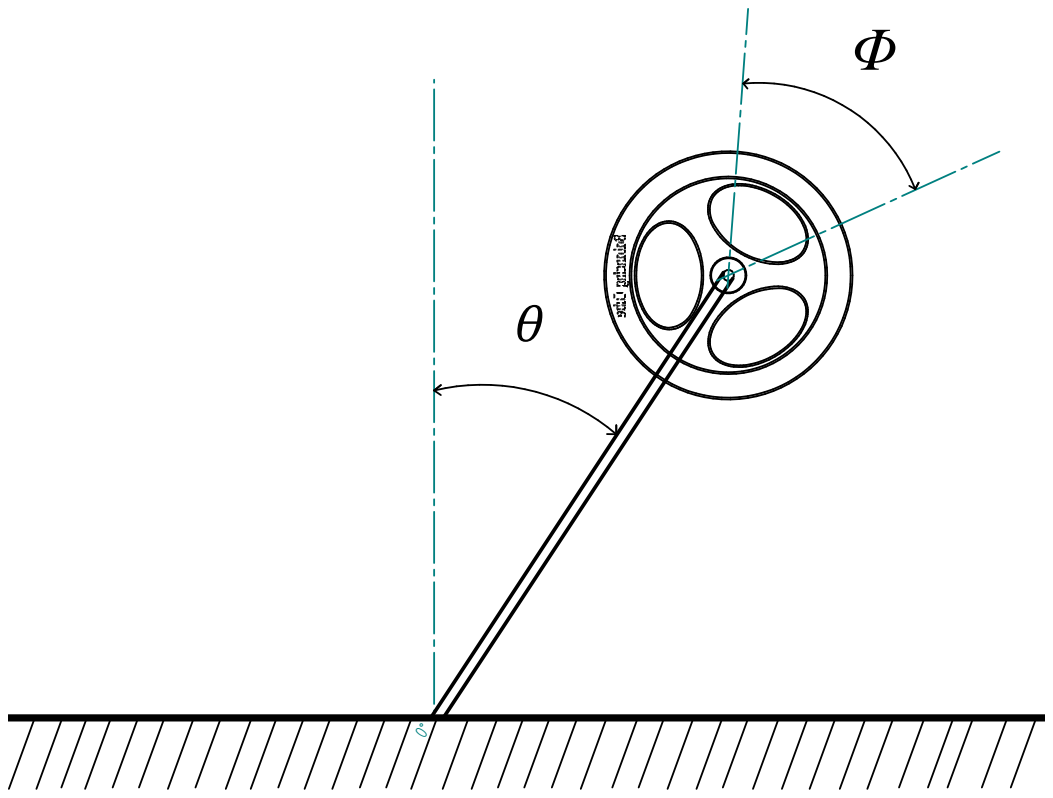
[picture p111: page 1]
