Axram/CubeProject/Thesis/concept.pdf

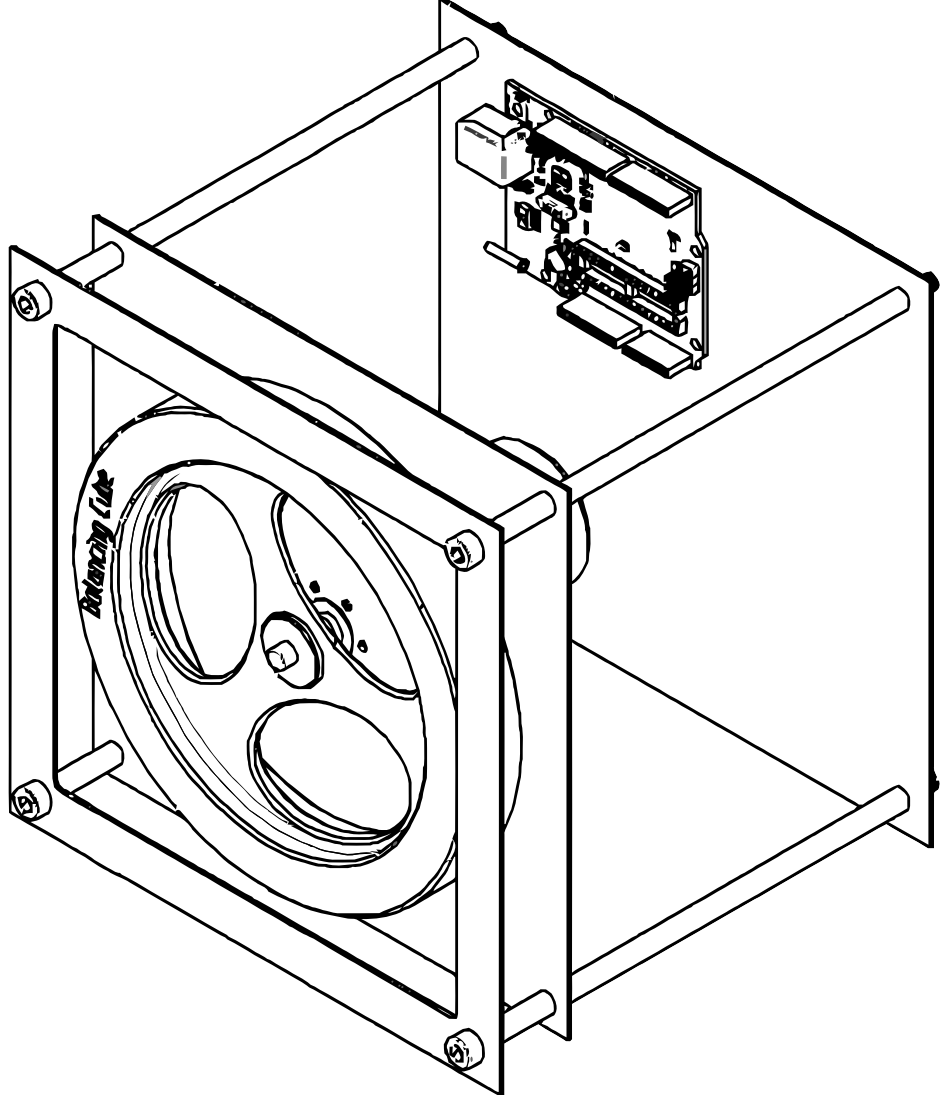
[picture p112: page 1]
