Axram/CubeProject/Thesis/Kalmancomparisonstat-eps-converted-to.pdf

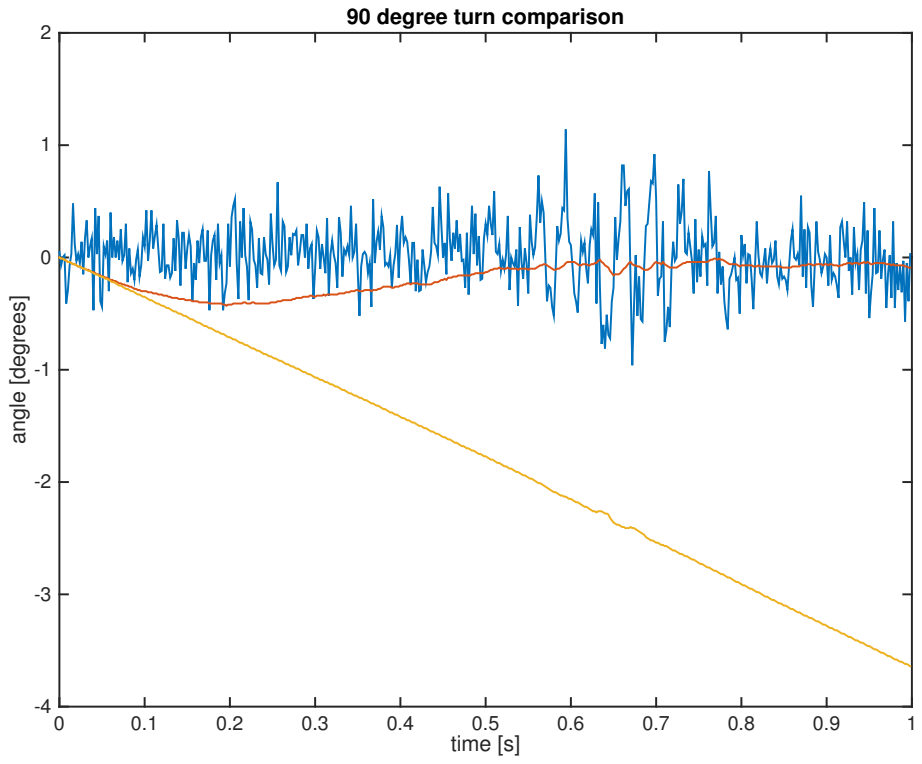
[picture p113: page 1]
time [s]; angle [degrees]

90 degree turn comparison
