Axram/CubeProject/Thesis/Kalmancomparisonturn-eps-converted-to.pdf

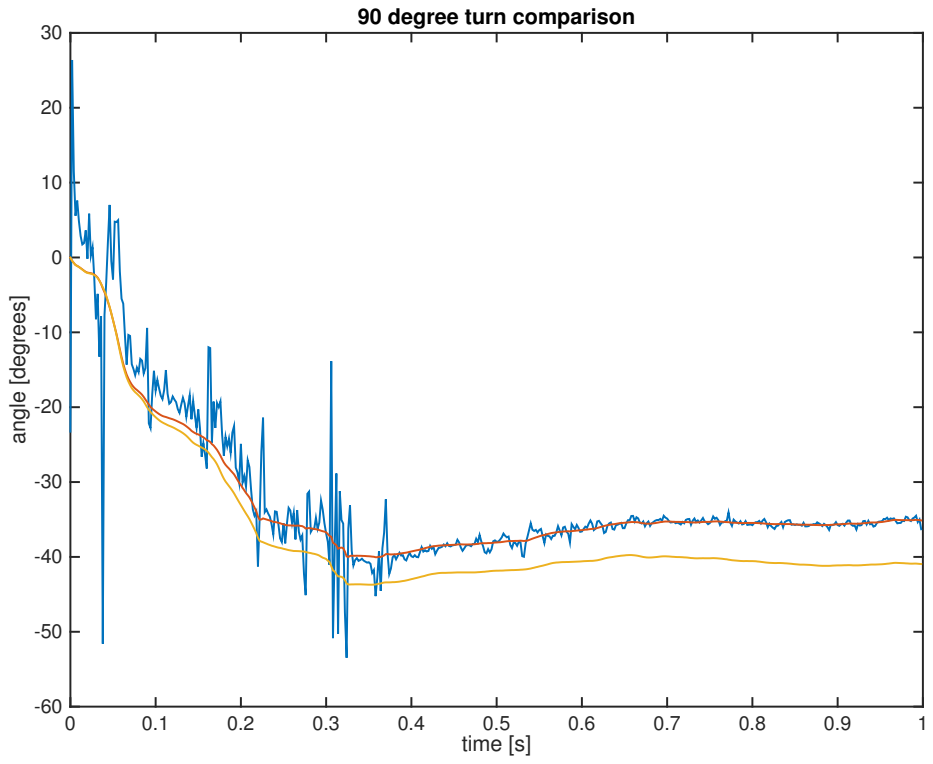
[picture p114: page 1]
time [s]; angle [degrees]

90 degree turn comparison
