Axram/CubeProject/Thesis/Kalmancomparisonturnzoom-eps-converted-to.pdf

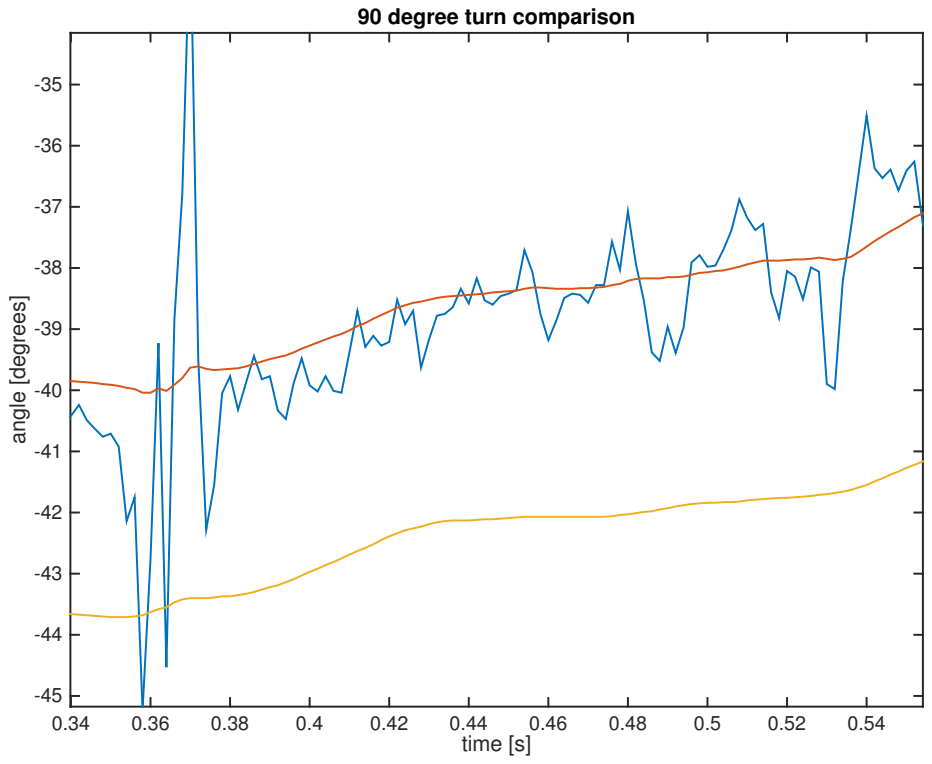
[picture p115: page 1]
time [s]; angle [degrees]

90 degree turn comparison
