Axram/CubeProject/Thesis/Kalmancomparisonplot-eps-converted-to.pdf

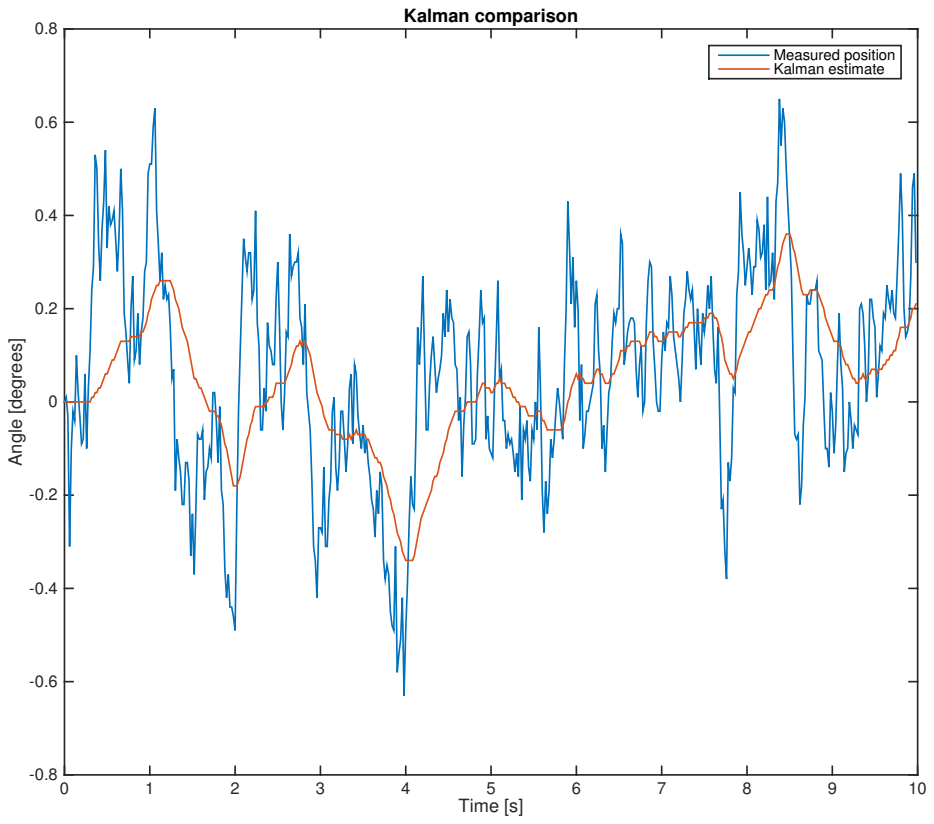
[picture p116: page 1]
Time [s]; Angle [degrees]; Kalman comparison; Measured position Kalman estimate
