Axram/CubeProject/Thesis/angleplot-eps-converted-to.pdf

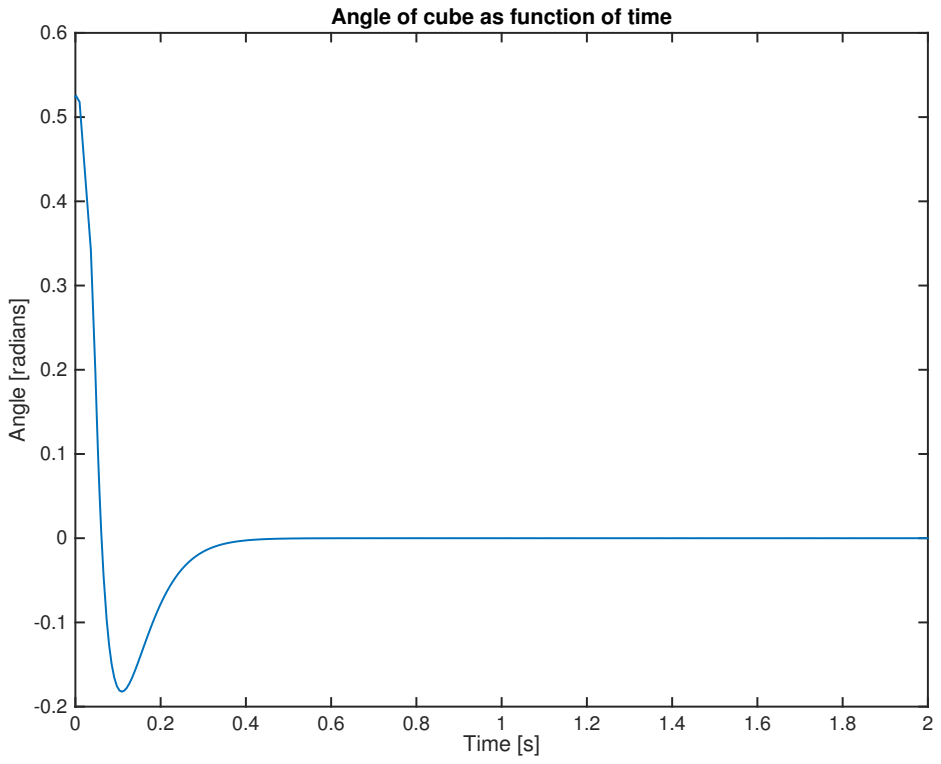
[picture p117: page 1]
Time [s]; Angle [radians]

Angle of cube as function of time
