Axram/CubeProject/Thesis/simmodel-eps-converted-to.pdf

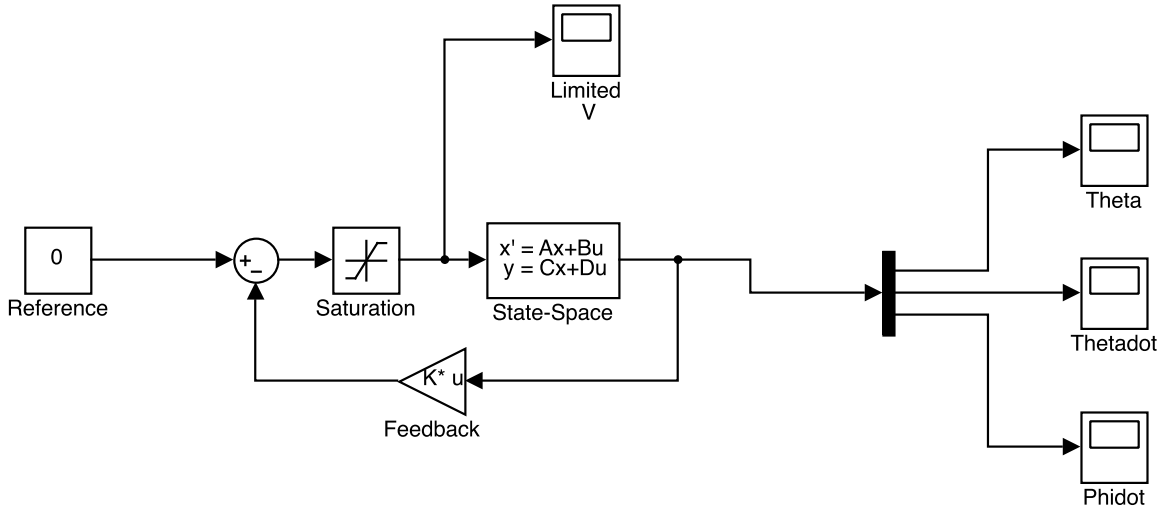
[picture p118: page 1]
