Axram/CubeProject/Thesis/KTH_Logotyp_PMS_2013-eps-converted-to.pdf

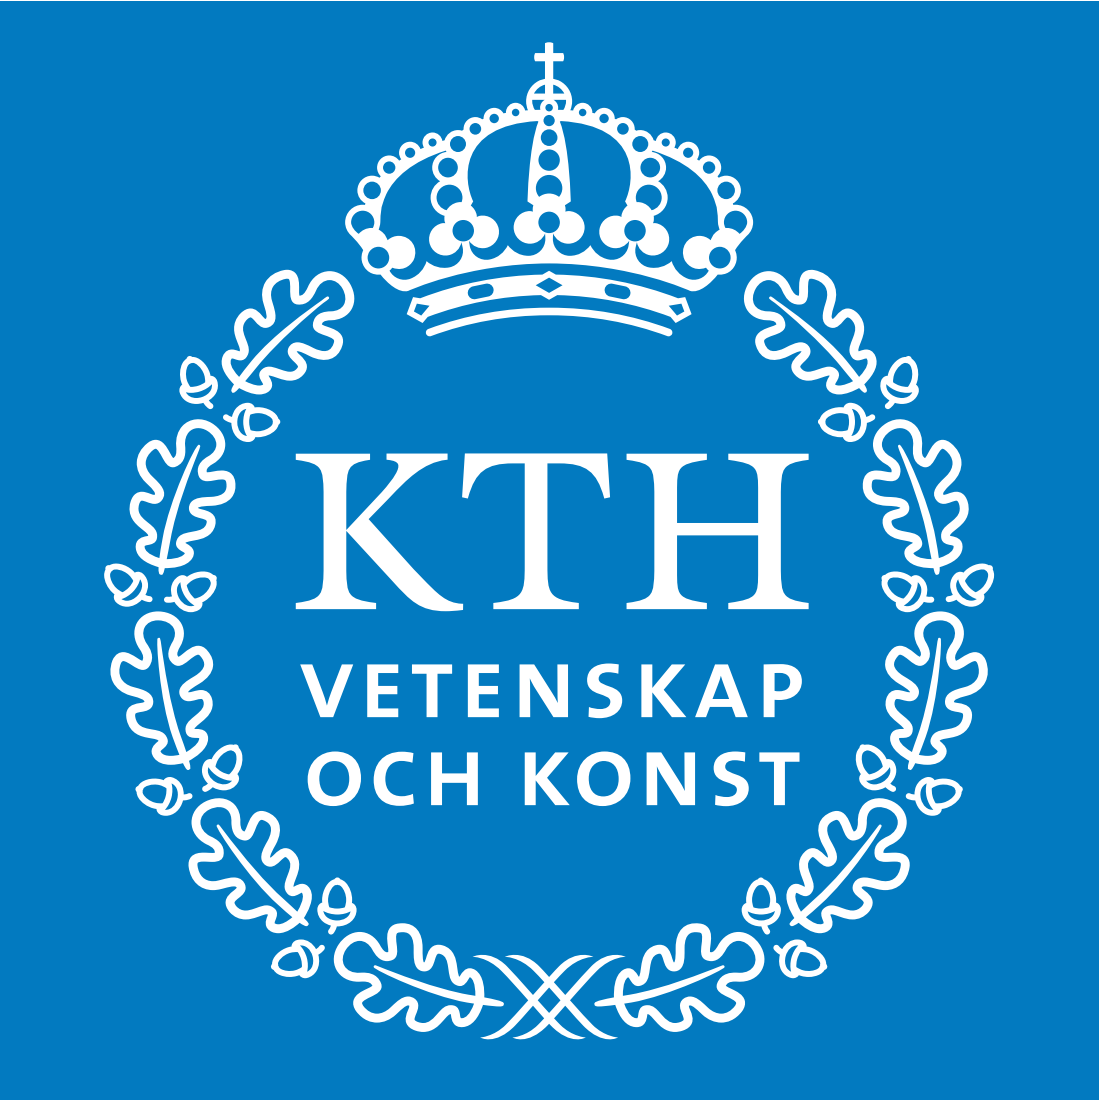
[picture p119: page 1]
