Axram/CubeProject/CAD/Flywheel/Lagrangeflywheel.pdf

φ

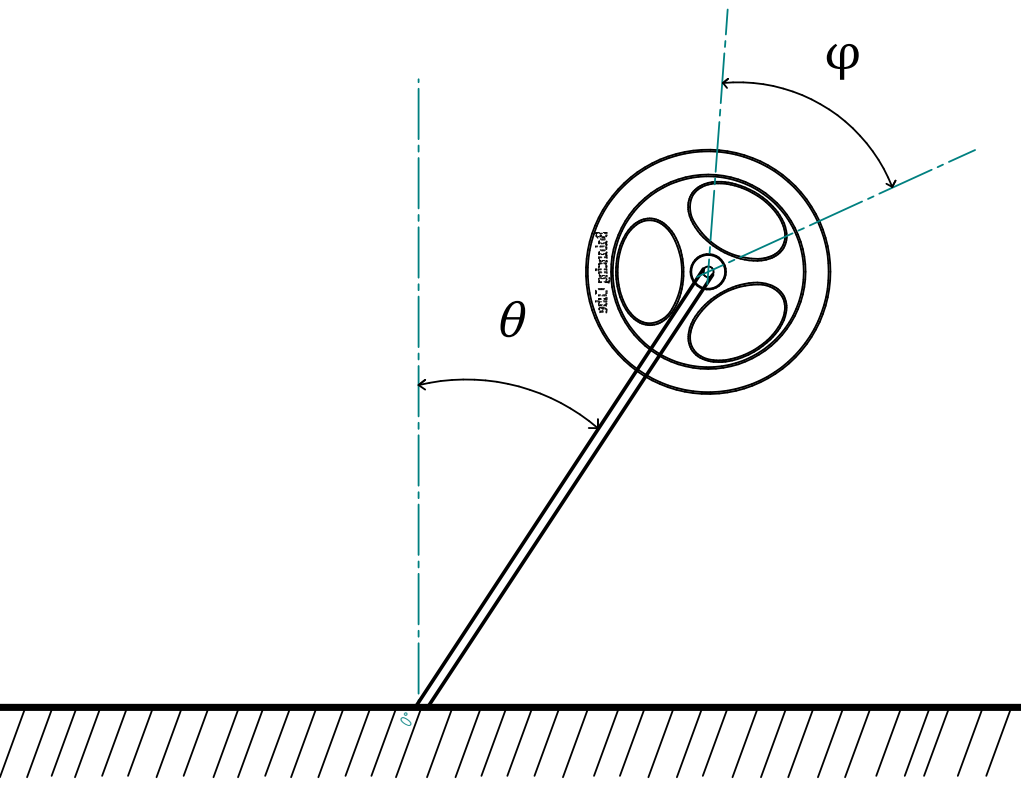
[picture p120: page 1]
