Axram/CubeProject/(commit log)

2015-04-11 Mer uppdateringar
    Tillägg i Kalman, Arduino, och tex
2015-04-30 Cad change
2015-05-02 Inläng
    Har släng in råtext, behöver dock fixas i "flowet"
2015-05-06 Kommer meeraa
    [motorf1.dxf]
2015-05-10 Trötter
    [Cub.cfg]
2015-05-20 final v2
    [IMUplatform.stl, knivg.cfg]
